Twilight-Logic/AR488/(threads)

Thread 2 (2019-02-10):

Invalid conversion from 'void (*)()' to 'void (*)(char*) compilation errors

Twilight-Logic, 2019-02-10:
..does not compile. Errors are
AR488-0-45-10:758: error: invalid conversion from 'void (*)()' to 'void (*)(char*)' [-fpermissive]
plenty of them..
AR488-0-45-10:758: error: invalid conversion from 'void (*)()' to 'void (*)(char*)' [-fpermissive]

UPDATE:
error handling seems to have been downgraded to warnings after updating Arduino IDE fro 1.6.5 to 1.8.19
Kutte

Twilight-Logic, 2019-02-12:
Have tested with the standalone IDE version 1.8.7 and 1.8.8 downloaded directly from the Arduino site and did not receive the errors or warnings. However, then tested with v1.8.8/1.8.19.0 downloaded from the Windows 10 store and discovered that these warnings do indeed appear.

Will investigate further to see whether the code can be adjusted to avoid them.

Twilight-Logic, 2019-02-12:
Line 413: changed the expression NULL to character expression '\0'.

Twilight-Logic, 2019-02-14:
Further warnings reported by Kutte:

Y:\USB_16GB\Voltage reference\GPIB\ar488-arduino\ar488\AR488.ino:153:0: warning: "SPE" redefined

 #define SPE 0x18

In file included from c:\program files (x86)\arduino\hardware\tools\avr\avr\include\avr\io.h:272:0,
                 from c:\program files (x86)\arduino\hardware\tools\avr\avr\include\avr\pgmspace.h:90,
                 from C:\Program Files (x86)\Arduino\hardware\arduino\avr\cores\arduino/Arduino.h:28,
                 from sketch\AR488.ino.cpp:1:
c:\program files (x86)\arduino\hardware\tools\avr\avr\include\avr\iom328p.h:294:0: note: this is the location of the previous definition
 #define SPE 6
Y:\USB_16GB\Voltage reference\GPIB\ar488-arduino\ar488\AR488.ino:758:1: warning: ISO C++ forbids converting a string constant to 'char*' [-Wwrite-strings]

 Y:\USB_16GB\Voltage reference\GPIB\ar488-arduino\ar488\AR488.ino:758:1: warning: ISO C++ forbids converting a string constant to 'char*' [-Wwrite-strings]

Y:\USB_16GB\Voltage reference\GPIB\ar488-arduino\ar488\AR488.ino:758:1: warning: invalid conversion from 'void (*)()' to 'void (*)(char*)' [-fpermissive]

Y:\USB_16GB\Voltage reference\GPIB\ar488-arduino\ar488\AR488.ino:758:1: warning: ISO C++ forbids converting a string constant to 'char*' [-Wwrite-strings]

Twilight-Logic, 2019-03-01:
In the new release of the code (0.46.01), the names of the #define variables related to GPIB commands (e.g. SPE) have been changed to avoid clashes with other Arduino modules.

Twilight-Logic, 2019-03-25:
Further corrections made to the code to remove all warnings. By default it seems that this setting is now set to None, so all warnings were hidden. Compilation is now done with the Arduino IDE set to show ALL compiler warnings.

Closed 2019-03-25.

Thread 4 (2019-03-03):

Ground

cabo, 2019-03-03:
Shouldn't the manual point out that it is good to have a ground connection?
(Or, actually, seven of them?)
Maybe too obvious to an EE :-)

Twilight-Logic, 2019-03-12:
Thanks for pointing this out. The table in the manual was focused on the control and data bus wires but indeed the ground connection should not be omitted. I will be adding a couple of diagrams to the manual and will correct this oversight at he same time.

Closed 2019-03-25.

Thread 5 (2019-03-04):

First character of ++read result is being garbled when reading some devices

Twilight-Logic, 2019-03-04:
Reported by user Krampmeier on EEVblog, using version v0.46.10.

Version 0.46.01:

Communication with my HP 4192A impedance analyzer sees to work fine, but when I sent *IDN? to a Keithley 2001, the first 1 to 3 characters of the response were always wrong. Same with a Keithley 2010.

I just tried it again:
Quote

    *idn?
    ++read
    OEITHLEY INSTRUMENTS INC.,MODEL 2010,0632912,A15  /A02
    fetch?
    ++read
    m9.59916086E-01
    :SENS:FUNC?
    ++read
    bVOLT:DC"

Edit: I just noticed that the Keithley's display twitches when I send the ++read command. The instrument also clears the "REM" indicator, so it goes out of remote mode. Hmmm. Did I make a mistake in the wiring?

Version 0.46.10:

It compiled just fine, but I still get the problems with the first character of the device response, and the device going out of remote mode.

Keithley 2010
Code: [Select]

AR488 GPIB controller, version 0.46.10, 02/03/2019
⸮5.49378228E-01
OEITHLEY INSTRUMENTS INC.,MODEL 2010,0632912,A15  /A02

Keysight E36312A
Code: [Select]

⸮eysight Technologies,E36312A,MY57290136,1.1.1-1.0.2-1.05

Keithley 196 - no communication at all, does not go into remote mode. Broken GPIB interface?

Adret 103A - works fine, but this is a "listen only" device.

Any ideas on what might be going wrong with the Keithley and Keysight devices?
I use about one meter of ribbon cable, not a genuine GPIB cable, but I have seen GPIB work fine with much longer ribbon cables, and 8 devices on the bus...

Edit:
The effect changes when DEBUG7 is defined and I switch verbose mode on:
Code: [Select]

> *idn?
> ++read
OAfter loop:
2
0
0
Bytes read: 1

> ++read
MTHLEY INSTRUMENTS INC.,MODEL 2010,0632912,A15  /A02
After loop:
2
0
0
Bytes read: 54

Twilight-Logic, 2019-03-25:
Devices identified with the read problem:

Keithley 196 - no communication?
Keithley 2001 - up to 1st 3 characters garbled
Keithley 2010 - up to 1st 3 characters garbled
Keithely 2015 - some reads OK, others showing just 1 character

Keysight E36312A

HP53310A

Twilight-Logic, 2019-05-29:
Issue was related to a timing error in the code.
This is now fixed.

mimmus78, 2019-11-17:
I have the same problem with a device ILX LTD-5910.

I'm using current version that is:

AR488 GPIB controller, ver. 0.47.53, 25/10/2019

This device is a TEC temperature controller, if I read the current temperature I get always a 3 at begging of the string so that the "20.3" string become "30.3" and only very few times it read the right value.

If I read calibration string I get "�LX CALDATE 7-5-89" while it should be "ILX CALDATE 7-5-89".

Any help?

Twilight-Logic, 2019-11-18:
Could you please enable DEBUG7 and DEBUG1 and also ++verbose send me the output please. Thanks.

mimmus78, 2019-11-18:
No problem, I should have some time this evening to give it a run.

mimmus78, 2019-11-18:
I had to fix a compile error when enabling debug1 ... at line 911 of the AR488.ino file it was using the old "plusCmdIdx" instead of "cmdHidx".

mimmus78, 2019-11-18:
Here is the log. Few words:

D2 - read current temperature - here should be `19.4` but it reads `39.4`
G9 - read the calibration string - here should be `ILX CALDATE 7-5-89` but it reads `ËLX CALDATE 7-5-89`

```
Welcome to minicom 2.7

OPTIONS: I18n
Compiled on Apr 22 2017, 09:14:19.
Port /dev/ttyACM0, 20:43:06

Press CTRL-A Z for help on special keys

parseInput: Received ++verbose
isCmd: Command detected.
processLine: Received: 2B 2B 76 65 72 62 6F 73 65
processLine: Sent to the command processor: 76 65 72 62 6F 73 65
getCmd: verbose - length:7
getCmd: process token: verbose
getCmd: found handler for: verbose
Verbose: ON

> ++ver
parseInput: Received ++ver
isCmd: Command detected.
processLine: Received: 2B 2B 76 65 72
processLine: Sent to the command processor: 76 65 72

getCmd: ver - length:3
getCmd: process token: ver
getCmd: found handler for: ver
AR488 GPIB controller, ver. 0.47.53, 25/10/2019

> ++addr 4
parseInput: Received ++addr 4
isCmd: Command detected.
processLine: Received: 2B 2B 61 64 64 72 20 34
processLine: Sent to the command processor: 61 64 64 72 20 34

getCmd: addr 4 - length:6
getCmd: process token: addr
getCmd: found handler for: addr
Calling handler with parameters: 4
Set device primary address to: 4

> G9
parseInput: Received G9
processLine: Received: 47 39
processLine: Sent to the instrument: 47 39

> ++read
parseInput: Received ++read
isCmd: Command detected.
processLine: Received: 2B 2B 72 65 61 64
processLine: Sent to the command processor: 72 65 61 64

getCmd: read - length:4
getCmd: process token: read
getCmd: found handler for: read
CB 4C 58 20 43 41 4C 44 41 54 45 20 37 2D 35 2D 38 39 D A After loop:
0
0
Bytes read: 19

> D2
parseInput: Received D2
processLine: Received: 44 32
processLine: Sent to the instrument: 44 32

> ++read
parseInput: Received ++read
isCmd: Command detected.
processLine: Received: 2B 2B 72 65 61 64
processLine: Sent to the command processor: 72 65 61 64

getCmd: read - length:4
getCmd: process token: read
getCmd: found handler for: read
33 39 2E 34 D A After loop:
0
0
Bytes read: 5
```

mimmus78, 2019-11-19:
So I was checking the code and at first I cannot se what can go wrong, but than I noticed that you read just after setting the pullup bits. Maybe due to some capacitance in the adapter or instrument itself it takes some time to settle. So by just adding some delay should solve this issue. Unfortunately I cannot check this before this evening.

Twilight-Logic, 2019-11-19:
Thank you for the detail you have provided. I ran some tests using the Keithley 2000 to make sure that the previous issue hadn't re-surfaced and I could not replicate the problem. There were no dropped or garbled characters. However, since I do not have a ILX LTD-5910 to test with, I have no means to verify the issue.

Can I ask how you are connecting the instrument to the AR488 board? Are you using a cable of some sort, or a plug directly mounted on a PCB? Looking at the binary for the initial garbled characters, there is perhaps one common pattern in both cases it seems that adjacent bits had been added to the original character, but this is by no means conclusive given my sample of only two items of data. Whether this is down to capacitance between adjacent wires or setting time I cannot be sure at this time, but these do seem plausible explanations.

Your suggestion of adding some delay is certainly worth a try. By all means add a few microseconds of delay and see what happens. I would certainly be interested in the result.

mimmus78, 2019-11-19:
Good news. Just changed read function to this:

```
uint8_t readGpibDbus() {
  // Set data pins to input
//  DDRD &= 0b11001111 ;
//  DDRC &= 0b11000000 ;
  DDRF &= 0b00000000 ;

//  PORTD |= 0b00110000; // PORTD bits 5,4 input_pullup
//  PORTC |= 0b00111111; // PORTC bits 5,4,3,2,1,0 input_pullup
  PORTF |= 0b11111111; // set PORTC bits to input_pullup

  delayMicroseconds(1000);

  // Read the byte of data on the bus
  return ~(PINF & 0b11111111);
}

```
and it now reads ok.

mimmus78, 2019-11-19:
I think the possible solution can be to add some configurable delay there like the other delay already used ```delayMicroseconds(AR488.tmbus);``` in gpibReadByte

mimmus78, 2019-11-19:
This is the adapter ... I don't think it can be the cause, most probably it's the instrument itself
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

Twilight-Logic, 2019-11-19:
Thank you for carrying out that test and confirming that this worked. This would seem to confirm that some settling time needs to be allowed after setting the pull-ups before data is read, although I would not have expected that a delay of 100µs would be necessary. Interesting to note that 10µs did not work as I would have expected no more than maybe 5µs. Could I trouble you to try 50µs and if that would, then maybe 20µs and 30µs? I will add a configurable delay to the next release. If you can determine what the minimal delay is for your instrument, then that should provide a sensible benchmark for a default setting.

BTW, thanks for the picture of your adapter. Others have successfully used a ribbon cable and your cable is quite short so I would tend to agree that this is unlikely to be the cause unless you had a noise source (e.g. LED lamp, wallwart or something) close to the cable.

mimmus78, 2019-11-20:
No problem, I will make few more tests.

mimmus78, 2019-11-21:
Assuming all pins on the bus to have similar capacitance

I was thinking that if we pull-up data lines at the same time of unasserting NRFD both "pull-up" should have the "same" propagation delay over the bus. In this case we will never receive DAV before all lines are pulled-up and so no additional delay is needed when we read from bus.

So if in function `uint8_t gpibReadByte(uint8_t *db)` just before unassert NRFD we add a simple `readGpibDbus();` should work.

What you think?

mimmus78, 2019-11-21:
Tested and readGpibDbus(); in function uint8_t gpibReadByte(uint8_t *db) just before unassert NRFD works ... so if this is ok, I think is the best solution.

Twilight-Logic, 2019-11-22:
Thank you for spending a bit of time on this, doing the tests and coming up with a solution. What I think I might do is split the readGpibDbus() function into two. The first function will set the lines to input pullup mode, and the second will just read the value on the bus. In fact, it might be better for the setting of the data bus to listen mode to happen just before the data read while loop in bool gpibReceiveData(). That way, it is only still set in advance of NRFD being unasserted and needs to be set only once before a complete sequence of data is read avoiding additional CPU cycles. I will test this approach. Would you be willing to test on your adapter once I have the code ready?

mimmus78, 2019-11-22:
No problem at all, I'm happy I can help you a little bit in this project. Let me know when you complete the changes. I will trow some Python snake in coming days for the instrument for my purposes so it should also be easy to make some automatic test to make a more complete test for reading and writing.

Twilight-Logic, 2019-11-22:
I have added the changes. Could you try the attached to see if it works on your adapter. If all is well, I will release it as the next version.

[AR488.zip](https://github.com/Twilight-Logic/AR488/files/3881169/AR488.zip)

Thannks.

mimmus78, 2019-11-24:
It's a MEGA2560, not a nano ... let me know if test version is still valid even if board is not a nano.

Twilight-Logic, 2019-11-25:
Ah sorry, yes indeed it is! I can also confirm that the test version is valid for a Mega2560. I applied the update to all boards.

mimmus78, 2019-11-26:
I will test it during this weekend ... hope to have some script to test reliability of the communication too.

mimmus78, 2019-11-27:
Well I think I have similar problem also for writing. In terminal it all seems ok, but I tested only for sending at speed that is equal to my typing speed. When using python snake and sending all the string at one time it does not works. I was checking the code and noticed that you have AR488.tmbus delay there that sets some delay between bytes. It's worth checking this option, I'll let you know if it works.

Twilight-Logic, 2019-11-27:
When using a script it is necessary to have some delay between commands to allow the interface to process each command and catch up, otherwise the buffer gets full at which point the serial port blocks and any further data sent gets lost until the buffer clears. I wish there was better handling of the serial port but this would probably require some kind of handshaking within the protocol.

The tmbus parameter adds a small delay between characters being sent to the bus. The larger the number the slower the transmission. The GPIB handshake should handle things so that this should not really by required (GPIB should run at the speed f the slowest instrument) and this was experimental so should not be needed. However, I look forward to your findings.

mimmus78, 2019-11-28:
I tested with 1 second delay for each command, and nothing. Tested with tmbus set at 100us and 1000us and still nothing. So I tested by sending one byte at time, with a delay of 100ms between chars (sorta emulating what I do when running by terminal) but it still doesn't works. Neither read or write works.

One can think that I made some stupid thing with serial setup in the python script but I think we can exclude this because "++ver" works as I can read the adapter version string by the python script. Also "++addr 4" works because I can see the instrument going in remote mode. Same with "++verbose" as I can read the diagnostic messages from the adapter once activated verbose mode.

I need to make some more tests ... the thing that by terminal emulation works and by python script (even when sending 1 byte at time) doesn't makes no sense.

mimmus78, 2019-11-29:
So I found that after D2 command the instrument need a couple of seconds to "update" current temperature. If you make any read request before this two seconds it will become irresponsive for few more seconds and many times it will sorta crash the GPIB interface.

So the fix is to add a sleep(2s) after the D2 command. This problem was not stated on the manual and unfortunately the sleep(1s) that I already was trying after every command was not enough.

So besides I need to make more tests to check reliability, now everything seems to work.

All the tests up to now where done with my old fix, this weekend I'll try the version you attached with some more in deep test script and let you know the results.

Twilight-Logic, 2019-11-29:
Thank you for your ongoing tests. It is interesting to note the behaviour of different instruments. Perhaps this is how long it takes for the instrument to read the probe temperature reliably? In any case, the Arduino has a small buffer and limited memory so will very quickly get bogged down with repeated requests when there is no reply. Without a delay a script could send dozens of requests within that time and the Arduino, having such a small buffer and memory, would get bogged down pretty quickly. You could experiment with the read_tmo_ms parameter, as shortening that would mean that the interface woul spend less time waiting for a timemout and so free up resources quicker, but I doubt that it would have made much difference with a delay as long as 2 seconds.

I am glad that the pullup_timing fix has been helpful and that you have found a solution to the script problem. I have found that instrument response timing often requires a bit of trial and error. I found for example that my Solartron requires a delay of about 200ms between responses in its default mode, but other modes send data quicker so the instrument can be polled faster. I hope your deep test goes OK and would be interested to hear about the results.

mimmus78, 2019-12-03:
So was busy in writing a test script for GPIB with this instrument and to run them with my pathed version. The instrument is very slow by its own at processing commands, so I really cannot stress the bus that much, but I can confirm it works ok now.

I run also multi-hours real use case test during this week-end (still with my version) to check stability of the link and all is fine.

I think I will have some time to load your version in next couple of days and have it tested too so that the issue can be closed.

Twilight-Logic, 2019-12-04:
Ok, thanks for the progress update.

mimmus78, 2019-12-06:
The zip is missing AR488_Layouts.h ... I tried to use the original but I think is missing some new definitions. Maybe you want also to create a branch for the test.

Twilight-Logic, 2019-12-07:
Sorry about that, although that seems rather weird! I have checked my local copy and re-uploaded it. Hopefully should now be OK.

I do create a git branch for testing and then merge everything back in, but I specified the wrong version number and something seems to have gone awry with the last merge. I believe I have now corrected it.

mimmus78, 2019-12-07:
So I run some tests and it's working.

Twilight-Logic, 2020-01-05:
Glad to hear all was OK. Thank you for the feedback.
Enough time has elapsed for further comments so I guess this can now be closed.

Closed 2020-01-05.

Thread 7 (2019-09-25):

Two main questions 1.atmega168 ok? 2 only use atmega328p/168p direct to rs232 with max232/max3232?

youxiaojie, 2019-09-25:
three major and three minor questions
0.does this support labview?
1.only use atmega328p/168p direct to rs232 with max232/max3232?
detailed :
1.does atmega 168 works ok?
2.I burn atmega 328/168 with ardunio uno and move to a pcb with power supply, max232/max3232 rs232 TTL voltage converter and then connect COM1 port of computer, and ardunio connect to gbip?
3. I see almost full of converter has sn7516x as isolation why there is no such things?Is it easy to damage atmega328p?
4. If I use another arduino but some pin is occupied by led, can I change the pin?
thanks!
5 atmega 32u4 has internal usb can it be modified to use this?(use lufa get a serial port?)

Twilight-Logic, 2019-09-29:
Thank you for your questions. I hope the information below answers at least some of your points.

0.does this support labview?
A. I have not tested it with Labview as I do not have and cannot afford the software, but Labview  does support Prologix interfaces. I noted from a couple of forum posts that you need to send CRLF and have ++auto 1 turned on. I would be interested to know myself whether Labview works with the AR488 using the Prologix driver.

1.only use atmega328p/168p direct to rs232 with max232/max3232?
1.does atmega 168 works ok?
A. The firmware has been tested with the Uno (328p) and Mega 2560. I see no reason why it should not work with a 328p IC with an external MAX232/MAX3232 chip, provided that the signal voltage levels between the two chips are compatible. The cheap clones use a CH340 UART and I would expect a MAX UART to work in a similar way. At present I do not have the means to test the 168p, although it does seem to be pin compatible with the 328p. If you happen to try it, then I would be interested in your results. I will see whether I can procure a development board to test it. If you do happen to test it, then please could you let me know your findings?

2.I burn atmega 328/168 with ardunio uno and move to a pcb with power supply, max232/max3232 rs232 TTL voltage converter and then connect COM1 port of computer, and ardunio connect to gbip?
A. I see no reason why it shouldn't communicate via the COM1 port of a computer, although the maximum achievable baud rate may be lower than that which can be emulated over USB. If by 'arduinio' you mean the 328p (or 168p) then yes, the appropriate 328p GPIO pins would need to be somehow connected to the GPIB bus. In principle, it looks like your idea should work and I will be interested to know how your project turns out.

3. I see almost full of converter has sn7516x as isolation why there is no such things?Is it easy to damage atmega328p?
A. I would not advise running more than 2 or 3 devices from it due to the current handling of the GPIO outputs, however, in a 1:1 scenario there should be no problem. So far, I have had no reports of damage to the GPIO outputs, but of course, everyone has a different level of skill and confidence, so it is impossible to rule out ANY form of damage, but provided that everything is wired correctly, there should be no problem. However, please read the section 'Multiple Arduinos on the bus and problems with instruments in the manual. There are two reasons for the lack of SN7516x type isolation: firstly, a shortage of pins on the 328p, and secondly additional cost. Having said that, someone did mention about developing a shield for that. Now that the code has been ported to the Mega (with other boards possibly to follow) it opens up further possibilities which could be developed in time.

4. If I use another arduino but some pin is occupied by led, can I change the pin?
thanks!
A. You could remove the LED or, in version 0.47.xx of the firmware there will be an option to specify a custom layout so you could use another pin.

5 atmega 32u4 has internal usb can it be modified to use this?(use lufa get a serial port?)
A. Interesting thought. It has already been mentioned by artag, who has successfully experimented with using that board (for the code see contributors on the Github). It seems that it worked despite the 3.3v output with 1 device on the GPIB bus, but he hasn't implemented that particular feature yet. I have just received a couple of 32u4 boards to experiment with myself and it is something I would like to investigate in due course.

Twilight-Logic, 2019-10-13:
Atrag's 32u4 port has now been merged into the codebase and the Micro is now supported. The manual has been updated with the pinout for that board. It currently employs serial over USB.

youxiaojie, 2019-10-15:
that is great!!

Twilight-Logic, 2019-10-25:
No further comments so issue closed.

Closed 2019-10-25.

Thread 9 (2020-01-22):

Arduino Pro Micro (32U4 chinese clone) works only if USE_SERIALEVENT is not defined

krasimirk, 2020-01-22:
Hello,
I tried to run the AR488.ino on Arduino Pro Micro, but I do not get any answer from the FW.
After the debug I found that if I comment out USE_SERIALEVENT, the code is working.
This is not request for bug fixing, just a tip for workaround if somebody have the same problem.
I do not have time to investigate why the original code does not work.
Regards,
Krasimir Kostadinov

Twilight-Logic, 2020-01-22:
Krasimir, thank you for your feedback. After a little online investigation is would seem that unfortunately SerialEvent is not available on the Leonardo, Micro or other 32u4 boards:

https://www.arduino.cc/en/Tutorial/SerialEvent

I presume that this is because the interrupt is not generated by CDC serial ports. The above link is the only mention I could find in the official documentation, and even then, the mention is found only within the comments of the provided code example! It was mentioned in a couple of forums though.

I will amend the code in the next release to take into account the lack of support for this interrupt on 32u4 boards.

krasimirk, 2020-01-23:
Welcome!
I tested successfully HP 34401 with basic SCPI commands for measurements, mode settings etc.
Thank you for spending your time to make available this very useful FW!
Let me know if you need support for testing it for different DMMs. I own HP 34401/Advantest R6581T at home and I have access to Keithley 2000, 2002, Rigol DM3068 at work. A friend of mine has HP 3478 as well.
I made the "artag" version of the AR488 PCB.
Regards!

Twilight-Logic, 2020-01-24:
I am glad that worked Ok. Thank you also for your offer of support for testing on various instruments. Are any of your instruments capable of using secondary addressing? I already know that the Keithley 2000 iand the HP3478 are not. Just wondering about the others you mention?

Tha "artag" version was actually contributed by member Artag on the EEVblog forum. He was particularly keen to use the Pro Micro board because it is nice and compact.

krasimirk, 2020-01-24:
Hello,
According K2002 : " Note, however, that many devices, including the Model 2002, do not use secondary addressing."
In Hp 34401 manual, I can see only that addresses can be set between 0 and 31 (31 is talk only addrress) which are primary addresses.
For R6581T I can check on the real DMM today later. Documentation is in Japanese only and my wife and daughter reject to help me to translate it to English :-(.
Have a nice day.
P.S. : you can close the issue and contact me at krasimir.k at gmail.

Twilight-Logic, 2020-01-24:
The reason I asked is because the original Prologix did provide a secondary addressing feature. Since I didn't have an instrument that supported it, I couldn't implement and test it. So far though, no one whom I have asked so far has an instrument that actually made use of secondary addressing either. I'm not sure what, if anything actually uses it!

Since the problem has now been addressed I will now close this issue.

Full details of workaround for firmware 0.48.03 here:
https://www.eevblog.com/forum/projects/ar488-arduino-based-gpib-adapter/msg2882824/#msg2882824

The problem is fixed in firmware version 0.48.07.

Closed 2020-01-24.

Thread 11 (2020-11-03):

Can't break out of read with ++ command

dgesswein, 2020-11-03:
If you have a read from device in progress such as ++read eoi and the device wasn't set to send eoi you can't use a ++ command to recover.

Twilight-Logic, 2020-12-18:
Thank you for your report. Please could you confirm which Arduino board you are using and what options you have set? Perhaps attach a copy of your AR488_Config.h. Thanks.

dgesswein, 2020-12-19:
Its a UNO. File attached.

#ifndef AR488_CONFIG_H
#define AR488_CONFIG_H

/*********************************************/
/***** AR488 GLOBAL CONFIGURATION HEADER *****/
/***** vvvvvvvvvvvvvvvvvvvvvvvvvvvvvvvvv *****/

/***** Firmware version *****/
#define FWVER "AR488 GPIB controller, ver. 0.48.29, 11/01/2020"

/***** BOARD CONFIGURATION *****/
/*
 * Platform will be selected automatically based on
 * Arduino definition.
 * Only ONE board/layout should be selected per platform
 * Only ONE Serial port can be used to receive output
 */

/*** Custom layout ***/
/*
 * Uncomment to use custom board layout
 */
//#define AR488_CUSTOM

/*
 * Configure the appropriate board/layout section
 * below as required
 */
#ifdef AR488_CUSTOM
  /* Board layout */
  /*
   * Define board layout in the AR488 CUSTOM LAYOUT
   * section below
   */
  /* Serial ports */
  #define AR_HW_SERIAL
  #define AR_SERIAL_PORT Serial
  //#define AR_SERIAL_PORT Serial1
  //#define AR_SERIAL_PORT Serial2
  //#define AR_SERIAL_PORT Serial3
  //#define AR_CDC_SERIAL
  //#define AR_SW_SERIAL

/*** UNO and NANO boards ***/
#elif __AVR_ATmega328P__
  /* Board/layout selection */
  #define AR488_UNO
  //#define AR488_NANO
  /*** Serial ports ***/
  //Select HardwareSerial or SoftwareSerial (default = HardwareSerial) ***/
  // The UNO/NANO default hardware port is 'Serial'
  // (Comment out #define AR_HW_SERIAL if using SoftwareSerial)
  #define AR_HW_SERIAL
  #ifdef AR_HW_SERIAL
    #define AR_SERIAL_PORT Serial
    #define USE_SERIALEVENT
  #else
    // Select software serial port
    #define AR_SW_SERIAL
  #endif

/*** MEGA 32U4 based boards (Micro, Leonardo) ***/
#elif __AVR_ATmega32U4__
  /*** Board/layout selection ***/
  #define AR488_MEGA32U4_MICRO  // Artag's design for Micro board
  //#define AR488_MEGA32U4_LR3  // Leonardo R3 (same pin layout as Uno)
  /*** Serial ports ***/
  // By default the CDC serial port is used
  // Comment out #define AR_CDC_SERIAL if using RXI, TXO pins
  #define AR_CDC_SERIAL
  #ifdef AR_CDC_SERIAL
    // The Mega 32u4 default port is a virtual USB CDC port named 'Serial'
    #define AR_SERIAL_PORT Serial
  #else
    // Use hardware port Serial1
    #define AR_HW_SERIAL
    #define AR_SERIAL_PORT Serial1
  #endif

/*** MEGA 2560 board ***/
#elif __AVR_ATmega2560__
  /*** Board/layout selection ***/
  #define AR488_MEGA2560_D
  //#define AR488_MEGA2560_E1
  //#define AR488_MEGA2560_E2
  /*** Serial ports ***/
  // Mega 2560 supports Serial, Serial1, Serial2, Serial3. Since the pins
  // associated with Serial2 are used in the default pin layout, Serial2
  // is unavailable. The default port is 'Serial'. Choose ONE port and
  // associated SERIALEVENT definition
  #define AR_HW_SERIAL
  #define AR_SERIAL_PORT Serial
  #define USE_SERIALEVENT
  //#define AR_SERIAL_PORT Serial1
  //#define USE_SERIALEVENT1
  //#define AR_SERIAL_PORT Serial3
  //#define USE_SERIALEVENT3

#endif  // Board/layout selection

/***** Software Serial Support *****/
/*
 * Configure the SoftwareSerial TX/RX pins and baud rate here
 * Note: SoftwareSerial support conflicts with PCINT support
 * When using SoftwareSerial, disable USE_PCINTS and enable
 * USE_PINHOOKS
 */
#ifdef AR_SW_SERIAL
  #define AR_SW_SERIAL_RX 53
  #define AR_SW_SERIAL_TX 51
  #define AR_SW_SERIAL_BAUD 57600
#else
  #define AR_SERIAL_BAUD 115200
#endif
/*
 * Note: SoftwareSerial reliable only up to a MAX of 57600 baud only
 */

/***** Pin State Detection *****/
/*
 * With UNO. NANO and MEGA boards with pre-defined layouts,
 * USE_PCINTS can be used.
 * With the AR488_CUSTOM layout and unknown boards, USE_PINHOOKS must
 * be used. Interrupts are used on pre-defined AVR board layouts and will
 * respond faster, however "pinhooks" (in-loop checking for state of pin)
 * can be supported with any board layout.
 */
#ifdef __AVR__
  // For supported boards use interrupt handlers
  #if defined (AR488_UNO) || defined (AR488_NANO) || defined (AR488_MEGA2560) || defined (AR488_MEGA32U4)
    #define USE_INTERRUPTS
  #else
    // For other boards use in-loop checking
    #define USE_PINHOOKS
  #endif
#else
  #define USE_PINHOOKS
#endif

/***** Enable Macros *****/
/*
 * Uncomment to enable macro support. The Startup macro allows the
 * interface to be configured at startup. Macros 1 - 9 can be
 * used to execute a sequence of commands with a single command
 * i.e, ++macro n, where n is the number of the macro
 *
 * USE_MACROS must be enabled to enable the macro feature including
 * MACRO_0 (the startup macro). RUN_STARTUP must be uncommented to
 * run the startup macro when the interface boots up
 */
//#define USE_MACROS    // Enable the macro feature
//#define RUN_STARTUP   // Run MACRO_0 (the startup macro)

/***** Enable SN7516x chips *****/
/*
 * Uncomment to enable the use of SN7516x GPIB tranceiver ICs.
 * This will require the use of an additional GPIO pin to control
 * the read and write modes of the ICs.
 */
//#define SN7516X
#ifdef SN7516X
  #define SN7516X_TE 6
//  #define SN7516X_DC 13
//  #define SN7516X_SC 12
#endif

/***** Bluetooth (HC05) support *****/
/*
 * Uses built-in LED on GPIO pin 13 to signal status
 */
//#define AR_BT_EN 12             // Bluetooth enable and control pin
#ifdef AR_BT_EN
  #define AR_BT_BAUD 115200     // Bluetooth module preferred baud rate
  #define AR_BT_NAME "AR488-BT" // Bluetooth device name
  #define AR_BT_CODE "488488"   // Bluetooth pairing code
#endif

/***** Debug options *****/
// Uncomment to send debug messages to another port
//#define DB_SERIAL_PORT Serial1
// Configure alternative port for debug messages
#define DB_SERIAL_BAUD 115200
#define DB_HW_SERIAL
#ifdef DB_SW_SERIAL
  #define DB_SW_SERIAL_RX 53
  #define DB_SW_SERIAL_TX 51
#endif
// Configure debug level
//#define DEBUG1  // getCmd
//#define DEBUG2  // setGpibControls
//#define DEBUG3  // gpibSendData
//#define DEBUG4  // spoll_h
//#define DEBUG5  // attnRequired
//#define DEBUG6  // EEPROM
//#define DEBUG7  // gpibReceiveData
//#define DEBUG8  // ppoll_h
//#define DEBUG9  // bluetooth
//#define DEBUG10 // ID command

/***** ^^^^^^^^^^^^^^^^^^^^^^^^^^^^^^^^^ *****/
/***** AR488 GLOBAL CONFIGURATION HEADER *****/
/*********************************************/

/*******************************/
/***** AR488 CUSTOM LAYOUT *****/
/***** vvvvvvvvvvvvvvvvvvv *****/
#ifdef AR488_CUSTOM

#define DIO1  A0  /* GPIB 1  */
#define DIO2  A1  /* GPIB 2  */
#define DIO3  A2  /* GPIB 3  */
#define DIO4  A3  /* GPIB 4  */
#define DIO5  A4  /* GPIB 13 */
#define DIO6  A5  /* GPIB 14 */
#define DIO7  4   /* GPIB 15 */
#define DIO8  5   /* GPIB 16 */

#define IFC   8   /* GPIB 9  */
#define NDAC  9   /* GPIB 8  */
#define NRFD  10  /* GPIB 7  */
#define DAV   11  /* GPIB 6  */
#define EOI   12  /* GPIB 5  */

#define SRQ   2   /* GPIB 10 */
#define REN   3   /* GPIB 17 */
#define ATN   7   /* GPIB 11 */

#endif
/***** ^^^^^^^^^^^^^^^^^^^ *****/
/***** AR488 CUSTOM LAYOUT *****/
/*******************************/

/********************************/
/***** AR488 MACROS SECTION *****/
/***** vvvvvvvvvvvvvvvvvvvv *****/
/*
 * (See the AR488 user manual for details)
 */
#ifdef USE_MACROS

/***** Startup Macro *****/

#define MACRO_0 "\
++addr 9\n\
++auto 2\n\
*RST\n\
:func 'volt:ac'\
"
/* End of MACRO_0 (Startup macro)*/

/***** User macros 1-9 *****/

#define MACRO_1 "\
++addr 3\n\
++auto 0\n\
M3\n\
"
/*<-End of macro*/

#define MACRO_2 "\
"
/*<-End of macro 2*/

#define MACRO_3 "\
"
/*<-End of macro 3*/

#define MACRO_4 "\
"
/*<-End of macro 4*/

#define MACRO_5 "\
"
/*<-End of macro 5*/

#define MACRO_6 "\
"
/*<-End of macro 6*/

#define MACRO_7 "\
"
/*<-End of macro 7*/

#define MACRO_8 "\
"
/*<-End of macro 8*/

#define MACRO_9 "\
"
/*<-End of macro 9*/

#endif
/***** ^^^^^^^^^^^^^^^^^^^^ *****/
/***** AR488 MACROS SECTION *****/
/********************************/

/******************************************/
/***** !!! DO NOT EDIT BELOW HERE !!! *****/
/******vvvvvvvvvvvvvvvvvvvvvvvvvvvvvv******/

/*********************************************/
/***** SERIAL PORT EXTERNAL DECLARATIONS *****/
/******vvvvvvvvvvvvvvvvvvvvvvvvvvvvvvvvv******/

#ifdef AR_CDC_SERIAL
  extern Serial_ *arSerial;
  #ifndef DB_SERIAL_PORT
    extern Serial_ *dbSerial;
  #endif
#endif
#ifdef AR_HW_SERIAL
  extern HardwareSerial *arSerial;
  #ifndef DB_SERIAL_PORT
    extern HardwareSerial *dbSerial;
  #endif
#endif
// Note: SoftwareSerial support conflicts with PCINT support
#ifdef AR_SW_SERIAL
  #include <SoftwareSerial.h>
  extern SoftwareSerial *arSerial;
  #ifndef DB_SERIAL_PORT
    extern SoftwareSerial *dbSerial;
  #endif
#endif

/***** Debug Port *****/
#ifdef DB_SERIAL_PORT
  #ifdef DB_CDC_SERIAL
    extern Serial_ *dbSerial;
  #endif
  #ifdef DB_HW_SERIAL
    extern HardwareSerial *dbSerial;
  #endif
  // Note: SoftwareSerial support conflicts with PCINT support
  #ifdef DB_SW_SERIAL
    #include <SoftwareSerial.h>
    extern SoftwareSerial *dbSerial;
  #endif
#endif

/******^^^^^^^^^^^^^^^^^^^^^^^^^^^^^^^^^******/
/***** SERIAL PORT EXTERNAL DECLARATIONS *****/
/*********************************************/

/*********************************************/
/***** MISCELLANEOUS DECLARATIONS *****/
/******vvvvvvvvvvvvvvvvvvvvvvvvvvvvvvvvv******/

#define AR_CFG_SIZE 84

/******^^^^^^^^^^^^^^^^^^^^^^^^^^^^^^^^^******/
/***** MISCELLANEOUS DECLARATIONS *****/
/*********************************************/

#endif // AR488_CONFIG_H

Twilight-Logic, 2020-12-21:
Thank you. I have confirmed the issue and will update as soon as I have a solution.

Twilight-Logic, 2021-01-12:
Fixed in version 0.49.12

Closed 2021-01-12.

Thread 12 (2020-11-03):

Issues with serial data buffering

dgesswein, 2020-11-03:
Thanks for creating this and releasing with a GPL license.

I found changes that improve the ability to send data without needing arbitrary delays.

#if used or of not defines so if any of the USE_SERIAL weren't defined it activated the polling code. Since normally only one is defined the polling was always active.

#if not defined (USE_SERIALEVENT) && not defined (SERIALEVENT1) && not defined (SERIALEVENT2) && not defined (SERIALEVENT3)

And this didn't terminate the loop when it found a command so if two commands were sent close enough together they would be concatenated and it would try to parse them as one command. I made it exit and process the command when found.

  while (arSerial->available() && lnRdy == 0) {

This gets it to the state for me on an Uno board that I can send ++ commands without delays and they are correctly processed for the commands I tried.

With these changes I can send another instrument command while the current is processing without delay but can't send more than that without it getting corrupted.

I had started doing some work on a more complete fix before I found the issues above. I think to allow buffering of multiple commands up to buffer size the parsing needs to be separate from the buffering so we don't loose where the command boundaries are. I was looking at changing the serial interrupt/polling to copy to a buffer with a new routine. Those polls could also be put in the instrument transfer loops to allow the non interrupt version to not loose serial data while sending/receiving data. The main loop would then use a modified parseInput which removes the next command from the buffer for processing.

This does complicate readBreak. I wasn't sure how that was supposed to work. Should read exit if anything is received, only if ++ is received, what about if a non ++ command is received before a ++?

Was looking at using circular buffer to make it easy to remove the command processed without clearing the entire buffer and not have race conditions with interrupt.

I also removed this line since it was unlikely to be doing anything useful. If it needs to check those three characters it needs to be three separate comparisons.
Currently its checking for *buffr == 1 since (0 || 10 || 13) == 1
  //if (*buffr == (NULL || CR || LF) ) return; // empty line: nothing to parse.

Changes in pull request.

Twilight-Logic, 2020-12-18:
Thank you for taking the time to submit this detailed list of proposed modifications.

> #if used or of not defines so if any of the USE_SERIAL weren't defined it activated the polling code. Since normally only one is defined the polling was always active.

I take your point here and this will be changed in the next release. While reviewing this point I also noticed that the code does not take into account the instance of the Mega where USE_SERIALEVENT1, USE_SERIALEVENT2 or USE_SERIALEVENT3 might be used. The update will take care of these possibilities.

> And this didn't terminate the loop when it found a command so if two commands were sent close enough together they would be concatenated and it would try to parse them as one command. I made it exit and process the command when found.

> while (arSerial->available() && lnRdy == 0) {

> This gets it to the state for me on an Uno board that I can send ++ commands without delays and they are correctly processed for the commands I tried.

> With these changes I can send another instrument command while the current is processing without delay but can't send more than that without it getting corrupted.

This is an interesting one and I understand what your modification is doing. The parser is one of the most difficult parts to process. It was written so that it wouldn't matter whether there was one command or multiple in the buffer - it should still split them up, but I have occasionally observed the problem you mention. On the other hand, if you add && lnRdy = 0, then there is a problem that while lnRdy > 1 (i.e. the previous command is still being processed) then the serial buffer is then blocking which leads to characters being lost and the corruption problems that you observed. The buffer is designed to read up to a CR and pass those characters to the command processor. It then reads up to the next CR and passes that command to the command processor and so on until all characters have been processed, then the buffer is cleared and we start over. I have spent hourse on this problem alone, however bearing in mind your suggestion, will spend some more time on it. I welcome any ideas that might improve this situation.

> This does complicate readBreak. I wasn't sure how that was supposed to work. Should read exit if anything is received, only if ++ is received, what about if a non ++ command is received before a ++?

Initially there were maybe 4 conditions where read was supposed to break. At present is should break when a '++' has been received indicating a controller command. The other condtion is in device mode where an ATN is received. At present the gpibReceiveData() routine handles both controller and device mode, but I am considering restructuring this routine as it has become rather messy.

> I also removed this line since it was unlikely to be doing anything useful. If it needs to check those three characters it needs to be three separate comparisons.
> Currently its checking for *buffr == 1 since (0 || 10 || 13) == 1
> //if (*buffr == (NULL || CR || LF) ) return; // empty line: nothing to parse.

The purpose of that if the buffer was empty, contained a CR or LF as the first character, then since a blank line was submitted the routine should immediately exit without further processing. As it is, the code is erroneous, so thank you for pointing it out. That will be amended in the next release to have 3 comparisons as you suggest:

  if (buffr[0] == NULL) return;
  if (buffr[0] == CR) return;
  if (buffr[0] == LF) return;

Thank you for pointing that out.

I need a little time to work on the gpibReceiveData() routine and once I have that done to my satisfaction I will release an update.

dgesswein, 2020-12-19:
> Thank you for taking the time to submit this detailed list of proposed modifications.

I have an open source project so submitted what I would like to get. I have
AR488 to a point where it seems pretty stable to me and I don't need to
sprinkle the code with sleeps to make it work so more improvements are nice
but not critical for me. I can look at implementing some of what I discussed
if its a direction you wish to go.

> This is an interesting one and I understand what your modification is doing. The parser is one of the most difficult parts to process. It was written so that it wouldn't matter whether there was one command or multiple in the buffer - it should still split them up, but I have occasionally observed the problem you mention. On the other hand, if you add && lnRdy = 0, then there is a problem that while lnRdy > 1 (i.e. the previous command is still being processed) then the serial buffer is then blocking which leads to characters being lost and the corruption problems that you observed. The buffer is designed to read up to a CR and pass those characters to the command processor. It then reads up to the next CR and passes that command to the command processor and so on until all characters have been processed, then the buffer is cleared and we start over. I have spent hourse on this problem alone, however bearing in mind your suggestion, will spend some more time on it. I welcome any ideas that might improve this situation.
>

I was assuming ++ commands execute quick enough that you can process one
before the serial starts loosing characters. With interrupt serial I think
you are ok since it should still read new characters. Will polled serial I
don't know. Most ++ commands should be processed fast enough but I think you
hade some that write to the non volatile memory that may take a while.
To make polled serial not loose character would need to add the polling to
any location that takes a long time. Having the character receive routine
do the parsing into commands makes handling multiple commands more difficult.
Have it just buffer the data and do the parsing when pulling the data from
the buffer may simplify the parsing but readBreak would need to do more
work to find ++ commands in the buffer.

>
> I need a little time to work on the gpibReceiveData() routine and once I have that done to my satisfaction I will release an update.
>

Twilight-Logic, 2020-12-22:
I have been aware for some time that serialEvent() is not attached to an actual hardware interrupt although I have researched this in detail only recently. The event is executed at the end of each cycle of void loop() and an examination of the Arduino code shows that it is equivalent to placing Serial.available() at the end of the loop. Given that some boards do not support serialEvent, the coding was a bit of a cludge and I have been wanting to remove any reference to it for some time and unify the code across all boards. I have been reliably informed that doing so would have no impact on performance as it is doing exactly the same thing.

I have placed an updated AR488.ino in the GitHub repository under /experimental for you to try. In this update, serialEvent has been removed altogether and replaced it with a serial handler that is placed at the end of void loop(). This makes the coding that was previously associated with USE_SERIALEVENT completely redundant.

I have also removed the USE_PINHOOKS define, as the presence of abscence of the USE_INTERRUPTS  define is sufficient to determine whether the state of the ATN and SRQ pins needs to be polled within void loop() or handled with interrupts.

Finally, I have removed the readBreak() function and the tranBrk variable completely. This had gotten a bit messy over time and it getting difficult to follow what was going on. You will see that this is being handled differently in the updated version.

For now, I have not made any changes to the parser buffer.

If you have time to try it, I would be interested to know how this update it performs. If it works OK then I will issue it as a formal update. If not, then hopefully the experiment will yield some useful information!

Theoretically there should be no performance difference. I have also included some of your modifications including the erroneous line in the parser. Thank you your contribution. This update worked fine in my test environment although I have not yet tested everything. Please let me know how you get on with it.

Regards.

dgesswein, 2020-12-23:
You have this warning.
/home/djg/gpib/AR488/src/AR488/AR488.ino:1076:19: warning: NULL used in arithmetic [-Wpointer-arith]
   if (buffr[0] == NULL) return;
                   ^
Should replace NULL with 0 since its not comparing to a pointer.

I did some testing with my DVM. It seems like back to back ++ commands work
fine. Back to back GPIB commands don't. My code ran fine as long as I sent
one command at a time.

Let me know if you and any specific tests I should do.

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

Twilight-Logic, 2020-12-23:
Thank for pointing out the warning. For some reason the 'Compiler Warnings' setting in my Arduino client preferences were set to 'None' so I didn't pick this up. I usually like to have it set to 'All' to make sure I pick up all the warnings. Not sure how/why this changed (update perhaps?) but I can confirm now that I got the same warning and appreciate your reporting this.

Could you elaborate a bit more on what happens when you send multiple GPIB commands? What is the sequence you are sending? What happens? Any errors or timeouts? Except for looking for a terminator, the interface makes no attempt to process non ++ commands and just sends the characters already in the buffer directly to the instrument whenever a terminator is detected. For some direct instrument commands it may also take some time for the instrument to respond. That may or may not be the issue here, so any further information you can give may be helpful.

In the meantime I have uploaded an update that deals with the error you mentioned.

dgesswein, 2020-12-23:
The issue was the test equipment turned on the error indicator saying it got a
bad command.  I should be able to look into it further to determine
what is really going wrong in the next couple days.

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

dgesswein, 2020-12-27:
If I send each of these strings as separate back to back writes

"++addr 22\n";
"++verbose\n";
"INBUF ON\n";
"END ALWAYS\n";
"TERM 2\n";

the output is
Verbose: ON
^
> INBUF ON
> END ALWAYSTERM 2

If I send
"++addr 22\n";
"++verbose\n";
"INBUF ON\n";
"END ALWAYS\n";
"++eoi\n";

I get
Verbose: ON

> INBUF ON
> END ALWAYS++eoi

Twilight-Logic, 2021-01-08:
Thank you for the update. I presume you are sending these using your own script?
I tested this with a simple copy and paste (after removing superfluous quotes and \n characters) and got a similar result with lines running into each other so the problem is confirmed. I will investigate.

dgesswein, 2021-01-08:
Yes, I'm using C code to talk to the serial port. Thats why the " and \n.

On Fri, Jan 08, 2021 at 06:51:09AM -0800, Twilight-Logic wrote:
> Thank you for the update. I presume you are sending these using your own script?
> I tested this with a simple copy and paste (after removing superfluous quotes and \n characters) and got a similar result with lines running into each other so the problem is confirmed. I will investigate.
>

Twilight-Logic, 2021-01-10:
I think I have solved that problem with the commands running into each other. There was a bug with the way that the new serial handling routine was implemented. I have uploaded an updated AR488.ino into the experimental directory for you to try.

dgesswein, 2021-01-10:
Looks good to me. I was able to send 5 commands back to back without
problem. I assume the USB serial doesn't have flow control so sending more
than that I am just overrunning the buffer.

I have deleted my fork since your code is now working better for me.

Thanks

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

Twilight-Logic, 2021-01-10:
Thank you for confirming the update works. You are correct that on Arduinos there is no flow control on the serial port. I believe thst some aspects of hardware flow control may be supported on genuine Arduinos but definitely not on the cheap clones with CH340 chips. The built-in Arduino serial buffer is 64 bytes in size and as you will already be aware, due in large part to memory limitations, the parsing buffer in the AR488 code is 128 bytes. MCU processing is significantly faster than serial transfer speeds so the Arduino can keep up quite well, but it should be bourne in mind that if data comes in faster than the Arduino can handle, then the buffer may overflow which will result in the loss of at least some data. It might be possible at some point to implement a software flow control mechanism e.g. xon/xoff, but i haven't experimented with that yet.

Twilight-Logic, 2021-01-12:
Fixed in version 0.49.12.
Implementing a cyclical buffer is being considered for a future release.

Closed 2021-01-12.

Thread 14 (2021-02-27):

Interface responds to a SCPI *idn only if it´s lowercase

g-user, 2021-02-27:
I have an old device that doesn´t responds to *idn.  So I set the interface to respond to that.

But the program sends the *IDN - command in uppercase, so the interface doesn´t react to this command.

My Solution:
change the line (837)
if (strncmp(buffr, "*idn?", 5)==0) {

to

if (strncasecmp(buffr, "*idn?", 5)==0) {

Twilight-Logic, 2021-03-02:
Thank you for your report. The change will be implemented in the next release.

SheetLightning, 2021-04-01:
Correction applied in version 0.49.14.

Closed 2021-06-08.

Thread 15 (2021-05-02):

Normalize the git repository

douardda, 2021-05-02:
Hi,
this project looks very interesting, and I'd like to help for an ESP32 version of the code.
However a few things look a bit strange with the way the git repo is managed:

- why not use tags for published version?
- why add the zip file of the "last" version (can be omitted is properly tagged), as well as
- why keep old version as a bunch of binary (zip) files instead of using what git is made for (using tags)?
- it would be also nice the add the sources of the documentation instead of the pdf files directly (using a [markdown](https://www.markdownguide.org/), [ReST](https://docutils.sourceforge.io/rst.html) or even a tool like [sphinx](https://www.sphinx-doc.org/) to manage the documentation).
- ideally, binary files (docs and firmwares) should be automatically built (eg. using [travis-ci)](https://travis-ci.org/)
- it would be nice to have the work in progress for other platforms (eg. esp32) available as branches.

Would you consider these improvements? Would you like some help for this?

Thank you
David

Twilight-Logic, 2021-06-03:
David, thank you for your kind offer of help. I would certainly consider such improvements and your offer of assistance is greatly appreciated. You have already mentioned a couple of tools which I will explore so thank you for this.

douardda, 2021-10-16:
Hi,

I've started doing some cleaning stuff in https://github.com/douardda/AR488/tree/normalize
I've removed all the zip files (as well as the Contributed directory which IMHO should be merged with the main code; which I ma try to do later on).

For the doc, it would be handy to get access to the source fie of the PDF you publish, so that I can try to convert it as a sphinx project.

Also note that in my fork, I have created tags for versions I could identify in the git log.

douardda, 2021-10-16:
I've started a sphinx-based doc (copy pasting from the PDF). You can have an idea of the result here: https://sdfa3.org/david/ar488/

It's a straight sphinx config (default theme, nothing tuned or adapted).

Note that sphinx can also generated PDF files out of the box

douardda, 2021-10-17:
Got the main documentation converted to sphinx in [this branch](https://github.com/douardda/AR488/tree/normalize) (in the docs/  directory); the HTML result is visible on the [same URL](https://sdfa3.org/david/ar488/).

It needs some work to make it look a bit better, but it's a nice starting point IMHO.

Meanwhile, I have also played a bit with github actions to build the firmware automatically.

  https://github.com/douardda/AR488/actions

For example, generated firmware files for my latest git revision are listed on:

  https://github.com/douardda/AR488/actions/runs/1351644598

For this I am using [platformio](https://platformio.org) to compile the firmware for different boards (this works in a branch of mine in which I am porting the code to work on a STM32, here a Nucleo F303K8 I had laying around, but that's another story I'll talk about later :-) )

Thread 16 (2021-06-05):

Error compiling

Hoverhead, 2021-06-05:
This is "straight out of the box" no mods /***** FWVER "AR488 GPIB controller, ver. 0.49.14, 02/03/2021" *****/
I have a Sainsmart UNO and a duinotech screw sheild.  The IDE is 2:1.0.5+dfsg2-4.1 under Kubuntu.
Below is the error out put after a verify compile.
I have no idea where I should start  to sort this.
Help please.

In file included from AR488.ino:13:0:
AR488_Eeprom.h: In function ‘void epViewData(T*)’:
AR488_Eeprom.h:32:12: error: ‘class EEPROMClass’ has no member named ‘get’
     EEPROM.get(addr, dbuf);
            ^
AR488.ino: In function ‘void setup()’:
AR488.ino:564:13: error: ‘flushPbuf’ was not declared in this scope
AR488.ino:603:13: error: ‘initAR488’ was not declared in this scope
AR488.ino:647:36: error: ‘initDevice’ was not declared in this scope
AR488.ino:650:40: error: ‘initController’ was not declared in this scope
AR488.ino: In function ‘void loop()’:
AR488.ino:707:24: error: ‘execCmd’ was not declared in this scope
AR488.ino:714:35: error: ‘sendToInstrument’ was not declared in this scope
AR488.ino:718:25: error: ‘gpibReceiveData’ was not declared in this scope
AR488.ino:723:25: error: ‘gpibReceiveData’ was not declared in this scope
AR488.ino:730:19: error: ‘spoll_h’ was not declared in this scope
AR488.ino:735:52: error: ‘gpibReceiveData’ was not declared in this scope
AR488.ino:741:51: error: ‘sendToInstrument’ was not declared in this scope
AR488.ino:743:15: error: ‘lonMode’ was not declared in this scope
AR488.ino:745:31: error: ‘attnRequired’ was not declared in this scope
AR488.ino:746:51: error: ‘sendToInstrument’ was not declared in this scope
AR488.ino:761:22: error: ‘serialIn_h’ was not declared in this scope
AR488.ino: In function ‘void initDevice()’:
AR488.ino:778:23: error: ‘setGpibControls’ was not declared in this scope
AR488.ino: In function ‘void initController()’:
AR488.ino:788:23: error: ‘setGpibControls’ was not declared in this scope
AR488.ino:792:9: error: ‘ifc_h’ was not declared in this scope
AR488.ino: In function ‘uint8_t serialIn_h()’:
AR488.ino:810:47: error: ‘parseInput’ was not declared in this scope
AR488.ino: In function ‘uint8_t parseInput(char)’:
AR488.ino:867:20: error: ‘addPbuf’ was not declared in this scope
AR488.ino:873:23: error: ‘flushPbuf’ was not declared in this scope
AR488.ino:874:36: error: ‘showPrompt’ was not declared in this scope
AR488.ino:882:38: error: ‘isCmd’ was not declared in this scope
AR488.ino:886:27: error: ‘flushPbuf’ was not declared in this scope
AR488.ino:892:64: error: ‘isIdnQuery’ was not declared in this scope
AR488.ino:894:25: error: ‘flushPbuf’ was not declared in this scope
AR488.ino:911:20: error: ‘addPbuf’ was not declared in this scope
AR488.ino:923:18: error: ‘addPbuf’ was not declared in this scope
AR488.ino:935:19: error: ‘isCmd’ was not declared in this scope
AR488.ino:939:17: error: ‘flushPbuf’ was not declared in this scope
AR488.ino: At global scope:
AR488.ino:1020:23: error: ‘addr_h’ was not declared in this scope
AR488.ino:1021:40: error: ‘aspoll_h’ was not declared in this scope
AR488.ino:1022:23: error: ‘amode_h’ was not declared in this scope
AR488.ino:1023:40: error: ‘clr_h’ was not declared in this scope
AR488.ino:1024:40: error: ‘dcl_h’ was not declared in this scope
AR488.ino:1025:40: error: ‘default_h’ was not declared in this scope
AR488.ino:1026:23: error: ‘eoi_h’ was not declared in this scope
AR488.ino:1027:23: error: ‘eor_h’ was not declared in this scope
AR488.ino:1028:23: error: ‘eos_h’ was not declared in this scope
AR488.ino:1029:23: error: ‘eot_char_h’ was not declared in this scope
AR488.ino:1030:23: error: ‘eot_en_h’ was not declared in this scope
AR488.ino:1031:40: error: ‘ifc_h’ was not declared in this scope
AR488.ino:1032:23: error: ‘id_h’ was not declared in this scope
AR488.ino:1033:23: error: ‘idn_h’ was not declared in this scope
AR488.ino:1034:23: error: ‘llo_h’ was not declared in this scope
AR488.ino:1035:23: error: ‘loc_h’ was not declared in this scope
AR488.ino:1036:23: error: ‘lon_h’ was not declared in this scope
AR488.ino:1037:23: error: ‘macro_h’ was not declared in this scope
AR488.ino:1038:23: error: ‘cmode_h’ was not declared in this scope
AR488.ino:1039:40: error: ‘ppoll_h’ was not declared in this scope
AR488.ino:1040:23: error: ‘read_h’ was not declared in this scope
AR488.ino:1041:23: error: ‘rtmo_h’ was not declared in this scope
AR488.ino:1042:23: error: ‘ren_h’ was not declared in this scope
AR488.ino:1043:23: error: ‘repeat_h’ was not declared in this scope
AR488.ino:1044:40: error: ‘rst_h’ was not declared in this scope
AR488.ino:1045:23: error: ‘trg_h’ was not declared in this scope
AR488.ino:1046:40: error: ‘save_h’ was not declared in this scope
AR488.ino:1047:23: error: ‘setvstr_h’ was not declared in this scope
AR488.ino:1048:23: error: ‘spoll_h’ was not declared in this scope
AR488.ino:1049:40: error: ‘srq_h’ was not declared in this scope
AR488.ino:1050:23: error: ‘srqa_h’ was not declared in this scope
AR488.ino:1051:23: error: ‘stat_h’ was not declared in this scope
AR488.ino:1052:23: error: ‘ton_h’ was not declared in this scope
AR488.ino:1053:23: error: ‘ver_h’ was not declared in this scope
AR488.ino:1054:40: error: ‘verb_h’ was not declared in this scope
AR488.ino:1055:23: error: ‘tmbus_h’ was not declared in this scope
AR488.ino:1056:23: error: ‘xdiag_h’ was not declared in this scope
AR488.ino: In function ‘void sendToInstrument(char*, uint8_t)’:
AR488.ino:1083:28: error: ‘gpibSendData’ was not declared in this scope
AR488.ino: In function ‘void execCmd(char*, uint8_t)’:
AR488.ino:1128:14: error: ‘getCmd’ was not declared in this scope
AR488.ino: In function ‘void read_h(char*)’:
AR488.ino:1502:21: error: ‘gpibReceiveData’ was not declared in this scope
AR488.ino: In function ‘void clr_h()’:
AR488.ino:1509:29: error: ‘addrDev’ was not declared in this scope
AR488.ino:1513:25: error: ‘gpibSendCmd’ was not declared in this scope
AR488.ino:1517:16: error: ‘uaddrDev’ was not declared in this scope
AR488.ino:1522:23: error: ‘setGpibControls’ was not declared in this scope
AR488.ino: In function ‘void llo_h(char*)’:
AR488.ino:1533:31: error: ‘gpibSendCmd’ was not declared in this scope
AR488.ino:1539:33: error: ‘addrDev’ was not declared in this scope
AR488.ino:1544:29: error: ‘gpibSendCmd’ was not declared in this scope
AR488.ino:1549:20: error: ‘uaddrDev’ was not declared in this scope
AR488.ino:1556:23: error: ‘setGpibControls’ was not declared in this scope
AR488.ino: In function ‘void loc_h(char*)’:
AR488.ino:1577:33: error: ‘addrDev’ was not declared in this scope
AR488.ino:1582:29: error: ‘gpibSendCmd’ was not declared in this scope
AR488.ino:1587:20: error: ‘uaddrDev’ was not declared in this scope
AR488.ino:1592:27: error: ‘setGpibControls’ was not declared in this scope
AR488.ino: In function ‘void trg_h(char*)’:
AR488.ino:1650:30: error: ‘addrDev’ was not declared in this scope
AR488.ino:1655:29: error: ‘gpibSendCmd’ was not declared in this scope
AR488.ino:1660:20: error: ‘uaddrDev’ was not declared in this scope
AR488.ino:1667:25: error: ‘setGpibControls’ was not declared in this scope
AR488.ino: In function ‘void spoll_h(char*)’:
AR488.ino:1750:26: error: ‘gpibSendCmd’ was not declared in this scope
AR488.ino:1758:40: error: ‘gpibSendCmd’ was not declared in this scope
AR488.ino:1766:26: error: ‘gpibSendCmd’ was not declared in this scope
AR488.ino:1787:36: error: ‘gpibSendCmd’ was not declared in this scope
AR488.ino:1796:27: error: ‘setGpibControls’ was not declared in this scope
AR488.ino:1799:41: error: ‘gpibReadByte’ was not declared in this scope
AR488.ino:1829:26: error: ‘gpibSendCmd’ was not declared in this scope
AR488.ino:1837:26: error: ‘gpibSendCmd’ was not declared in this scope
AR488.ino:1845:26: error: ‘gpibSendCmd’ was not declared in this scope
AR488.ino:1853:23: error: ‘setGpibControls’ was not declared in this scope
AR488.ino: In function ‘void stat_h(char*)’:
AR488.ino:1884:17: error: ‘setSrqSig’ was not declared in this scope
AR488.ino:1887:17: error: ‘clrSrqSig’ was not declared in this scope
AR488.ino: In function ‘void dcl_h()’:
AR488.ino:1963:26: error: ‘gpibSendCmd’ was not declared in this scope
AR488.ino:1968:23: error: ‘setGpibControls’ was not declared in this scope
AR488.ino: In function ‘void ppoll_h()’:
AR488.ino:2004:23: error: ‘setGpibControls’ was not declared in this scope
AR488.ino: In function ‘void setvstr_h(char*)’:
AR488.ino:2073:16: error: ‘id_h’ was not declared in this scope
AR488.ino: In function ‘void repeat_h(char*)’:
AR488.ino:2159:42: error: ‘gpibSendData’ was not declared in this scope
AR488.ino:2161:25: error: ‘gpibReceiveData’ was not declared in this scope
AR488.ino: In function ‘void xdiag_h(char*)’:
AR488.ino:2241:29: error: ‘setGpibControls’ was not declared in this scope
AR488.ino:2243:29: error: ‘setGpibControls’ was not declared in this scope
AR488.ino: In function ‘void attnRequired()’:
AR488.ino:2394:23: error: ‘setGpibControls’ was not declared in this scope
AR488.ino:2403:42: error: ‘gpibReadByte’ was not declared in this scope
AR488.ino:2434:29: error: ‘unl_h’ was not declared in this scope
AR488.ino:2437:29: error: ‘unt_h’ was not declared in this scope
AR488.ino:2452:11: error: ‘mla_h’ was not declared in this scope
AR488.ino:2463:13: error: ‘spe_h’ was not declared in this scope
AR488.ino:2467:13: error: ‘mta_h’ was not declared in this scope
AR488.ino:2477:11: error: ‘spd_h’ was not declared in this scope
AR488.ino: In function ‘void mla_h()’:
AR488.ino:2495:19: error: ‘gpibReceiveData’ was not declared in this scope
AR488.ino: In function ‘void spe_h()’:
AR488.ino:2526:18: error: ‘gpibSendStatus’ was not declared in this scope
AR488.ino: In function ‘void lonMode()’:
AR488.ino:2558:19: error: ‘gpibReceiveData’ was not declared in this scope
AR488.ino: In function ‘bool gpibSendCmd(uint8_t)’:
AR488.ino:2576:23: error: ‘setGpibControls’ was not declared in this scope
AR488.ino:2579:31: error: ‘gpibWriteByte’ was not declared in this scope
AR488.ino: In function ‘void gpibSendStatus()’:
AR488.ino:2601:23: error: ‘setGpibControls’ was not declared in this scope
AR488.ino:2602:27: error: ‘gpibWriteByte’ was not declared in this scope
AR488.ino: In function ‘void gpibSendData(char*, uint8_t)’:
AR488.ino:2620:33: error: ‘addrDev’ was not declared in this scope
AR488.ino:2637:25: error: ‘setGpibControls’ was not declared in this scope
AR488.ino:2640:25: error: ‘setGpibControls’ was not declared in this scope
AR488.ino:2652:34: error: ‘gpibWriteByte’ was not declared in this scope
AR488.ino:2655:94: error: ‘gpibWriteByte’ was not declared in this scope
AR488.ino:2671:23: error: ‘gpibWriteByte’ was not declared in this scope
AR488.ino:2678:23: error: ‘gpibWriteByte’ was not declared in this scope
AR488.ino:2701:22: error: ‘uaddrDev’ was not declared in this scope
AR488.ino:2712:25: error: ‘setGpibControls’ was not declared in this scope
AR488.ino:2716:25: error: ‘setGpibControls’ was not declared in this scope
AR488.ino: In function ‘bool gpibReceiveData()’:
AR488.ino:2751:31: error: ‘addrDev’ was not declared in this scope
AR488.ino:2759:45: error: ‘Wait_on_pin_state’ was not declared in this scope
AR488.ino:2761:25: error: ‘setGpibControls’ was not declared in this scope
AR488.ino:2766:25: error: ‘setGpibControls’ was not declared in this scope
AR488.ino:2794:45: error: ‘gpibReadByte’ was not declared in this scope
AR488.ino:2827:42: error: ‘isTerminatorDetected’ was not declared in this scope
AR488.ino:2873:18: error: ‘uaddrDev’ was not declared in this scope
AR488.ino:2878:25: error: ‘setGpibControls’ was not declared in this scope
AR488.ino:2882:25: error: ‘setGpibControls’ was not declared in this scope
AR488.ino: In function ‘uint8_t gpibReadByte(uint8_t*, bool*)’:
AR488.ino:2963:45: error: ‘Wait_on_pin_state’ was not declared in this scope
AR488.ino:2983:46: error: ‘Wait_on_pin_state’ was not declared in this scope
AR488.ino: In function ‘bool gpibWriteByte(uint8_t)’:
AR488.ino:3007:34: error: ‘gpibWriteByteHandshake’ was not declared in this scope
AR488.ino: In function ‘bool gpibWriteByteHandshake(uint8_t)’:
AR488.ino:3027:46: error: ‘Wait_on_pin_state’ was not declared in this scope
AR488.ino:3032:47: error: ‘Wait_on_pin_state’ was not declared in this scope
AR488.ino:3044:46: error: ‘Wait_on_pin_state’ was not declared in this scope
AR488.ino:3050:47: error: ‘Wait_on_pin_state’ was not declared in this scope

Twilight-Logic, 2021-06-07:
That looks like a corrupt file (a { or } missing somewhere. I would deleting the unpacked files, uncompressing the ZIP again and compiling the freshly unpacked files. In the meantime will check it out as well when I get a chance. I do development on a Mega 2560 and Uno and then compile binaries for the other platforms so it should definitely work on a Uno, although have never tried on a Sainsmart one. Are you using the generic Arduino Uno board or have you downloaded additional boards?

Hoverhead, 2021-06-15:
Hi, I deleted the files on the puter, did a re-clone and the rest.  Still getting the same error result when I verify. Well the ^ is under the "g" in get this time instead of "E" in EEPROM.   There is no difference if the Arduino is plugged in or not.  This is the result of verify straight after loading AR488,ino into the IDE.  Should I be making other changes to the  AR488_Eeprom.h file first?  I don't know what I would need to change in this instance.
Could it be just a syntax issue on that line?
In file included from AR488.ino:13:0:
AR488_Eeprom.h: In function ‘void epViewData(T*)’:
AR488_Eeprom.h:32:12: error: ‘class EEPROMClass’ has no member named ‘get’
     EEPROM.get(addr, dbuf);
                      ^

Twilight-Logic, 2021-06-19:
The compile process is independent of the hardware so having the Arduino plugged in vs unplugged should make no difference.

Which version of the Arduino IDE are you using?
Which board have you selected in the Boards Manager?

Try uncommenting this line in AR488_Config_h:

`//#define AR488_CUSTOM`

Does the same thing happen?

There is also no harm in commenting out the whole template definition in AR488_EEPROM.h as it is a diagnostic feature and not actually used:

```
/*
template<typename T> void epViewData(T* output) {
  uint16_t addr = 0;
  uint8_t dbuf[16];
  char cnt[4]= {'\0'};
  char oct[4] = {'\0'};

  // Read data
  memset(dbuf, 0x00, 16);
  for (addr=0; addr<512; addr=addr+16){
    sprintf(cnt, "%03d", addr);
    output->print(cnt);
    output->print(":");
    EEPROM.get(addr, dbuf);
    for (int i=0; i<16; i++){
      output->print(" ");
      sprintf(oct, "%02X", dbuf[i]);
      output->print(oct);
    }
    output->println();
  }
}
*/
```
I do suspect that the compile will fail elsewhere though instead.

Hoverhead, 2021-06-25:
Hi,
I did this a week ago now and sent the result by email. I see it hasn't linked to this thread.
Needles to say those changed didn't work.  I'm now trying with my laptop to see it that makes a difference.

Twilight-Logic, 2021-06-25:
I set up a virtual machine and installed the Arduino IDE from the repository which installed version 2:1.0.5+dfsg2-4.1. A compile test confirmed the following compile errors:

```
In file included from AR488_Eeprom.cpp:3:0:
AR488_Eeprom.h: In function ‘void epViewData(T*)’:
AR488_Eeprom.h:32:12: error: ‘class EEPROMClass’ has no member named ‘get’
     EEPROM.get(addr, dbuf);
            ^
AR488_Eeprom.cpp: In function ‘void epWriteData(uint8_t*, uint16_t)’:
AR488_Eeprom.cpp:70:12: error: ‘class EEPROMClass’ has no member named ‘update’
     EEPROM.update(addr+i,cfgdata[i]);
            ^
AR488_Eeprom.cpp:74:10: error: ‘class EEPROMClass’ has no member named ‘put’
   EEPROM.put(0, crc);
          ^
AR488_Eeprom.cpp: In function ‘bool epReadData(uint8_t*, uint16_t)’:
AR488_Eeprom.cpp:92:10: error: ‘class EEPROMClass’ has no member named ‘get’
   EEPROM.get(0,crc1);
          ^
AR488_Eeprom.cpp: In function ‘bool isEepromClear()’:
AR488_Eeprom.cpp:112:10: error: ‘class EEPROMClass’ has no member named ‘get’
   EEPROM.get(0, crc);
```

Further investigation shows that the EEPROM .get and .put methods were not actually supported in that older version. Commenting out the relevant EEPROM section leads to further compile errors as shown above. I can therefore confirm that the problem exists when compiling using this early 1.0.5 version of the IDE and would therefore advise not using it to compile the sketch. It should be removed and purged to remove any old library files that might have been left behind:

sudo apt remove arduino
sudo apt purge arduino

The latest version of the IDE should then be downloaded from arduino.cc and used instead.

Hoverhead, 2021-06-25:
Unfortunately I had tried it on the lap top as I typed the last response.  Your latest reply has me working on the desktop on the Arduino.cc Download.  It has not gone well.  I had done the remove and purge  (and reboot) before I read your latest.  I had a "not booted in systemd" error amongst others.  Happy to know that it was the IDE version that was the issue, I only now have to get the latest IDE to play nice on my puter.

Hoverhead, 2021-06-25:
Success!  Had "System has not been booted with systemd as init system (PID 1). Can't operate.
Failed to connect to bus: Host is down" after running "./arduino-linux-setup.sh  $USER" but ran "install.sh" anyway and have the IDE running and a successful verify.  Thanks for the directions.  Looking forward to getting my old HP 7470A pen plotter going again.

Hoverhead, 2021-06-26:
Now that I appear to have this running, I'm don't know how to get it to function as the interface to my plotter.   Is the information there and I haven't seen it yet?  Or am I on a search and rescue mission?

Twilight-Logic, 2022-02-02:
The compiling issue is now resolved so closing the issue.

Sending a file to a plotter should be possible with the Sainsmart board since it doesn't use the cheaper CH340 UART that the clones do which do not provide proper hardware handshaking. It ought to be a matter of just addressing the plotter in controller mode and sending data to it. The UART controls the data transfer from the PC, and GPIB handshaking should be sufficient for the plotter to request and pause data transfer from the interface. I will need to check how the plotter handles the data transfer.

Working with a plotter is not likely to be possible when working with a clone board.

Closed 2022-02-02.

Thread 21 (2021-11-01):

device mode consult

michaelshow, 2021-11-01:
I test the device mode function of AR488:
Scenario 1: I connect AR488 and NI-ENET to the GPIB bus at the same time, AR488 as the device, and NI-ENET as the control terminal. NI-ENET lists AR488 in MAX, and AR488 and NI-ENET can read and write data with each other.
Scenario 2: NI-USB-HS as the control terminal and NI-ENET as the device. They can also read and write each other;
Scenario 3: NI-USB-HS is used as the control terminal, and AR488 is used as the device. NI-USB-HS can't find AR488 in MAX. Sending "ibwrt" after connecting directly with "ibdev" command will report an error: "EBUS".
In scenario 3, what do I need to do to make the normal communication between NI-USB-HS and AR488?

michaelshow, 2021-11-01:
I use the hardware made by arduino uno（Appendix A – Connection and technical information for Uno and Nano boards）。
Is it related to the lack of SN7516x GPIB transceiver integrated circuits?

Twilight-Logic, 2021-11-01:
That is curious and I am uncertain why your NI-USB-HS cannot see the Arduino. I imagine that you have tried resetting the Arduino? The difficulty with using an Arduino without buffering (e.g. SN7516x chipset) becomes apparent when you have two or more of them on the same bus. I would not expect it to be an issue with a single Arduino talking to NI devices.

What I suggest is to enable DEBUG5. That will show in a serial terminal the addressing and GPIB commands being passed to the AR488 from the NI-USB-HS.

Adding DEBUG3 and DEBUG7 will show further detail.

If you can send me the output at the terminal from the AR488 with DEBUG 5 enabled and then with all three enabled that may be helpful in deducing what the problem may be. GPIB control signals can occasionally get left in an unexpected state but a reset should usually be sufficient to clear that.

Twilight-Logic, 2021-11-03:
Thank you for your hard work on this. I really need to get to grips with something like Sphinx. The documentation looks great. I have also not noticed GitHub actions before. Had a quick look at it looks like there is lots to learn. Again must have a look at this.

I had intended to look at porting to the STM32 so your work on that is most welcome.

michaelshow, 2021-11-25:
Hello, I’m sorry that I didn’t reply in time because I was busy with other things in the middle.
I tried enable debug3, debug5, and debug7. The following scenes are recorded:
1. As a controller, AR488 can communicate with other devices normally;
2. AR488 is used as a device and NI-ENET is used as a controller: NI-ENET cannot recognize AR488;
3. On the basis of scenario 2, add another device (34401A addr 22) to the GPIB bus. NI-ENET can recognize AR488 and communicate, but it will also detect other devices by mistake. NI-ENET will recognize dozens of non-existent devices, you can refer to the attached pictures;
4. On the basis of scenario 3, connect NI-USB-HS as a controller and NI-ENET as a device. NI-USB-HS cannot recognize any devices.

The debug log is recorded by the serial communication tool, and you can refer to the attachment.
Looking forward to your answer, thank you！

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
[log_20211124.txt](https://github.com/Twilight-Logic/AR488/files/7600090/log_20211124.txt)
[log_20211125.txt](https://github.com/Twilight-Logic/AR488/files/7600091/log_20211125.txt)

Twilight-Logic, 2022-02-02:
Thank you for the detailed summary.
I am curious whether you still have the problem with the latest release - 0.51.03?
There have been some significant changes to the code.

Twilight-Logic, 2022-10-12:
Closing due to no further comments. Version 0.51.15 is now available to try if required.

Closed 2022-10-12.

Thread 22 (2021-11-24):

Need help with KE5FX plotter emulator and Tek TDS540 Hardcopy

dl6lr, 2021-11-24:
First I want to thank you for your efforts. I have built some AR488 with 32U pro micro boards (Artags design) and contributed the 3d printed case for it in EEVBlog. I used the version 0.49.12 from your site but as I ran into some issues, I compiled the latest with no change (besides having ++help).
I can use basic communication with my instruments using a terminal software. Simple commands and queries like "++addr 29", "++auto 1" and "*IDN?" are working fine.

First I found out that the prologix configurator from John Miles sites checks the version string of the adapter. It scans for "ersion %d.%d" into major and minor and uses major*1000+minor (and an optional character at byte position 11). It seems to distinguish three versions: 3.12C, 4.40 and 6.102 to fine tune settings. So I changed the reported version with ++id verstr AR488 version 6.102 to the highest version. This solved the issue that the configurator was not able to use the AR488. Sending and receiving is working in the terminal window and settings control and device mode as well as autoread checkboxes and/or the manual read. Lower versions where tested but I found no obvious differences.

The 7470 plotter emulater is not working, neither in "request plot from supported device at address 29" (Tek in full control @29), which will "hang" at received bytes 0, nor with "wait for device initiated plot" in listen-only (Tek in talk-only), which will receive 0 bytes as well. Both functions work well using a Agilent 82357B  with Agilent IOlibrary.
The tdsdump.bat example from the KE5FX packages is not working either with the AR488.

Using the terminal, I can send the corresponding commands to the device and perform a "++read" after "HARDCOPY START" command. It reads the HPGL data from the device.
Using 7470.exe with "request plot from supported device at address 29" and stopping the program, I can read the hardcopy with the terminal program just performing a "++read" after switching to "++mode 1", the KE5FX library seems to swich to listen. I can crash the 7470 program by performing two "request plot from supported device at address 29", the second being aborted with a message that the identification is invalid and stating parts of the HPGL plot, presumingly from the first initated hardcopy that was aborted by keypress.

Any help how to proceed in systematic testing is appreciated.

Experimenting further, I was not able to use the listen-only in success with the Tek. Sending "++lon 1", it keeps reading "1 bytes" in a loop with timeout. Initiating a hardcopy from the Tek does not produce any data. Furthermore I was not able to stop the polling loop with any ++ command, how is this expected to work?

As this is not a real problem report, any other method of communication (email, chat) is of course accepted to not fill the tracker with bloat. I can produce logs and dumps if needed. Haven't recompiled the KE5FX software yet as my VS2019 compiler spit out some errors.

dl6lr, 2021-11-24:
Addendum: I was able to retrieve some device initiated plots. They have some issues in the data shown as glitches. More complex screens are interrupted in the middle, I assume this is some kind of timeout (I see KE5FXs library limits the read_tmo_ms to max 3000), as the remaining data is stored to a second plot. Currently I think this is a problem in the way the KE5FX program uses the AR488 as a Prologix clone. Have to dig deeper...

Twilight-Logic, 2021-11-25:
Thank you for your report.

As you have observed, the ++id verstr command was introduced just for this purpose, to allow the version string to be set to whatever specific software is expecting. Generally setting it to version 6 should be sufficient.

I am uncertain about what the problem is with ++lon but this is now the second report of a problem although the previous report was specific to version 0.49.14. My understanding from that report is that version 0.49.12 works OK. Nevertheless, I do intend to have a closer look at the problem. I have just acquired a GPIB board for a my Tek 468 storage oscilloscope and am in the process of installing it. I need to improvise a missing switch but once I have it set up and have it working I will have an instrument I can a real world test instrument dumps with which will put me in a better position to have a closer look at the problem.

The problem could be down to timeout but could be some other factor such as serial handshaking (or rather the lack of it on cloned boards with the CH340 chip) but I am also interested in your further findings. I was going to suggest turning DEBUG7 on, but  the results would have to be observed in a terminal, so that will not be practical.

dl6lr, 2021-11-25:
Something more: I found that a lot of programs rely on the adapter being in a specific state. That might not be the case as programs may leave the adapter in an unknown state. I.e. the TDS Screen dump utility [from ](https://github.com/Niravk1997/Tektronix_TDS_HardCopy_AR488) relies on default settings of the AR488. This may not be the case if the adapter was used by a different program before. Especially if the 7470 works as a plotter emulator, it may leave the adapter in device mode. This made my testing more complicate as I was facing intermittant failures...

Twilight-Logic, 2021-11-27:
Thank for reporting that back. If the adapter is left in an unknown state by a previous program then that certainly would make things difficult for the next program. Especially if In a situation where the adapter is left in an auto read mode, it should be possible to turn off the mode, but it does take time for the interface to respond while it is locked in a reading loop. It is probably quicker to just reset.

I saw your post on the thread and I am glad you got to a working configuration form now.

Unfortunately, the donor GPIB board for my Tek 468 is faulty so its going to be a while before I can do any real-world testing. It shuts the computer down when connected do I need to debug it. The switch and LEDs are wired in place, but alas,  still no GPIB!

I am going to try and find some time in December/January to get the new code thoroughly tested and released.

dl6lr, 2021-12-06:
Some more findings: The KE5FX library uses the ++read_tmo_ms command to set the read timeout. The value is restricted to a maximum of 3000ms and defaults to 500ms, it can be configured in the configuration file 7470.ini.
But the command is only performed, if auto-read is **not** enabled. As the library enables auto-read by default upon connection establishment, this command is effectively never used to set the read timeout in controller mode. This is the reason that the controller requested hardcopy does not work: It emits the HARDCOPY START command to the TDS, then waits a maximum of 1200ms (default read_tmo_ms) which is not long enough for the older Teks with slow processor boards. By setting ++read_tmo_ms to 8000 I was able to successfully request a hardcopy from the TDS540 (without glitches!).
So I think the appropriate solution would be:

1. Enable setting of ++read_tmo_ms even in auto-read-mode
2. Introducing connect/disconnect command sequences to be sent to to the adapter after connect and prior to disconnect to force the adapter to a known state.

As I do not have a Prologix adapter, I can not verify behaviour to be consistent with it. I may contact John to discuss with him or ask for his permission to create a derivative on Github

Twilight-Logic, 2022-01-02:
I finally got GPIB working on the Tek 468. I was able to get output at the terminal with default settings, just by setting the address to 17 (as set on the dip switches) and issuing a ++read. This yielded the scope id, firmware version and some channel and drawing data. However, it does not appear to be HPGL so would perhaps have not helped much with this particular problem. I now need to decode the format.

Have you tried NX-1997s TDS with  ++eor 7, ++eoi 1, ++read_tmo_ms 8000, ++addr GPIB_Address, and everything else at default as discussed in the thread? It didn't work with my 468 because the format is different but might work with your TDS540.

Looking at your previous comment it seems that you have successfully resolved the problem anyway, so unless there is any further comment within the next week or so, I will close the issue. Sorry I could not be of much help in this case.

dl6lr, 2022-01-03:
Thanks for your response. The NX-1997s TDS dump utility does work for me. It is using BMP dump file whereas the KE5FX tool uses HPGL. Wether the file formats are supported depends on the instrument used, my TDS540 supports both formats. I am still struggeling with some minor details but I did not have enough time to trace them down. I would like to share my results here but if you close this issue, I may gladly report in a new one. I haven't contacted John yet as I still feel I am not understanding everything in his library/tools. Maybe I will buy a Prologix to make sure the behaviour is similar or different.

Final goal is to have a raspberry pi as a plotter server and instrument control for some connected devices, so I can press the hardcopy button on the front of the instrument to have a plot saved that could be retrieved through the network or use the network to request a device plot, haven't made up my mind yet which solution is more comfortable.

Twilight-Logic, 2022-01-03:
I will leave the issue open for now so that you can report back without opening another one.

Interesting idea with the Pi. Nx-1997 pointed me to a Python program to capture plots from my 468. Possibly it could be modified to do something similar and pull plots in waveform data format from the TDS series. I intend to have a look at it and maybe update it for Python3 at some point.

dl6lr, 2022-02-19:
Currently I have no time to investigate further, so I close the issue. I was able to change the KE5FX-software to retrieve plots from my TDS-540 and capture device initiated plots, but this is not very stable. Currently using the Agilent 82357B for the TDS.

Twilight-Logic, 2022-02-20:
Thank you. I did write a Python program to retrieve plots from my 468 and this works OK in both Controller and talk only modes. However, the amount of data sent (between approx 700 bytes and 1.3kb depending on whether one or two traces are being displayed) is smaller than on the TDS series (approx 3kb AFAIK) so this may not be a fair test. Based on my recent work with the 768 and a Tek 4051 computer, there have been a number of tweaks to the code but unfortunately, I don't have access to a TDS series scope to test with. At least you have your Agilent 82357B to fall back on.

Closed 2022-02-19.

Thread 25 (2022-02-12):

Compile error, Mega 2560 + Arduino IDE 1.8.16

FannyLoi, 2022-02-12:
Hello,
     When attempting a first-time compile with MEGA 2560 board selected, I receive this error.  I looked through the documentation and prior issues, but was unable to find a match for what I'm facing.  Thanks very much in advance!

AR488_Layouts.cpp:1241:3: error: 'mcpPinAssertedReg' was not declared in this scope
   mcpPinAssertedReg = 0;
   ^~~~~~~~~~~~~~~~~

AR488_Layouts.cpp:1310:7: error: 'mcpPinAssertedReg' was not declared in this scope
       mcpPinAssertedReg = mcpByteRead(MCPINTCAPA);
       ^~~~~~~~~~~~~~~~~
AR488_Layouts.cpp:1314:39: error: 'gpibsig' was not declared in this scope
       return (mcpPinAssertedReg & (1<<gpibsig));
                                       ^~~~~~~
exit status 1
'mcpPinAssertedReg' was not declared in this scope

FannyLoi, 2022-02-12:
I found the directive that was indicating use of an MCP chip; it seems the checked in code has this enabled for the MEGA board.  Thanks.

Twilight-Logic, 2022-02-12:
Thank you for reporting this. The latest code has support for MCP23x17 chips and this was developed on a Mega board. The setting may have been accidentally left enabled. I will check and correct as necessary.

FannyLoi, 2022-02-12:
Thanks for the follow-up, I will grab the latest code!

Closed 2022-02-12.

Thread 26 (2022-05-02):

AR488 was not declared in this scope when enabling SN7516X support

Mario-H, 2022-05-02:
Hi,

Build myself a controller with an ATMEGA328P chip and FR232R module and the 2 SN7516X transceivers.
Using IDE 1.18.15 (Win10) I can compile and upload the sketch just fine, but when I enable SN7516x support bij changing the relevant config lines to:

```
#define SN7516X

#ifdef SN7516X
 #define SN7516X_TE 6
 #define SN75161_DC 13
//  #define SN7516X_SC 12
#endif
```

I get a compile error: "AR488 was not declared in this scope" in line 511 of AR488.ino
`if (AR488.cmode==2) {`

(I did change the pin number for TE from 7 to 6 because I built the controller based on the schematic in the manual that uses pin 6 for TE and 13 for DC, but when I changed TE back to 7 I got the same compile error)

Am I missing something that I should configure?

Thanks,

Mario

Twilight-Logic, 2022-05-02:
Mario, thank you for your feedback.

Change line 511 from:

`  if (AR488.cmode==2) {
`
To:

`  if (gpibBus.cfg.cmode==2) {
`
It should then compile.

Please let me know if this fixes it.

Mario-H, 2022-05-02:
Hi,

With a 16 minutes response time that FIXED the problem you shouldn't worry about missing this.
Thanks!

Mario

Twilight-Logic, 2022-05-02:
Glad that fixed it. I will now update the code in the repository.

Mario-H, 2022-05-02:
While you're at it:
I can't get my HP8591A analyzer to respond on the commands I issue.
So I enabled all debug options hoping to get some insight in the problem.

Enabling DEBUG_IDFUNC generated another compile error in line2299 of AR488.ino :
`Found : in nested-name-specifier, expected '::'`

Is there any troubleshooting info in case the controller isn't able to control a device?
I now see a debug message:
 `NDAC timeout!GPIBbus::sendCmd: Failed to send command 3F to device 18`
What could be the reason for this?

I tried to send an "Instrument Preset" command but I have no idea what a normal error free debug log should look like.

Twilight-Logic, 2022-05-03:
Thanks. Another good spot! The quotes are missing around the character string. Change:

    `debugStream.println(F(id_h: done.));`

To:

    `debugStream.println(F("id_h: done."));`

I have now gone through and checked all the other debug statements. I found one more error which I have corrected. An update has been published to the GitHub.

With regards to the timeout, 3F is 'untalk' and would be the very fist byte sent in any command sequence. The error suggests that the HP8591A is not responding on the bus. There can be a number of reasons:

- problem GPIB cable
- problem with interface wiring
- GPIB interface not configured/enabled on the instrument
- instrument GPIB address not set using the ++addr command

If its none of the above, then if you have a logic analyser, you would be able to see what is actually being transmitted on the wire and each side of the SN7516x chips.

Mario-H, 2022-05-03:
Thanks for another quick fix!

As for my other problem:

- Address was set:
NDAC timeout!GPIBbus::sendCmd: Failed to send command 3F to **device 18**
- Changed cables
- There is no way to disable interface on the instrument
- checked the wiring multiple times (with conductivity tester) from µP to SN7516X chips and from there to the GBIP-connector.
- used ++xdiag to check all control and data lines
But I found no reliable way to really test the "out" side of the SN7516X chips. I assume this is because ++xdiag doesn't control TE and DE lines during the ++xdiag tests.

Since I don't own a logic analyser:
Is there a location in the code where I could insert a delay (say 2 to 5  seconds) before the next data (or bit) is written to the SN7516X chips so I can monitor the individual lines sort of real time?

Twilight-Logic, 2022-05-03:
That is an interesting point regarding ++xdiag and the outside pins of the SN75161x. I could possibly add this feature. Will need to have a think about how to accomplish it. Setting digitalWrite(SN7516X_TE,HIGH); just before gpibBus.setDataVal(val); (line 2141) or gpibBus.setControlVal (line 2147) should probably do it. For the data bus (case 0), it will need to be set back to LOW again after the delay. For the control bus (case 1), this will automatically happen when the command in line 2153 or 2155 gets executed.

When using ++xdiag, the selected pin state should be active for around 10 seconds before reverting back to idle. However, the interface should not be connected to anything during testing.

Which pin are you using for TE at the moment? I was puzzled in your opening post as to why you would be using pin 7 as that is allocated to the ATN signal? You probably want to be sticking with pin 6 and pin 13 (or 3 [REN]) for DC. When I was testing, I originally drove DC from a separate pin but later discovered that it was sufficient to simply connect it to REN. The effect is the same.

Mario-H, 2022-05-03:
Would be great if you would be able to implement controlling TE and DC with ++xdiag for configs using SN7516X chips.

With the delay I mean a sort of slow execution of the commands when writing to de bus. e.g.:
- Lower NDAC	& serial print "lowering NDAC"
delay(x)
- Raise NRFD	& serial print "Raising NRFD"
delay(x)

etc.

That would create some time to use a scope to see if what is supposed to happen according to the serial log is in fact visible on the scope.

As for TE:
In the schematic on page 42 of manual (version 0.49.11) TE is connected to pin 6 and DC to pin 13
So that's what I built

in AR488_Layouts.h I found:
```

/**************************************/
/***** UNO/NANO LAYOUT DEFINITION *****/
/***** vvvvvvvvvvvvvvvvvvvvvvvvvv *****/
#if defined(AR488_UNO) || defined(AR488_NANO)

/***** NOTE: UNO/NANO pinout last updated 21/09/2019 *****/
#define DIO1  A0  /* GPIB 1  : PORTC bit 0 */
#define DIO2  A1  /* GPIB 2  : PORTC bit 1 */
#define DIO3  A2  /* GPIB 3  : PORTC bit 2 */
#define DIO4  A3  /* GPIB 4  : PORTC bit 3 */
#define DIO5  A4  /* GPIB 13 : PORTC bit 4 */
#define DIO6  A5  /* GPIB 14 : PORTC bit 5 */
#define DIO7   4  /* GPIB 15 : PORTD bit 4 */
#define DIO8   5  /* GPIB 16 : PORTD bit 5 */

#define IFC    8  /* GPIB 9  : PORTB bit 0 */
#define NDAC   9  /* GPIB 8  : PORTB bit 1 */
#define NRFD  10  /* GPIB 7  : PORTB bit 2 */
#define DAV   11  /* GPIB 6  : PORTB bit 3 */
#define EOI   12  /* GPIB 5  : PORTB bit 4 */

#define SRQ    2  /* GPIB 10 : PORTD bit 2 */
#define REN    3  /* GPIB 17 : PORTD bit 3 */
#define ATN    7  /* GPIB 11 : PORTD bit 7 */      <= conflicts with definition below
```
Indicating that pin 6 and 13 are free. So far so good.

But in config.h the relevant lines are:
```
//#define SN7516X
#ifdef SN7516X
  #define SN7516X_TE 7       //      <= conflicts with definition above
//  #define SN7516X_DC 13
//  #define SN7516X_SC 12
#endif
```
Suggesting to use pin 7 (but that pin is used for ATN as can be seen in the layout above)

That's why I changed the definition to:
```
#define SN7516X
#ifdef SN7516X
  #define SN7516X_TE 6   // changed to avoid conflict with ATN
  #define SN7516X_DC 13
//  #define SN7516X_SC 12
#endif
```
So the manual is in line with the schematic on page 42 but the code in the repository is not.

Twilight-Logic, 2022-05-05:
Thank you for that observation. The SN7516x support was developed on a Mega 2560 and a completely different set of GPIO pins were used for the GPIB port. The pin assigned to SN7516X_TE should be a spare GPIO pin. I can see how that would have been confusing. To make things consistent, I amend this to pin 6. The change should appear in the next update, which I am hoping will be made available in the next few days.

Regarding the delay, thank you for the clarification. I think I now understand what you mean. The xdiag function was implemented as a means to turn a GPIB signal wire on or off and hold it in that state for 10 seconds. The idea was to make it possible to change the state of one or any number of wires at a time and test that the correct GPIO pin was responding.

The place to insert such delays might be in the GPIBbus::readByte() and GPIBbus::writebyte() function. This is the state machine that handles reading or writing a byte to the GPIB bus. When reading, the interface controls NRFD and NDAC. When writing it controls DAV. The comments indicate when each goes up and down ('assert' means pull the signal LOW - when a signal is un-asserted, the signal is HIGH). bear in mind that with a delay of 2-5 seconds it is highly unlikely that you will get a handshake or response from any connected instrument. Most instruments measure the timeout period in tenths or hundreds of milliseconds. However, you should hopefully be able to at least observe NDAC, NRFD and DAV changing state at the start of the handshake.

Mario-H, 2022-05-05:
Thanks for the explanation.

I'm currently restoring an 30 year old laptop that I used in the nineties to control the very same analyzer I now try to control.
That laptop still has the NI-GBIP interface card in it but the power supply is dead (hopefully that's the only problem with it). When I receive the part and hopefully get the laptop working I can test if the analyzer still has a working interface.
When it does I know for sure the problem lies with the AR488 interface.

If I can't revive the Laptop I will follow the route of implementing the delays en hope that in the mean time you find the time to implement the fix for ++xdiag that also controls the TE and DC pins.

Mario-H, 2022-05-16:
So the restoration of the laptop was a no go.
In the attic I found another 30 year old desktop with ISA slots and a working power supply but no Disk.
Took me a while to gather a disk and install DOS but in the end the pc was operational.
After inserting the NI-GBIP interface card and installing the drivers I was able to connect my analyzer.
And I now can say my cable and analyzer are not the problem as they work perfectly on the old PC.

That tells me the problem is somewhere in my AR488 interface. I have a feeling that the software had some upgrades/modifications since the last test on an MEGA 2560 and some SN7516x related routines may not have been updated.
The last thing I can do to verify this is to remove the SN7516x chips and put wire jumpers in the sockets to bypass the chips.
If the interface does work with SN7516x disabled then we know for sure where the problem lies.

Mario-H, 2022-05-19:
Progress!

Today I tested the interface with wire bridges in the IC-sockets of the two SN7516X chips.
Deactivated #define SN7516X in AR488_Conig.h, recompiled and uploaded the sketch.
Result: The analyzer responds to the commands I issue on the serial monitor.
So now I know that everything before and after the SN7516X chips is working as intended.
Next is getting the SN7516X chips involved.

I'm not 100% sure what you mean by:

> substituting the macros in GPIBbus::setControls() with your actual pin numbers and removing the #ifdef SN7516x wrapper.

Should I remove #ifdef SN7516x in AR488_Conig.h or in GPIBbus::setControls() or in both?

Twilight-Logic, 2022-05-21:
Dont’t change AR488_Config.ini. Only edit the AR488_GPIBbus.cpp file. In that file you will find a function called GPIBbus::setControls. In that function you need to:

- comment out any #ifdef ... #else ...  #endif statements
- Comment out any lines referring to SN75161_DC and SN75161_SC since you have not configured them.
- in the remaining lines, replace any instance of SN75161_TE and SN75161_DC with the actual pin number you are using.

Unfortunately I am rather ill and laid up in bed otherwise I would have provided you with the modified function.

The idea is to bypass and not rely on the macro definitions but to set the pins ditectly. It is possible the substitutions are not ocurring automatically as they  I am hoping that will work and provide at least a temporary solution until I am well enough to research the problem more fully.

Mario-H, 2022-05-21:
Thanks for the clarification.

Hope you recover soon from you illness.

So I replaced all references to SN75161_TE and SN75161_DC in GPIBbus::setControls() with the actual pin numbers (6 and 13 in my case)
Left #define SN7516X in config.h enabled and the wire jumpers in their place.
Uploaded the sketch and all worked.
Next I removed the wire jumpers from the SN75160 socket and inserted the SN75160 chip.
Tested again and it worked.
So the SN75160 control does not seem to be the issue.

Next I removed the wire jumpers from the SN75161 socket and inserted the SN75161 chip.
Tested again but this time the analyzer did not respond to the issues commands.

Before your last message I was going through the code in GPIBbus::setControls and put the states of TE, DC and SC in a table.
What I noticed is that DC and SC are only switched in CINI and DINI cases.
In all other cases they are left in their previous states it seems.
Could that be part of the problem?

Any suggestions on how to proceed troubleshooting?

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
?

Twilight-Logic, 2022-05-21:
The DC signal controls ATN, REN and IFC. In controller mode we transmit those signals, in device mode we listen to them. Thats why they only need to be set once depending on whether we are in Controller or Device mode. By default they are set in controller mode, but are switched when the user changes mode.

TE on the other hand controls the direction of data flow and so gets set appropriately depending on whether we need to read or write.

I have had previous confirmation that the SN7516x support works, although I am not dismissing your report. However, could I trouble you to just re-check the wiring around the SN75161 chip. Since your analyzer responded with the SN75160 in place, this suggests that TE states are switching OK, at least to that chip. If you have set the correct pin number for DC then that shouln’t be an issue either.

Mario-H, 2022-05-21:
I re-checked the wiring from Pin 13 on the ATMEGA328 chip to the DC-pin on the SN75161 chip and from pin 6 on the ATMEGA328 chip to the DC-pin on the SN75161 chip:
No fault found.
To make sure I also checked Vcc and Gnd of the SN75161 chip:
No fault found.

I did however find some references to SN7516X_DC and SN7516X_TE in AR488.ino and replaced them with the real pin numbers:
Still no response from the analyser.

I also removed the lines referring to the build-in led (my print doesn't have a led) in case that interfered with the DC signal on pin 13:
Still no response from the analyser.

Uploaded a simple blink sketch to toggle pin 13: Signal is present on DC-pin of SN75161.
Did the same for pin 6: Signal is present on TE-pin of SN75161 and Signal is present on TE-pin of SN75160.

Can you advise on any other tests I can perform?

Twilight-Logic, 2022-05-22:
There should be no neccesity to change anything in the main .ino file. I already have positive proof that those substitutions are working Ok by observing the output in the preproc directory which is found in the temp build directory created automatically by the IDE. I couldn’t see the same for the GPIBbus.cpp file though.

It looks like you have done some thorough testing and confirmed that the change of state on the GPIO pin is being reflected on the corresponding SN75161 pin. This unfortunately leaves the conclusion that the chip might be faulty? Do you have another chip to try?

When you send a command to the instrument, both REN and ATN should go from high to low. Are you seeing that on the output from the SN75161?

Mario-H, 2022-05-22:
I already came to the same conclusion that possibly the chip itself is the problem since my findings point less and less to the code being the problem.
Yesterday I ordered a replacement that should arrive Tuesday.

In the mean time I tested REN and ATN while sending a command as you suggested, but nothin happened on the output side of the SN75161
This again points at the chip itself being the cause.

When the chip arrives I will post an update of the results.

Twilight-Logic, 2022-05-22:
It is rather unusual for one of these to fail so I am still trying to keep an open mind. We will know for sure when the new chip arrives.

In the meantime, with the interface powered on and in standby (doing nothing) what states do you see on REN, IFC and ATN? I am guessing that „nothing happened” in your previous update meant that no voltage was present at any time?

I think you already checked VCC and please forgive the dumb question, but you are sure you have 0V on pin 10 AND it is connected to the common ground of the rest of the circuit (abscence of voltage is not sufficient) ? Apologies if you have already checked this.

Mario-H, 2022-05-23:
Correct, no voltage changes occurred at REN, IFC and ATN when I issued a command.
Yes I checked Vcc and Ground (measured against central ground and across Pin 10 and 20).

I'm not sure where I got the chips (had them for years) could be China, eBay or a more reliable source.
So I'm reluctant to dismiss the chip being the problem.

Hopefully we know more tomorrow.

Twilight-Logic, 2022-05-23:
I guess if you have 5V across pins 10 and 20 and pin 20 and „central ground” then the chip is grounded and must be getting power.

Since with GPIB a signal is inactive when HIGH, both IFC and ATN should be at 4.5-5V. When a command is issued ATN should get pulled LOW indicating that it is asserted. IFC gets pulled LOW for a few milliseconds during startup but should otherwise stay HIGH. REN would get pulled LOW at startup in controller mode or possibly when the first command is Either way you should have been able to see something happening on REN and ATN. Lets hope the new chip fixes it.

Mario-H, 2022-05-24:
The new chip arrived today.
Put it in the socket and tested the interface.
SUCCESS it finally works!

I feel I must apologize for taking up so much of your time helping me to figure out why my interface wasn't working.
Thanks a lot for all your support and patience with me and mij interface.

Now I can start with coding some software to control my analyzer.

Mario-H, 2022-05-24:
Thanks.
All test were done using the modified code.
I only disabled the debug functions so the output is only analyzer results.
I already downloaded the latest version of the software from GitHub but have not yet uploaded it to the interface.
As soon as I have done that I will report back if that works out of the box or not.

Mario-H, 2022-05-25:
So I uploaded the latest version (0.51.07) to the interface.
I only enabled #define SN7516X and #define SN7516X_DC 13 in AR488_Config.h
The analyzer responds to all the command I send and I can read the response with ++read.
So now we both know this version works as expected with an barebone ATMEGA328 and the two SN7561X chips
FYI: I use a FTDI USB-Serial interface and added a jumper to disable reboots when opening the com port.
When I need to update the software I only have to put the jumper in to enable DTR to reset the ATMEGA328.
Perfboard setup of my interface:

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

Twilight-Logic, 2022-05-25:
Thank you for taking the time and trouble to do that and confirm the outcome. I was worried that there might still be a problem to resolve in the code but I am releived it works OK a I don't have to worry about is and can concentrate on my recovery!

You have done a great job of the interface. Those wires are nicely and neatly arranged. I think this is the first one I have seen done on Perfboard. You don't see it so much of it  these days. I have used it occasionally myself. Congratulations on a job well done!

I think I can now close this issue.
Regards.

Mario-H, 2022-05-25:
Thanks for the compliments. Fore one time small projects I still use perfboards now and then.
Sure go ahead and put it in the manual. Perhaps other users can use it.

Next I'm going to look into detecting errors on the GPIB-bus.
I've been reading the 30 year old manuals from my National Instruments interface and there were several functions available for detecting errors.

Thanks for all you support and I hope your recovery will be a quick one.

Thread 27 (2022-05-08):

ESP32 status

rhaamo, 2022-05-08:
ESP32 directly with wireless builtin would be very great, what is the status of being able to use a nodemcu or equivalent in pin count ?

Twilight-Logic, 2022-05-08:
dourada has ported the AR488 code to the ESP32. You can find his project here:

https://github.com/douardda/AR488

I am not sure whether he has used a 30 or 38 pin version of the NodeMCU board but considering the price difference is small, it is probably worth having the extra pins. I haven't tested his code myself, but hopefully he will be able to tell you more.

rhaamo, 2022-05-08:
oh great thanks!

maybe it would be better to only have one project for everything.

I will look at their fork and give it a try.

Closed 2022-05-21.

Thread 28 (2022-05-28):

Command: ++id verstr not working

Mario-H, 2022-05-28:
Sorry for interrupting your recovery but I think you want to know this.

/***** FWVER "AR488 GPIB controller, ver. 0.51.07, 05/05/2022" *****/

++id verstr
Returns "Unrecognized command"

Got it working by changing line 2231 in AR488.ino from

```if (strncmp(keyword, "verstr", 6)==0) {```

to

```if (strncasecmp(keyword, "verstr", 6)==0) {```

Twilight-Logic, 2022-05-29:
Thank you for reporting. I will update the sketch.

Twilight-Logic, 2022-06-20:
This has now been addressed in version 0.51.09.
Thanks.

Thread 29 (2022-07-23):

Arduino Mega doesn't work with Luke Mester’s HP3478 Control

Minu-IU3IRR, 2022-07-23:
i have built the interface with an Arduino Mega board, i can not get a connection with the software because it does not recognize it.
i tried a blank Arduino uno and every thing woks so the issue is limited to the Mega boards. other software works fine.

Twilight-Logic, 2022-07-27:
Thank you for your report. Theoretically there shouln't be any difference, however, I will dig out my Mega and give it a test with Luke's software. Are both boards genuine Arduino boards or clones?

Minu-IU3IRR, 2022-07-27:
Hi, thanks for the reply. both are clones, i have dug deeper and looks like
the Mega takes a few hundreds of milliseconds more to boot up than the uno.
I have seen in an EEVblog that Luke's software already uses a delay in the
serial port opening to wait for the arduino to boot up, maybe the delay is
fine for the uno but not the Mega?

By the way, i have write some python scripts to automate instruments and
measures, if you would like to take a look please visit
https://github.com/Minu-IU3IRR/AR488_GPIB_python_control,  if you like it
feel free to feature it in ine AR488 repo!

Manuel, IU3IRR

Il giorno mer 27 lug 2022 alle ore 22:45 Twilight-Logic <
***@***.***> ha scritto:

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

Twilight-Logic, 2022-07-27:
Manuel,

Thank you for the feedback. One of the reasons for asking was to ascertain whether the might a difference in the UART being used. Mega 2560 clones have the same CH340 chip onboard as the Uno so that rules out a different behaviour due to UART hardware. The timing of the delay might be relevant however.

I was just in the process writing an e-mail to Luke to ask him whether he has ever tested his program with a Mega so I will forward this information to him and will forward you his reply.

Thanks for pointing out the scripts. It is interesting to see other projects being written and designed to work with the AR488. I might see whether I can adapt one of them to work with the HP34401A or perhaps even the Keithley 2000.

Minu-IU3IRR, 2022-07-27:
thank you very much, unfortunately i do not have a 34401 or a Kiethley 2000
so i have not written anything.
If you need any help on adapting my script please get in touch, also since
i am still learning I would like to see how someone else modify my work!

Manuel, IU3IRR

Il giorno mer 27 lug 2022 alle ore 23:15 Twilight-Logic <
***@***.***> ha scritto:

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

Twilight-Logic, 2022-12-27:
I have just received word from Luke Mester that he has added a couple of new settings in his program to allow control of the reboot delay and GPIB command response delay. Could you try his latest version and let me know whether it solves the problem?

woodromi, 2023-01-08:
I also have some issues with the Mega 2560 in device mode and usage of sn7516x buffers. I‘m not able to send data to the AR wit the NI Visa tool. I tested without the buffers with same issues. With nano board it works fine. Has anybody tested the mega2560 with success?

Twilight-Logic, 2023-01-09:
Can you elaborate on the issues you are having please? Looks like you have eliminated the 7516x buffers. Which Mega2560 layout are you using please?

woodromi, 2023-01-14:
Hi, I did some further Investigations with the SN7516X buffers an switched to a Arduino Uno board now (original). My Mega Boards have also been original Arduino ones, no clones...

I have defined a start maco to bring the AR488 in device mode:
#define MACRO_0 "\
++mode 0\n\
++addr 20\n\
++eos 2\n\
"

after programming the mode and adrr is set correct:
C:\Users\micha\Desktop\AR488-master\AR488-master\src\AR488\AR488_GPIBbus.cpp:845 (setControls) > Initialised GPIB listener mode
AR488 ready (device).
20 -> sepsonse to ++addr in debug arduino serial window

I'm using NI VISA Interactive control tool to communicate with devices. When I open the tool an do a bus scan the AR488 is not present on the bus, but the AR488 gives some responses on serial port to the bus scan since debug is active:

C:\Users\micha\Desktop\AR488-master\AR488-master\src\AR488\AR488_GPIBbus.cpp:869 (setControls) > Set GPIB lines to idle state
C:\Users\micha\Desktop\AR488-master\AR488-master\src\AR488\AR488_GPIBbus.cpp:1091 (readByte) > Error: 2
C:\Users\micha\Desktop\AR488-master\AR488-master\src\AR488\AR488_GPIBbus.cpp:858 (setControls) > Set GPIB lines to idle state
C:\Users\micha\Desktop\AR488-master\AR488-master\src\AR488\AR488_GPIBbus.cpp:845 (setControls) > Initialised GPIB listener mode
C:\Users\micha\Desktop\AR488-master\AR488-master\src\AR488\AR488_GPIBbus.cpp:869 (setControls) > Set GPIB lines to idle state
C:\Users\micha\Desktop\AR488-master\AR488-master\src\AR488\AR488_GPIBbus.cpp:1091 (readByte) > Error: 2
C:\Users\micha\Desktop\AR488-master\AR488-master\src\AR488\AR488_GPIBbus.cpp:845 (setControls) > Initialised GPIB listener mode

Since the AR is not present I open the instrument with the resource string in the NI tool manually (GPIB0::20::INSTR). After opening the communication to the AR488 it goes in endless loop:

C:\Users\micha\Desktop\AR488-master\AR488-master\src\AR488\AR488_GPIBbus.cpp:549 (receiveData) > After loop flags:
C:\Users\micha\Desktop\AR488-master\AR488-master\src\AR488\AR488_GPIBbus.cpp:551 (receiveData) > TMO: 0
C:\Users\micha\Desktop\AR488-master\AR488-master\src\AR488\AR488_GPIBbus.cpp:552 (receiveData) > Bytes read:  0
C:\Users\micha\Desktop\AR488-master\AR488-master\src\AR488\AR488_GPIBbus.cpp:553 (receiveData) > <- End listen.
C:\Users\micha\Desktop\AR488-master\AR488-master\src\AR488\AR488_GPIBbus.cpp:858 (setControls) > Set GPIB lines to idle state
C:\Users\micha\Desktop\AR488-master\AR488-master\src\AR488\AR488_GPIBbus.cpp:596 (receiveData) > done.
C:\Users\micha\Desktop\AR488-master\AR488-master\src\AR488\AR488_GPIBbus.cpp:858 (setControls) > Set GPIB lines to idle state
C:\Users\micha\Desktop\AR488-master\AR488-master\src\AR488\AR488_GPIBbus.cpp:869 (setControls) > Set GPIB lines to idle state
C:\Users\micha\Desktop\AR488-master\AR488-master\src\AR488\AR488_GPIBbus.cpp:1091 (readByte) > Error: 6
C:\Users\micha\Desktop\AR488-master\AR488-master\src\AR488\AR488_GPIBbus.cpp:845 (setControls) > Initialised GPIB listener mode
C:\Users\micha\Desktop\AR488-master\AR488-master\src\AR488\AR488_GPIBbus.cpp:869 (setControls) > Set GPIB lines to idle state
C:\Users\micha\Desktop\AR488-master\AR488-master\src\AR488\AR488_GPIBbus.cpp:1091 (readByte) > Error: 6
C:\Users\micha\Desktop\AR488-master\AR488-master\src\AR488\AR488_GPIBbus.cpp:845 (setControls) > Initialised GPIB listener mode
C:\Users\micha\Desktop\AR488-master\AR488-master\src\AR488\AR488_GPIBbus.cpp:869 (setControls) > Set GPIB lines to idle state
C:\Users\micha\Desktop\AR488-master\AR488-master\src\AR488\AR488_GPIBbus.cpp:1091 (readByte) > Error: 6
C:\Users\micha\Desktop\AR488-master\AR488-master\src\AR488\AR488_GPIBbus.cpp:845 (setControls) > Initialised GPIB listener mode
C:\Users\micha\Desktop\AR488-master\AR488-master\src\AR488\AR488_GPIBbus.cpp:869 (setControls) > Set GPIB lines to idle state

I'm able to perfomr a read request in NI Tool and the data will be transfered correct from AR488 to NI Tool:

C:\Users\micha\Desktop\AR488-master\AR488-master\src\AR488\AR488_GPIBbus.cpp:869 (setControls) > Set GPIB lines to idle state
C:\Users\micha\Desktop\AR488-master\AR488-master\src\AR488\AR488_GPIBbus.cpp:1091 (readByte) > Error: 2
C:\Users\micha\Desktop\AR488-master\AR488-master\src\AR488\AR488_GPIBbus.cpp:858 (setControls) > Set GPIB lines to idle state
C:\Users\micha\Desktop\AR488-master\AR488-master\src\AR488\AR488_GPIBbus.cpp:880 (setControls) > Set GPIB lines for listening as addresed device
C:\Users\micha\Desktop\AR488-master\AR488-master\src\AR488\AR488.ino:2654 (device_talk_h) > LnRdy: 2
C:\Users\micha\Desktop\AR488-master\AR488-master\src\AR488\AR488.ino:2655 (device_talk_h) > Buffer: testTest
C:\Users\micha\Desktop\AR488-master\AR488-master\src\AR488\AR488_GPIBbus.cpp:880 (setControls) > Set GPIB lines for listening as addresed device
C:\Users\micha\Desktop\AR488-master\AR488-master\src\AR488\AR488_GPIBbus.cpp:640 (sendData) > write data mode is set.
C:\Users\micha\Desktop\AR488-master\AR488-master\src\AR488\AR488_GPIBbus.cpp:641 (sendData) > begin send loop->
testTestC:\Users\micha\Desktop\AR488-master\AR488-master\src\AR488\AR488_GPIBbus.cpp:661 (sendData) > <-End of send loop.
C:\Users\micha\Desktop\AR488-master\AR488-master\src\AR488\AR488_GPIBbus.cpp:678 (sendData) > appended LF
C:\Users\micha\Desktop\AR488-master\AR488-master\src\AR488\AR488_GPIBbus.cpp:858 (setControls) > Set GPIB lines to idle state
C:\Users\micha\Desktop\AR488-master\AR488-master\src\AR488\AR488_GPIBbus.cpp:721 (sendData) > done.
C:\Users\micha\Desktop\AR488-master\AR488-master\src\AR488\AR488_GPIBbus.cpp:858 (setControls) > Set GPIB lines to idle state

When I try a write command in NI Visa Tool and send "IDN*?" to the AR 488 I get an error:
VISA: there was no listener condition realized (NRFD and NDAC are canceled) -> translated form german to english

The AR resonds to the the READ request with the following in debug window:

C:\Users\micha\Desktop\AR488-master\AR488-master\src\AR488\AR488_GPIBbus.cpp:869 (setControls) > Set GPIB lines to idle state
C:\Users\micha\Desktop\AR488-master\AR488-master\src\AR488\AR488_GPIBbus.cpp:1091 (readByte) > Error: 2
C:\Users\micha\Desktop\AR488-master\AR488-master\src\AR488\AR488_GPIBbus.cpp:858 (setControls) > Set GPIB lines to idle state
C:\Users\micha\Desktop\AR488-master\AR488-master\src\AR488\AR488_GPIBbus.cpp:869 (setControls) > Set GPIB lines to idle state
C:\Users\micha\Desktop\AR488-master\AR488-master\src\AR488\AR488_GPIBbus.cpp:869 (setControls) > Set GPIB lines to idle state
C:\Users\micha\Desktop\AR488-master\AR488-master\src\AR488\AR488_GPIBbus.cpp:487 (receiveData) > Start listen ->
C:\Users\micha\Desktop\AR488-master\AR488-master\src\AR488\AR488_GPIBbus.cpp:488 (receiveData) > Before loop flags:
C:\Users\micha\Desktop\AR488-master\AR488-master\src\AR488\AR488_GPIBbus.cpp:489 (receiveData) > TRNb: 0
C:\Users\micha\Desktop\AR488-master\AR488-master\src\AR488\AR488_GPIBbus.cpp:490 (receiveData) > rEOI: 1
C:\Users\micha\Desktop\AR488-master\AR488-master\src\AR488\AR488_GPIBbus.cpp:1091 (readByte) > Error: 6

C:\Users\micha\Desktop\AR488-master\AR488-master\src\AR488\AR488_GPIBbus.cpp:549 (receiveData) > After loop flags:
C:\Users\micha\Desktop\AR488-master\AR488-master\src\AR488\AR488_GPIBbus.cpp:551 (receiveData) > TMO: 6
C:\Users\micha\Desktop\AR488-master\AR488-master\src\AR488\AR488_GPIBbus.cpp:552 (receiveData) > Bytes read:  0
C:\Users\micha\Desktop\AR488-master\AR488-master\src\AR488\AR488_GPIBbus.cpp:553 (receiveData) > <- End listen.
C:\Users\micha\Desktop\AR488-master\AR488-master\src\AR488\AR488_GPIBbus.cpp:568 (receiveData) > Timeout waiting for sender!
C:\Users\micha\Desktop\AR488-master\AR488-master\src\AR488\AR488_GPIBbus.cpp:569 (receiveData) > Timeout waiting for transfer to complete!
C:\Users\micha\Desktop\AR488-master\AR488-master\src\AR488\AR488_GPIBbus.cpp:858 (setControls) > Set GPIB lines to idle state
C:\Users\micha\Desktop\AR488-master\AR488-master\src\AR488\AR488_GPIBbus.cpp:596 (receiveData) > done.
C:\Users\micha\Desktop\AR488-master\AR488-master\src\AR488\AR488_GPIBbus.cpp:858 (setControls) > Set GPIB lines to idle state

The behavior is the same with Arduino Mega  (original Arduinos). I tried two of them and checked cabeling many times. Now I'm using the uno like mentioned at the beginning (DC is connected to Pin 13 and TE to 6) like the example of the manual.

When I'm using an arduino nano without buffers the device mode works correct and I can send and read data with the VI tool.

It seems there is another general issue during the bus scan. If only a GPIB master and the AR488 are on the bus they AR will not be detected as instrument. If another instrument like multimeter is present on the bus the bus scan shows a lot of instruments which are not really present on the bus. But in this case also the AR488 will be listed and can be opened for communication.

I hope this helps you

woodromi, 2023-01-16:
Hello,

just one question concerning interrupts on the mega 2560. Why is the interrupt section for the 2560 deault layout in AE488_Layouts.cpp commentet out and not active?

USE_INTERRUPTS in config will not activate.

/***** Enable interrupts *****/
/*
#ifdef USE_INTERRUPTS

volatile uint8_t atnPinMem = ATNPREG;
volatile uint8_t srqPinMem = SRQPREG;
static const uint8_t ATNint = 0b00100000;
static const uint8_t SRQint = 0b00010000;

void interruptsEn(){
  cli();
  PCICR |= 0b00000001;  // PORTB
  PCMSK0 |= (SRQint^ATNint);
  sei();
}

#pragma GCC diagnostic error "-Wmisspelled-isr"
*/
/***** Interrupt handler *****/
/*
ISR(PCINT0_vect) {

  // Has PCINT5 fired (ATN asserted)?
  if ((ATNPREG ^ atnPinMem) & ATNint) {
    isATN = (ATNPREG & ATNint) == 0;
  }

  // Has PCINT4 fired (SRQ asserted)?
  if ((SRQPREG ^ srqPinMem) & SRQint) {
    isSRQ = (SRQPREG & SRQint) == 0;
  }

  // Save current state of PORTD register
  atnPinMem = ATNPREG;
  srqPinMem = SRQPREG;
}

#endif //USE_INTERRUPTS
*/
#endif //MEGA2560
/***** ^^^^^^^^^^^^^^^^^^^^^^^^^^^^^^^ *****/
/***** MEGA2560 BOARD LAYOUT (Default) *****/
/*******************************************/

Twilight-Logic, 2023-01-18:
The interface no longer depends on interrupts so ENABLE_INTERRUPTS is deprecated and no longer used. Hence it is commented out. The commented out code needs to be removed. Thank you for bringing this to my attention.

As regards the errors you are getting, these appear to be GPIB communication errors. It seems you have made some progress though? Enabling debugs does affect timing as it takes CPU time to print the debug message. I have tried to minimise this as best I could but it does have unexpected effects sometimes.

I have never used the National Instruments VISA tools as it is commercial and I would have to purchase it and its not cheap. For this reason, I have not done any testing with it. I would be interested in what commands it sends to do a bus scan? I imagine its either a serial or parallel poll but it is strange the way it reports multiple instruments like that.

Thank you for taking the time and trouble to report back with your findings. I will dig my Mega 2560 out again and do some tests.

woodromi, 2023-01-21:
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

woodromi, 2023-01-21:
Hi thx for the input.

I ordered a logic analyzer to debug the bus since I'm not really familar with the protocal. What I have figured out today is that the data bits are inverted. High signal is logical zero and the analyzer has to invert the data bits to decode. Seems this is not possible in the software so I have to do by hand and I was able to decode my ASCII characters which I have transefered over the bus.

At the beginning of the transfer ATN indicates a transfer and three bytes are send to the devic. Can you explain to me what is the content of these bytes? One of them should contain the address of the device.

After ATN start and transfer of the three bytes it goes back to high and the payload is transfered in my example the character 'A' follow by the end character '\n'. I also have use the EOI signal to indicate the end of transfer. Looks good so far and I have understood the principle of the write transfer. I can't show NRFD and NDAC because I'm behind the buffer and the buffer is hard configurated as Listener. I'm using a NI GPIB-USB-HS and a Agilent GPIB Multimeter to analyze the transfer.

By the was you can use the NI GPIB_USB-HS china closens which are sold on ebay for about 120 EUR. I never had issues with them and used more than ten in different companys over the years.

I want to use the AR488 in our RF instruments to replace the NI NAT7210. NI has replace the controller by a ASIC which is sold for 450EUR now and I'm not willing to pay so much money. I think they want to bury the good old GPIB bus.

I have forgotten to mention that a arduino nano without the buffers is working good as device. The only problem is the bus scan and it also shows instruments which are not present on bus. There must be a issue with the buffer switching on DC or TE line when activating them in your software.

In any case I like the AR488 project!

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

Twilight-Logic, 2023-01-21:
Yes, you are correct. Signals are inverted, so the signal is asserted when pulled low to ground and un-asserted when the signal is high. When the controller wants to send something, it initially asserted ATN then sends commnads. Usually it will first send untalk and unlisten bytes, then a talk or listen address and finally a command byte. Much of it is described here:

https://www.hp9845.net/9845/tutorials/hpib/

The buffer control states are set primarily in `void setup()` and the `void GPIBbus::setControls(uint8_t state)` function
in the `AR488_GPIBbus.cpp` file.

jamesdkelly15, 2024-10-05:
I have been working through wiring up an Arduino Mega 2560 and believe I have found that in the AR488-manual.pdf there seems to be inconsistencies amongst the wiring diagrams for Arduino Mega 2560 layouts E1 and E2 (page 48), the Arduino Mega 2560 E1/E2 pinout diagram (page 49), and the pinout definitions for layouts E1/E2 specified in AR488_Layouts.h. This may be causing some people to wire up their Mega 2560 incorrectly for layouts E1/E2 when running the current source code. I also noticed in AR488_Layouts.h, line 70, for the default layout DIO1 is defined as "DIO1_PIN_PIN" that I believe should just be "DIO1_PIN".

Twilight-Logic, 2024-10-05:
Thank you for reporting these problems. When I am feeling a bit better I will check the layouts. DIO1_PIN_PIN should indeed read DIO1_PIN. Looks like I need to g through the layouts and check them.

Thread 30 (2022-10-09):

DEVNULL.h missing at compilation w/ solution

SensorPlay, 2022-10-09:
Fresh install of Arduino IDE 2.0 and 1.8.19 generates a compile time error w/ AR488 0.51.09:

"DEVNULL.h missing"

solved by adding official DEVNULL library using Arduino IDE "Libraries Manager"

described more here:  https://www.arduino.cc/reference/en/libraries/devnull/

Twilight-Logic, 2022-10-09:
That is the solution. Install the official DevNull library using the Libraries Manager. I have already added this information to the Readme and the manual so it will be included when the next update is published.

Twilight-Logic, 2022-10-12:
Information about DEVNULL has now been added to the published ReadMe as well as the manual.

Closed 2022-10-12.

Thread 33 (2022-12-16):

Crash with binary data.

donnie-j, 2022-12-16:
Thanks for the great work, I have a number of these devices connected to instruments here and there, incredibly useful.

I'm atm working with a Tektronix scope, trying to get binary data from it, using a atmega32u4 device (back of the connector board).  ++ver AR488 GPIB controller, ver. 0.51.15, 12/10/2022

I'm seeing a reproducible crash once the transfer reaches a certain point.  Several 10s of kB.  It is not clear if it is data dependent (although there is nothing special about the place in the data stream where the crash occurs), byte or transfer count dependent (although it does happen at the same place with the same data), or something related to the instrument (e.g. timeout).

The symptom is at a certain point, the AR488 device will appear to hang, and then disappear from the USB bus.  It leaves the MacOS CDC driver in an inconsistent state also.  It is not certain that the instrument will crash, but it often hangs... causality of that is unclear.

What is a good way to debug this?  That is, how have the developers been debugging such issues?

Thanks again in advance.

Twilight-Logic, 2022-12-16:
Thanks for the report. Its an interesting problem. My first thought was whether its the Arduino hardware, so could I ask whether you have tried another 32u4 Micro board or even just simply another USB cable? (I am assuming the Arduino Micro from your description - 'back of the connector board' - and mention of 'atmega32u4')

It is curious that the USB bus is being de-stabilised. The interface does not buffer bytes incoming in from the GPIB bus but writes them directly to the serial port. In theory, the next byte would not be read from GPIB until Serial had completed writing the previous one. Presumably Serial would wait if the buffer was full which might result in a slight delay and possible timeout reading the GPIB bus. In that event, the GPIB transmission would simply stop and the instrument would simply be left waiting for the next read handshake. It would, in effect, 'hang' and just sit there waiting for the signal to send the next byte in its send buffer.

As to what may be de-stablising USB I am not sure, but since serial CDC is implemented in software, it could possibly be a serial buffer overrun or some other CDC implementation problem. If the serial CDC port were ro de-stabilise or 'disappear', then I imagine that would leave USB in an inconsistent state.

The default baud rate is set at 115200. One option might be to try a higher rate such as 128000 or 256000 to get faster throughput and see whether this helps.

You could also try enabling #define DEBUG_GPIBbus_RECEIVE and watching the transfer on a serial terminal (e.g. PuTTy or even Serial Monitor in the IDE). That might indicate whether the 'hang' occurs at a specific place or byte in the transmission. I would appreciate seeing the output of that (screenshot or preferably log) as it may indicate whether a specific byte is causing the problem.

It would also help if I could provide the settings you are using for the interface.

donnie-j, 2022-12-16:
Thanks for the that, it's a pro micro clone.  There is not much there, I'd expect larger problems if it was hardware.  I'll try putting a scope on the power rails to see if driving the GPIB is causing a noise problem, but there seem to be a few tantalum decoupling capacitors on the board.

To try and narrow down what triggers the fault, I set it up to run 100,000 queries for 500 points of waveform (about 1700bytes) as fast as possible in ascii instead of binary.  That runs about 50k cycles and then the AR488 code gets into a bad state and replies to any ++ command with 'Unknown command'.  ++ver ++rst ++read, doesn't matter what.  Clearly, there is memory corruption, and all bets are off at that point.

So I tried 100,000 queries for ++ver while disconnected from the instrument, and that seems to work.  I'll try 1M...

Some test code, built on a wrapper that tries to emulate the Linux-GPIB API (and the Tek TDS firmware tool I'm trying to run... which works until it doesn't with AR488) is here in case you can see something stupid...

[AR488 test code.zip](https://github.com/Twilight-Logic/AR488/files/10249558/AR488.test.code.zip)

Twilight-Logic, 2022-12-17:
Thank you for the update and testing. I will investigate and review the code, in particular the GPIB read routine. Maybe its a stack overflow problem or something. Curious that it can still reply to command even though it is doing so incorrectly.

donnie-j, 2022-12-24:
Huh.  I have a suspicion that this is a bus contention problem.  After crashing, the 32u4 slows heats up.  I think I should probably build another one also.

Chased around refactoring the code for quite a while this evening.  Found that changing PBSIZE (smaller or larger) caused it to be completely non functional.   Suspected the local char line[PBSIZE] overflowing the stack... moving that off the stack seems to allow PBSIZE to be changed, or it might be coincidence ;)

Also found in GPIBbus::sendData
```
      // Otherwise ignore non-escaped CR, LF and ESC
      if ((data[i] != CR) || (data[i] != LF) || (data[i] != ESC)) err = writeByte(data[i], NO_EOI);
```
Which surely should be
```
      // Otherwise ignore non-escaped CR, LF and ESC
      if ((data[i] != CR) && (data[i] != LF) && (data[i] != ESC)) err = writeByte(data[i], NO_EOI);
```

Happy Holidays :)

Twilight-Logic, 2022-12-24:
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

Yes, I think you are absolutely correct! Thank you for spotting that. It will be corrected.

> Chased around refactoring the code for quite a while this evening. Found that changing PBSIZE (smaller or larger) caused it to be completely non functional. Suspected the local char line[PBSIZE] overflowing the stack... moving that off the stack seems to allow PBSIZE to be changed, or it might be coincidence ;)

The stack overflowing is a possibility I suppose if several commands were to be sent in quick succession and several instances of execCmd() were then queued up on the stack. There are only so many instances of a 128-byte buffer that a Uno or Micro with 2kb or 2.5kb of dynamic memory could handle, bearing in mind that 40-50% of memory is already being allocated at startup time. I am not sure why that would happen or why I ended up copying the parse buffer into a separate 'line' buffer within the execCmd() function but serial was implemented in a slightly different way in older versions. You could try substituting this code which avoids the additional buffer entirely:

```
/***** Execute a command *****/
void execCmd(char *buffr, uint8_t dsize) {

#ifdef DEBUG_CMD_PARSER
  DB_HEXB_PRINT(F("command received: "), buffr, dsize);
#endif

  // Its a ++command so shift everything two bytes left (ignore ++) and parse
  for (int i = 0; i < dsize-2; i++) {
    buffr[i] = buffr[i + 2];
  }

  // Replace last two bytes with a null (\0) character
  buffr[dsize - 2] = '\0';
  buffr[dsize - 1] = '\0';

#ifdef DEBUG_CMD_PARSER
  DB_HEXB_PRINT(F("sent to command processor: "), buffr, dsize-2);
#endif

  // Execute the command
  if (isVerb) dataPort.println(); // Shift output to next line
  getCmd(buffr);

  // Flush the parse buffer and clear ready flag
  flushPbuf();
  lnRdy = 0;

  // Show a prompt on completion?
  if (isVerb) showPrompt();
}
```
I tested it with a python script that runs a few commands on a HP34401A and it seemed to work OK. I would be interested to know whether it makes a difference.

Closed 2025-04-08.

Thread 34 (2022-12-20):

++mode

corrySWDev, 2022-12-20:
Comments and help file have the incorrect value for the ++mode for device and controller

Twilight-Logic, 2022-12-21:
Thank you for spotting and reporting that! Yes, the values are reversed. Should be 1 for controller ans 0 for device. It will be corrected in the next release.

Twilight-Logic, 2023-02-27:
Should now be fixed in version 0.51.18

Closed 2023-05-04.

Thread 36 (2023-04-16):

which is best MCU to choose from?

dreamcat4, 2023-04-16:
hello,
I have here 34401a and was just wondering which MCU is best option. For my own situation: i have a variety here. But do not want to be bothered too much with custom PCB. Unless it can be justified, for example to make a better compatibility etc.

PC runs linux

Please let me know what to choose. Many thanks

Twilight-Logic, 2024-05-10:
Artag's solution using the Pro Micro board works just fine. I would recommend avoiding the CH340 chip if possible as it does not support serial handshaking . Genuine Arduino boards with a 16u2, or anything with a CP2102 or P2102 should work fine.

Closed 2024-05-10.

Thread 37 (2023-05-29):

Custom Board (teensy 3.1 with SN7516X) problems with DAV and SRQ not asserting

RussellSenior, 2023-05-29:
With current master branch (hash: f5c948f1275ef3c1109b32466cb4cfb077d5caef with the patch below) 0.51.18 on a handwired protoboard using a PJRC Teensy 3.1 and SN75160/SN75161 transceiver chips.

```
diff --git a/src/AR488/AR488.ino b/src/AR488/AR488.ino
index efe34c9..2d54271 100644
--- a/src/AR488/AR488.ino
+++ b/src/AR488/AR488.ino
@@ -288,6 +288,10 @@ void setup() {
   digitalWrite(LED_BUILTIN, LOW);
 #endif

+#ifdef SN7516X_PE
+  pinMode(SN7616X_PE, OUTPUT);
+  digitalWrite(SN7616X_PE, HIGH);
+#endif

 #ifdef PIN_REMOTE
   pinMode(PIN_REMOTE, OUTPUT);
@@ -1480,7 +1484,7 @@ void rst_h() {
   };
 #else
   // Otherwise restart program (soft reset)
-  asm volatile ("  jmp 0");
+  // asm volatile ("  jmp 0");
 #endif
 }

diff --git a/src/AR488/AR488_Config.h b/src/AR488/AR488_Config.h
index 057a973..f98c865 100644
--- a/src/AR488/AR488_Config.h
+++ b/src/AR488/AR488_Config.h
@@ -24,7 +24,7 @@
 /*
  * Uncomment to use custom board layout
  */
-//#define AR488_CUSTOM
+#define AR488_CUSTOM

 /*
  * Configure the appropriate board/layout section
@@ -155,14 +155,15 @@
  * This will require the use of an additional GPIO pin to control
  * the read and write modes of the ICs.
  */
-//#define SN7516X
+#define SN7516X
 #ifdef SN7516X
 //  #define SN7516X_TE 6
 //  #define SN7516X_DC 13
 //  #define SN7516X_SC 12
   // ONLYA board
-  #define SN7516X_TE 13
-  #define SN7516X_DC 5
+  #define SN7516X_TE 16
+  #define SN7516X_DC 17
+  #define SN7616X_PE 19
 #endif

@@ -265,24 +266,25 @@
 /***** vvvvvvvvvvvvvvvvvvv *****/
 #ifdef AR488_CUSTOM

-#define DIO1  A0  /* GPIB 1  */
-#define DIO2  A1  /* GPIB 2  */
-#define DIO3  A2  /* GPIB 3  */
-#define DIO4  A3  /* GPIB 4  */
-#define DIO5  A4  /* GPIB 13 */
-#define DIO6  A5  /* GPIB 14 */
-#define DIO7  4   /* GPIB 15 */
-#define DIO8  5   /* GPIB 16 */
-
-#define IFC   8   /* GPIB 9  */
-#define NDAC  9   /* GPIB 8  */
-#define NRFD  10  /* GPIB 7  */
-#define DAV   11  /* GPIB 6  */
-#define EOI   12  /* GPIB 5  */
-
-#define SRQ   2   /* GPIB 10 */
-#define REN   3   /* GPIB 17 */
-#define ATN   7   /* GPIB 11 */
+// PORT D
+#define DIO1  2
+#define DIO2 14
+#define DIO3  7
+#define DIO4  8
+#define DIO5  6
+#define DIO6 20
+#define DIO7 21
+#define DIO8  5
+
+// PORT C
+#define IFC   15
+#define NDAC  22
+#define NRFD  23
+#define DAV    9
+#define EOI   10
+#define SRQ   11
+#define REN   13
+#define ATN   12

 #endif
 /***** ^^^^^^^^^^^^^^^^^^^ *****/

```

I started to play with AR488 in order to talk to an HP 7440A Pen Plotter. Not getting any response, I began probing with a DVM and ++xdiag, and found that two pins (SRQ and DAV) leading to from the Teensy to the SN75161 were not asserting successfully, instead of zero volts, I see about 0.5V instead, not low enough to cause the GPIB side of the SN75161 chip to go low. I don't see an electrical problem on the board (no shorts or opens that I can find).

RussellSenior, 2023-06-02:
I'm a big fat dummy. READ THE DATASHEET. Page 2 of the SN75161 explains that TE and DC low force SRQ and DAV to receive mode. So, ++xdiag for those bits are going to give confusing results when connected through SN7616X chips.

Closed 2023-06-02.

Thread 39 (2023-06-04):

pinModes not consistent with state of SN7516X_TE and _DC?

RussellSenior, 2023-06-04:
There only seem to be a few instances of digitalWrite(SN7516X_DC, LOW or HIGH). And yet, according to the [SN75161 datasheet](https://www.ti.com/lit/gpn/sn75161b) on the second page's "SN75161B RECEIVE/TRANSMIT" function table, this is an important bit in setting the direction of the control lines through the chip to allow the appropriate handshaking. Furthermore, the pin directions set in the AR488_GPIBbus.cpp code seem inconsistent with the TE and DC levels set, according to the table.

RussellSenior, 2023-06-07:
Reading further, it seems that the SN7516X_DC is changing only on mode (controller vs device) changes, and that looks right. I am finding inconsistencies in input vs output control pins vs the function table when considering the state of DC and TE.

Twilight-Logic, 2023-06-11:
Russel, thank you for your comments.

Its a while since I looked at this but yes, DC gets switched on mode. Other switching gets done depending on whether data is being read or written to the bus or the controller being switched to idle state.

The datasheet does take a little fathoming, but if you have any specific examples of inconsistencies, then I will be happy to dig out my test rig and have a look.

RussellSenior, 2023-06-11:
See: https://github.com/Twilight-Logic/AR488/pull/38 for some pin direction inconsistencies and setting pins that should be inputs.

Twilight-Logic, 2023-12-21:
Russell,

Thanks for pointing that out. I initially merged your proposed changes without testing them, but then found that I couldn't talk to my HP34401A so I ended up reverting them. However, I did like the idea and spent some time thinking about it and adding in your changes a step at a time. As I started to analyse things and work through each section of code, it became evident that there were some bit switching inconsistencies as you point out. Your comments in the code were very helpful.
One thing I will mention is that the reason for setting input pins to 1 (HIGH) is to enable the internal pull-up resistors which is essential for proper operation. The inputs don't want to be set to 0 (LOW) which would put them in high-z mode and could leave them floating. I agree it does look a bit strange though at first sight. This is at least true for Arduino boards, but I am not sure about other boards such as the ESP32.
I have attached an updated version of the code which implements your idea, although the way I have implemented it is slightly different. I had the thought to separate functions according to the two distinct signal groups which are the a) control signals group (IFC, IFC, REN, SRQ) and b) the handshaking signals group (DAV,NDAC,NRFD,EOI). The former gets changed infrequently - usually when the operating mode of the interface is changed from controller to device and back, whereas the latter group changes with every character sent. If figured this added a bit more clarity. The operation is pretty much the same and hopefully achieves the same goal, i.e making the code easier to read and understand.
I would appreciate it if you have the opportunity to test the attached and let me have your feedback.
[AR488-0.51.25-test.zip](https://github.com/Twilight-Logic/AR488/files/13742109/AR488-0.51.25-test.zip)

Twilight-Logic, 2024-02-14:
I have now pushed up the latest revision of the code to the GitHub. This includes corrections for the inconsistencies you mentioned in your pull request.

Closed 2024-02-29.

Thread 41 (2023-11-04):

EOI signal mystery?

m0pub, 2023-11-04:
I'm sorry if this issue/question has already been posted, but I have been using my AR488 with an old Tektronix 'scope. With default AR488 settings it works well for sending and receiving 'standard' messages, such as *idn?.
However, I wanted to receive binary data which contains LF and CR characters, so I configured my AR488 to use EOI to signal the end of each message with "++eoi 1" and "++eos 3". But this stopped all communication from working.
Clearly the issue was with the EOI signal, and a quick look at the AR488 source code showed that the AR488 asserts EOI (for 40us) _after_ the last character of a message has been read and acknowledged by the device. I'm not an IEEE488 expert by any means, but I think that the standard says EOI will be asserted _during_ the last character of the message, rather than afterwards. The really strange thing is that the AR488 firmware has clearly been written to function as I would expect, but then modified to behave differently.
As soon as I changed the firmware to assert EOI during the last character of each message, everything starting working. Has anyone else encountered this, and is it a bug or a feature, please?
Best wishes to you all, Alan.

Twilight-Logic, 2023-11-07:
A;lan, thanks for reporting this. The EOI signal should be asserted during the last character. I will investigate.

m0pub, 2023-11-07:
Thank you very much for your response. Please don't hesitate to ask me if you need any more details.
Best wishes, Alan

Twilight-Logic, 2023-11-07:
Alan, I would be interested to know which versions you compared, and what change you made?
Also, which Tektronix scope were you working with?

m0pub, 2023-11-08:
I am using version 0.51.18, dated 26/02/2023. I have not compared with earlier versions, but GPIBbus::writeByte() takes a second parameter to indicate whether EOI should be asserted during that byte, and in the current firmware it is **always** set to 'NO_EOI'.

My changes were very simple:
1) In GPIBbus::sendData() I changed:
err = writeByte(data[i], NO_EOI);
to
err = writeByte(data[i], (i == (dsize-1)));
so that EOI is asserted during the last character of the message - see AR488_GPIBbus.cpp line 627
2) Also in GPIBbus::sendData() I removed the code to assert EOI for 40us after the last byte is sent - AR488_GPIBbus.cpp lines 666 to 674.

My 'scope is a Tektronix TDS640, and I needed to send binary data to it in order to backup the NVRAM contents. Incidentally, I note that I originally referred to _receiving_ binary data, but that was very ambiguous. I meant that the 'scope needs to receive binary data, and hence the AR488 needs to send it - sincere apologies for any confusion.

Twilight-Logic, 2023-11-08:
Thanks for the additional info. I need to investigate this further, but your changes make sense. My only concern is what happens if CR, LF or CRLF is also enabled. The EOI would need to be sent on either the CR or LF accordingly, so modify it further to make sure that EOI is always asserted on the last character regardless of the type of data being sent and the settings being used.

If I send you an update, would you be able to test it on you TDS640 please? I want to be sure that any update I release doesn't break anything. I can test receiving, but I don't have an instrument I can test sending data to.

m0pub, 2023-11-08:
Yes indeed, a similar change needs to be applied to the cases where a CR, LF or CR/LF message terminator is enabled. I haven't attempted that since it wasn't a requirement for me, but of course it is in the more general case.
I would be happy to test changes on my TDS640, although I do not know how it will respond if I add the extra message termination characters.
(Incidentally, my AR488 interface uses an ESP32 CPU. This is not relevant to the EOI issue, which is independent of CPU type, but I did need to make one or two other little changes before the firmware would even compile for the ESP32. Would you like me to open a separate issue for that?)

Twilight-Logic, 2023-12-21:
Alan,

After a couple of weeks of ilness and other issues I have finally found some time to have a look at this now that we are nearing the holiday period. I have attached the version I am working on which inludes you fix and some additional code to handle CR/LF if it happens to be used. Are you able to test this on your TDS640 please?

With regards to the ESP32, it has been on my todo list add this board to the list of those supported, so I am very much interested in the changes that you had to make. There is also already a forked ESP32 version available here as well:

https://sr.ht/~douardda/AR488-ESP/

This version has some additional functions which I am hoping to backport into my project. I was also intending to add some WiFi functions and will be enabled if an ESP32 board is detected.

Here is the current version of the code. There have been some substantial changes including the one requested by yourself so I would be most interested in your feedback.
[AR488-0.51.25-test.zip](https://github.com/Twilight-Logic/AR488/files/13741978/AR488-0.51.25-test.zip)

m0pub, 2023-12-22:
Thank you for your new version of the AR488 firmware. I'm looking forward to trying it, but it may be after Christmas before I have any news. I'm sorry to hear that you have been ill, but very pleased that you are better now.
Thanks again, and best wishes, Alan.

Twilight-Logic, 2023-12-24:
Alan, thank you for your feedback.

My attempt to compie fr the ESP32 actually came up with the same problems. I started by creating a custom profile as you did.

For item 1 I had to make the same edit.

For item 2 I just defined oct:

 ` char oct[4] = {'\0'};`

However, since the value of cnt has already served its purpose having been sent to output, the variable can indeed be re-used.

For item 3,  I also added an #ifdef clause for the ESP32 to include ESP.restart(). I note however the need to include the esp_task_wdt.h header.

I also ran into a problem with  the snprintf statement in the void id_h function in AR488.ino, line 2180. This contains a reference t the 'lu' formatting token which expects a long int variable. This had not surfaced previously when compiling for Arduino boards so I it would seem that the Uint-32 variable gpibBus.cfg.serial is equivalent to a an unsigned long int on an Ardiuino, but apparently not on an ESP32 despite this also supporting 32-bit values. I solved this by first assigning its value to an unsigned long int variable within the if statement that contains the snprintf command, and then changing the snprintf statement to refer to this new variable:

```
      if (strncasecmp(keyword, "serial", 6)==0) {
        unsigned long int serialnum = gpibBus.cfg.serial;
        memset(serialStr, '\0', 10);
        snprintf(serialStr, 10, "%09lu", serialnum);  // Max str length = 10-1 i.e 9 digits + null terminator
        dataPort.println(serialStr);
        return;
      }
```
After that it compiled without error or warning.

Thank you for taking the time to test with your TDS640.  I was able to test reading my DMMs, but not sending data from an oscillocope which involves sending much more data and using different functions, so it is good to know that this works as well.

m0pub, 2023-12-27:
Interesting - I didn't have any problem with the "%lu" format token when building for the ESP32. I have just checked, and your original code works fine for me without any change. This could be something to do with compiler options, but unfortunately I don't have time to investigate at the moment.
Best wishes, Alan

Twilight-Logic, 2024-02-14:
I have finally managed to push up the latest update which fixes the EOI issue.

The "%lu" issue seems to be down to the fact that a different compiler is used for some boards, e.g. ESP boards. It seemed to be fine for some boards and not others. I was able to find a common option that would work for any board I tried compiling for.

Closed 2024-02-29.

Thread 44 (2024-03-12):

Device mode custom commands etc.

FKW9, 2024-03-12:
I don't quite understand the current state of device mode.

Is it possible to use the arduino as a device with a specific IEEE488 address, so i can communicate with it without just forwarding the data to a serial port?
For example making write/read/query operations to the device over GPIB to e.g. return the state of a I/O?

Twilight-Logic, 2024-03-12:
May I ask what you would like to achieve? If the question is what  think it is, then you might be referring to secondary commands. The AR488 project is primarily designed to facilitate a USB connection to an older device with a GPIB interface. It therefore implements the  primary GPIB commands that are needed to, e.g. read measurements or remote control the device.

If you are looking for capability to run secondary addressing commands such as reading and writing files from a disk drive, then it is necessary to understand which device is to be interacted with. Although there are some common features, each vendor and device has its own implementation of a command set. The following project, is based on the AR488 code, emulates a Tektronix tape drive. The project adds an SD card reader to the Arduino and its main function is to allow the Tektronix computer to create/erase/read/write files to the SD card over the GPIB bus. In a similar way, if one has details of the command set, it ought to be possible to emulate other devices. For example, I had considered implementing an emulation of a Tektronix and a Commodore PET disk drive although, for the latter, emulator options already exist. The USB cable is used mainly for programming the Arduino, but also a handful of test commands which do return responses over serial, but other than that, no data or device commands are sent over serial. However, it could just as easily contain the full AR488 command set.

https://github.com/Twilight-Logic/Tek405xEmulator

So yet, it is possible to set the AR488 with a specific IEE488 address and communicate with it over the GPIB bus from another GPIB node or controller. However, in order to answer your question in more specifically, I would need to understand better what you are looking for.

FKW9, 2024-03-12:
Thanks for your detailed answer.

I'm using the Arduino MEGA with some external circuitry on a custom made PCB.
Since every instrument in my laboratory is connected via GPIB, I also wanted to control this custom made device with it so I don't have to change my software routines.

Therefore, I can't emulate a device, but I am building an entirely new device that could theoretically implement any command set I'd like (in addition to the standard GPIB interface functions).

The basic idea is that I connect it to my GPIB bus, send a query like `GPIOSTATe 10?` to the device address and get a response with the state of Arduino pin 10, e.g. `STATe LOW`. These custom commands must of course be implemented in the code.

I hope this makes my question a little clearer.

Twilight-Logic, 2024-03-13:
Thank you for the clarification. That's a bit like sending SCPI commands to an instrument. Yes, with a little bit of work it could be made to work. At the moment, in the AR488 code, data is just sent to the serial port because there is no defined device function. However, there is no reason why each received line could not, instead, be parsed for commands and parameters which then trigger routines to do something with GPIO pins and, if required, returning a result back to the requester via the GPIB bus. It would require writing a module that can be enabled in the config, one having a basic framework provided for someone to then add their own custom routines into. Its an interesting idea and I will have a think about how it could be implemented.

FKW9, 2024-05-23:
I tried to understand the source code but its pretty hard for me to implement/understand this functionality.
Controller mode works perfectly fine, but using device mode in listen-only and promiscuous mode raised some questions:

### ++prom mode
In ++prom mode, I do not see any data that is sent over the GPIB bus. For example, when I IDN a instrument on my bus on address 7 with my PC (NI PCIe-GPIB Controller), I get no output on the data port, only on the debug port:
```
AR488\AR488_GPIBbus.cpp:539 (receiveData) > Start listen ->
AR488\AR488_GPIBbus.cpp:540 (receiveData) > Before loop flags:
AR488\AR488_GPIBbus.cpp:541 (receiveData) > TRNb: 0
AR488\AR488_GPIBbus.cpp:542 (receiveData) > rEOI: 1

AR488\AR488_GPIBbus.cpp:599 (receiveData) > After loop flags:
AR488\AR488_GPIBbus.cpp:602 (receiveData) > Bytes read:  0
AR488\AR488_GPIBbus.cpp:603 (receiveData) > <- End listen.
AR488\AR488_GPIBbus.cpp:890 (setControls) > Set GPIB lines to idle state
AR488\AR488_GPIBbus.cpp:645 (receiveData) > done.
AR488\AR488_GPIBbus.cpp:877 (setControls) > Initialised GPIB listener mode
AR488\AR488.ino:541 (loop) > <- ATN loop finished
```
So it seems that in prom mode, the data cannot be received correctly?

### ++lon mode
In ++lon mode I see everything that is happening on the bus, despite what is written in the manual.
"_[...] lon mode works only with a Talk-Only node and where no controller is present on the GPIB bus, whereas prom mode can operate when a controller is present and addressing is used_"
This is weird because addressing **is** used and there **is** also a controller on the bus. Here is an example output from the AR488 data port while making a query operation with the GPIB Controller to a instrument with address 7:

QUERY:
ASCII: `@?'*IDN?\n`
HEX: `40 3f 27 2a 49 44 4e 3f 0a`

RESPONSE:
ASCII: `? Gmaturo gmbh,MCU,5170816,1.30\n`
HEX: `3f 20 47 6d 61 74 75 72 6f 20 67 6d 62 68 2c 4d 43 55 2c 35 31 37 30 38 31 36 2c 31 2e 33 30 0a`

I guess the first bytes are somehow related to addressing?
This looks more like a prom mode than a lon mode...?
___
Furthermore I tried to send data directly to the AR488 device (address 17) with my GPIB Controller.
Of course I will get a timeout, but the data from a query/write operation is received _somewhat_ correctly(?).
This is the serial output from the AR488 from a query and write operation in listen-only mode. Note that I do not get any debug information when using ++lon mode, despite having all debug defines uncommented.

ASCII: `@?1*IDN?\n? Q`
HEX: `40 3F 31 2A 49 44 4E 3F 0A 3F 20 51`

ASCII: `@?1TEST123\n`
HEX: `40 3F 31 54 45 53 54 31 32 33 0A`
___
When doing the same in ++prom mode, I get no serial output on the data port, but on the debug port I get the following:

QUERY: `*IDN?\n`

DEBUG OUTPUT ON AR488:
```
AR488\AR488.ino:539 (loop) > -> Attention signal detected
AR488\AR488_GPIBbus.cpp:901 (setControls) > Set GPIB lines to idle state
AR488\AR488_GPIBbus.cpp:901 (setControls) > Set GPIB lines to idle state
AR488\AR488_GPIBbus.cpp:539 (receiveData) > Start listen ->
AR488\AR488_GPIBbus.cpp:540 (receiveData) > Before loop flags:
AR488\AR488_GPIBbus.cpp:541 (receiveData) > TRNb: 0
AR488\AR488_GPIBbus.cpp:542 (receiveData) > rEOI: 1
<\r><\n>
AR488\AR488_GPIBbus.cpp:599 (receiveData) > After loop flags:
AR488\AR488_GPIBbus.cpp:602 (receiveData) > Bytes read:  0
AR488\AR488_GPIBbus.cpp:603 (receiveData) > <- End listen.
AR488\AR488_GPIBbus.cpp:890 (setControls) > Set GPIB lines to idle state
AR488\AR488_GPIBbus.cpp:645 (receiveData) > done.
AR488\AR488_GPIBbus.cpp:877 (setControls) > Initialised GPIB listener mode
AR488\AR488.ino:541 (loop) > <- ATN loop finished<\r><\n>
```

ANSWER ON PC:
```
Read Operation Error
VISA:  (Hex 0xBFFF0015) Timeout has expired before the operation is completed.
```

SCREENSHOT:
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

Again, in prom mode there seems to be an issue.
___
So, my current idea is to modify lon mode or implement a similar method:

1. check if the address matches our device address (set with ++addr cmd)
2. if the address is correct, parse the incoming data
3. if it is a query, prepare the bus and respond to the controller (_no clue how to do this yet_)

Have you thought about this idea any more?

Closed 2024-05-10.

Thread 45 (2024-05-09):

Escaped characters not being sent

Mike0Github, 2024-05-09:
I am getting incorrect characters when trying to read HP3478A calibration memory at locations 10 and 27.

I am writing Wxx\n (87,xx,10) to the AR488 where xx is the memory location from 0 to 255, for escaped characters I am writing (87,27,xx,10), but if xx is 10, 13, or 27 nothing is written to the bus.

Monitoring the GPIB bus with another AR488 it appears the numbers 10, 13 and 27 are not being sent on the bus even though they are escaped with 27 (0x1B).  Other numbers escaped with 27 get through to the bus.

Is this a firmware bug or am I doing something wrong?

Twilight-Logic, 2024-05-09:
Mike, thank you for your report. Which version of the firmware are you using?

Could you please confirm which version of the firmware you are using please? There was a problem with this is previous version but it was fixed in the latest version.

Mike0Github, 2024-05-09:
I'm using version 0.51.28

Mike0Github, 2024-05-09:
I will install version 0.51.29 tomorrow and let you know.

Mike0Github, 2024-05-09:
Tried it this morning.  Works perfectly now.
b.t.w. During earlier testing I found I had to set the HP3478A to "Stop Trigger" (send 'T4') else it would send voltage readings along with the calibration data.
Thanks for a great program.

Twilight-Logic, 2024-05-10:
Thank you for the feedback. Glad it is working now.

Closed 2024-05-10.

Thread 46 (2024-07-05):

REN pin always active?

mpictor, 2024-07-05:
Hi,

I thought I had a uno with blown pin 3 (REN), as it is always ~0v (active), but with another sketch (blink sketch, modified to use that pin) it cycles.

I tried another uno and a duemilanove (which also uses the atmega328p) - on both, the pin works with a test sketch but doesn't seem to work with the AR488 sketch uploaded.

None of the following change the state of that pin:
* `++xdiag 1 32`  (assert REN)
* `++xdiag 1 255` (assert all)
* `++xdiag 1 0` (assert none)

The latter two do change the state of other pins.

`++mode` reports 1, so it should be in controller mode.

Is it to be expected that the pin is not driven high? The documentation of `xdiag` makes it sound like it should change state, same as other pins...

I'm using rev ae02a638c (Mar 18), which looks to still be HEAD.

mpictor, 2024-07-23:
any thoughts @Twilight-Logic ?

Twilight-Logic, 2024-07-23:
At this time I am not sure but I will check it out. AFAIK, it should change state. It will stay low when in controller mode, but it should change for 10 sec when running xdiag.

mpictor, 2024-07-26:
Ah, sounds like it wouldn't be negatively affecting me even if it _was_ malfunctioning.

I fiddled some more and got it talking to one of the 3 devices I have that support gpib, a HP 3582A.

I'd left pin 24 (logic gnd) disconnected, thinking it'd be connected to the other grounds; apparently that is untrue.

The device I most want to use with gpib (Tek 7912AD) seems to require a secondary address; I see in the documentation that this is not implemented. Do you have any idea how much work is required to get that going?

Twilight-Logic, 2024-07-26:
I haven't had a chance to have a look at the REN issue yet. I need to set up my LA and a UNO and try it out. Only got as fart as getting the LA out so far....

With regards to secondary addressing, I will need to study the Interfacing manual a bit more in order to be able to answer. Generally, the primary address is used do identify the instrument on the GPIB bus, whereas the secondary address is used to send commands. The command set is specific to the instrument. For example, last year I completed a collaboration project for the Tektronix 4924, which is a tape drive designed for the Tektronix 4050 Series computer. The tape drive uses secondary address codes as commands to control the tape and read and write files. In the case of that project it was the AR488 interface board that emulated the tape drive and received the secondary address over GPIB from the instrument and then did something with it, for example saving a file to an SD card.

From a quick skim read of the Interfacing guide I see that the secondary address on the 7912AD is used in a similar way but there are differences. For example, the instrument uses the secondary address plus the next two addresses in sequence to determine whether a command is being sent to the mainframe, the channel A plugin or the channel B plugin. It looks like it requires a sequence consisting of PRI, SEC, "some command string", to be sent, where PRI is the primary address of the instrument on the bus, SEC is the secondary address, i.e. the mainframe or +1 for the channel A plugin or +2 for the channel B plugin, and the string contains the command for the addressed component to execute. However, in this case, the roles are reversed. The instrument receives the secondary address and command sequence and does something with it. The AR488 would need to commanded via serial and forward the instrument command string to the instrument.

The Interfacing manual contains examples using Tek 4050 BASIC. In this case, BASIC composes and sends the required sequence of bytes to the instrument and interprets the response. However, if you don't happen to have a Tek 4050 series computer to hand (do you?), then a method of emulating Tek BASIC will be needed. That could be done easily enough using, for example Python, or some other scripting language that can access the serial port. However, what would still be needed is for the AR488 to 'know' when it is being provided with a secondary address. Crucially, this has to be sent as a byte following the primary address byte while ATN is still asserted rather than subsequently when the instrument command string would be sent. What might be needed is to provide a means for setting that secondary address, perhaps like perhaps +addr 3,1. If the second parameter is provided, the controller would interpret is as a secondary address to be sent after the primary address. Following that, the instrument command sequence is sent. If necessary the response is retrieved with a ++read command. The calling program then interprets what it has received based on what the programmer was expecting. If no secondary address is provided, the controller just assumes it is sending to the primary address. The only difference here is that the primary address only needs to be set once. The primary,secondary address combination will need to be sent every time an instrument command is sent, e.g:

```
++addr 10,0
DIG DAT;READ PTR, VER
```
This would be equivalent to the Tek basic command:

`PRINT @10,0: "DIG DAT;READ PTR,VER"
`
In the above statement, 10 is the primary address and 0 is the secondary address.
Conversely, the equivalent of this sequence:

```
PRINT @10,0:"VS1?"
INPUT @10,0:VS1$
```

would be:

```
++addr 10,0
VS1?
++read
```

The result of ++read would be read from serial into a variable.

Not sure whether it is quite as simple as that, but it sounds like it might be feasible. Since you have the instrument, would you be willing to test if I set something like that up?

mpictor, 2024-07-26:
I'd be happy to test it for you, thanks!

Speaking of REN, I'd meant to see if I could find an arduino emulator and see if it showed activity on that pin. If it does, I have 3 arduinos with the same bad pin...

mpictor, 2024-07-27:
One caveat on testing: when I hook the 7912 to a scope in x-y mode it doesn't behave as I'd expect. I hope that GPIB will allow me to narrow down the issue(s), though it's also possible said issue(s) will interfere with proper GPIB function and thus with testing the updated AR488 code.

Tekwiki has incomplete documentation on these digitizers, so any in-depth troubleshooting will get interesting.

Twilight-Logic, 2024-07-27:
Mark, I tested the ++xdiag function this morning but couldn't replicate the problem in the same way. I had the AR488 connected to the logic analyser and no other device connected to the GPIB bus.

The first thing I noticed on my UNO was that in controller mode, both REN and SRQ are low,
In device mode all pins are high as expected.

Now, in controller mode, REN is supposed to be LOW. This is so that in controller mode, devices can be remote controlled. As soon as one drops unasserts REN, all devices on the bus return to local mode. To be fair, I am not certain whether it should be idle on startup and asserted when a remote command is issued and then perhaps cleared on ++loc. However, it shouldn't cause any problem with remote control.

On the other hand, SRQ should be idle (HIGH).

However, ++xdiag 1 0 does pull all the pins up HIGH and ++xdiag 1 255 does pull them all low. So I am baffled as to why SRQ goes LOW in controller mode. It is evidently capable of being pulled up HIGH. Your thought about the pull-up is an interesting one, but you did say the problem occurred on more than one board? A similar thought occurred to me as well regarding this SRQ problem, but since I can see on the LA that ++xdiag 1 255 pulls them all up, that is not the issue in my case, so something for me to investigate further.

On the secondary addressing front, I have made some progress, but then realised that my approach was going to be a little more complicated than first envisioned. I think I need to change my approach somewhat and am still considering the options.

Twilight-Logic, 2024-07-27:
I have attached a test version for you to try secondary addressing. To send a command use the command as follows:

```++sendsec 1,0,COMMAND TO SEND
```
where the first parameter is the primary address, the second the secondary address, and the third is the command sequence. No idea whether this is going to work, but I am hoping you get some response.

There is still much more to do as it looks like there is a needs to send individual bytes which will likely require a separate routine.

Let me know what happens.

[AR488_test_SA01.zip](https://github.com/user-attachments/files/16400772/AR488_test_SA01.zip)

mpictor, 2024-07-27:
> Your thought about the pull-up is an interesting one, but you did say the problem occurred on more than one board? You did also say it worked OK with another sketch?

Yes, 3 different boards. I believe all 3 came from an estate I helped clean up, in which case they _could_ all be damaged similarly (without me knowing), though it seems unlikely.

With a sketch I was only testing high/low, not low vs pullup. Rise and fall time appeared the same on different pins; I assume a damaged transistor would show up as slower rise time, and of course if sufficiently damaged no rise at all :)

Part of your comment references SRQ rather than REN - did you mean REN throughout?

mpictor, 2024-07-27:
with any sendsec command (e.g. `++sendsec 4,5,READ VER`), I get a response of `Sent!`
I've not seen any response from the instrument for any sendsec command. That said, I don't have a display attached and I think some front panel indicators need replaced.

`++llo` turns on the unit's lockout indicator, regardless of the address set by `++addr`. (contrary to the ar488 docs - ?!)
`++loc` does nothing
`++ loc all` turns off the lockout indicator

Twilight-Logic, 2024-07-28:
Did you try following up READ VER with a ++read command? The 'Sent!' is there to indicate that the function completed and didn't jump out at any of the return statements associated with an error.

Interesting note regarding ++llo. Need to look into that.

mpictor, 2024-07-30:
I'd set `++auto 1` prior to the sendsec command.

I also tried with `++auto 0` and issuing `++read` after; there was no difference.

prologix examples I see online (eevblog, etc) require that 96 be added to the secondary address. Are you doing that internally or should I add it myself? If the latter, I believe there's a bounds check getting in the way: `++sendsec 4,101, ...` results in an `Unrecognized command` response that I don't get for SAD values < 32.

I'm a little confused why you added another command, `sendsec`, _and_  changed `addr` to accept an optional SAD.

Is `++addr PAD SAD` usable, or is SAD just discarded?  As with sendsec, SAD >= 32 results in an error.

mpictor, 2024-07-31:
Interesting, I didn't realize talk/listen required different addresses. Explains the table I saw in an HP manual which had both. Though it also showed the default address as `+K`, IIRC (presumably ASCII for the talk and listen addresses)... :dizzy_face:

Regarding `++addr`, I failed to mention my main points: that it'd be good to retain compatibility with prologix, and otherwise a lot of other commands need re-implemented.
For example, `++clr` uses the address set via ++addr. How would I send it using ++sendsec? Or do commands like that only operate with primary addresses?

----

With the updated sketch, I'm still not having any luck. I can send to 101 without error but still get no response.

Even though `+llo` turns on the lockout indicator, other front panel buttons function. So I'm thinking this 7912 is suspect enough that additional fiddling is pointless without a logic analyzer. Either I cobble one together, or transport the digitizer to the local makerspace. Effort either way, yaaaaay.

Thanks for the help, and I'll update you when I know more.

Twilight-Logic, 2024-07-31:
The details of the original GPIB design are explained here:

https://www.hp9845.net/9845/tutorials/hpib/

I do intend to retain compatibility with the Prologix interface so the ++addr command will be retained. I was only going to remove the bits I added to support ++addr P,S. I will just leave support for ++addr P as previously. You are correct that commands like ++clr, ++loc and ++llo operate on primary addresses.

Can I ask for a link to the HP manual you mention please? If its in a BASIC program statement then it may just be a variable, but I am also curious about that +K reference.

I wouldn't necessarily consider the 7912 suspect. We are rather working a bit in the dark here. I don't have a 7912 instrument here to test with and having a logic analyser to view what is happening on the GPIB bus would be useful for sure. If you are familiar with Sigrok, then Artag's GPIB sniffer board here makes it easy to connect up to the GPIB bus:

https://oshpark.com/profiles/artag

It is relatively cheap and easy to build as well. Of course, there are a large number of options.

If ++llo turns on the lockout indicator that would at least seem to indicate that at least primary addressing is working as the instrument is receiving the command. Of course ++loc should turn it back off again so I tested that on my Agilent 34401 meter. Running ++llo lit up the  'Rmt' indicator and locked for the front panel and both '++loc' and '++loc all' turned it off again and released the front panel again. It does appear to be working as it is supposed to do. I would expect the 7912 to respond in the same way, however I am not familiar with it and need to find a bit more time to study the manuals, which will be difficult to find this week. Things should be a bit quieter next week.

Looking at some of the examples in the interfacing guide, it would seem that each time you 'PRINT' a command, there is a corresponding INPUT or READ command with secondary addressing to obtain the response. It may be that the ++read command needs to be updated to take into account the secondary address as well. Of course it would be useful to confirm proper operation of primary addressing first.

mpictor, 2024-07-31:
The manual mentioning `+K` is the operating manual for the 3582A.  It can be seen [at archive.org](https://archive.org/details/hp_3582a_manual/page/n25/mode/2up). The default address is mentioned in paragraph 2-33 (pdf pg 27) and the table is on the next page.

Twilight-Logic, 2024-08-01:
Thanks. That's a bit of a weird way that HP have referred to it in that manual. So if you look at the table over the page, you can see that listen + and talk K refer to the same row of the table corresponding to an address setting of 01011 which is binary for 11 decimal, or 0B hex.  Now if you look at an ASCII table for the characters, you will see that the character + is ASCII code 53 or hex 2B, and K is 113 or 4B in hex. So the switch is set to hex 0B with hex 20 or hex 40 being added depending on whether the instrument is being addressed to talk or to listen. So you would set the switches to 01011 and use decimal address 53 for a listening (INPUT, RBYTE) command or 113 for a talk (PRINT, WBYTE) command.

Interesting to note that here we have another instrument that uses a secondary address.

Twilight-Logic, 2025-03-20:
I have been working on  couple of other things , one of which has involved secondary addressing. Some changes have had to be made to the GPIB back-end code. In addition I removed the previous experimental functions and added two new, written from scratch functions called ++secread and ++secsend. These have been reported to work so hopefully should now work with your 7912AD. This is the latest development version.

As before the send function is called with:

` ++secsend pri,sec,data`

The read function just needs the addresses:

`++secread pri,sec`

It is also possible to do the same thing with single commands:

```
++unt
++unl
++addr pri,sec
++read
```

or instead of read, send something to the instrument.

I am currently working in added a 'Find listeners' function. This is called with:

Single or multiple addresses:
++fndl addr, addr, addr etc

Range of addresses:
++fndl begin-end

Complete range from 0 to 30:
++fndl all

It should return all listeners on the bus, including extended addresses. The function is still being worked on and the extended address (pri,sec combination) results may not be accurate.

The ++xdiag function has also been enhanced to show the diagnostic or current pin state in the serial terminal.

To show the current pin state:

`++xdiag pins`

The other options work the same way.

I am still considering how to handle REN.

[AR488-fndl-0317.zip](https://github.com/user-attachments/files/19362888/AR488-fndl-0317.zip)

mpictor, 2025-04-27:
Awesome! I had poked at the code a bit off and on, without a breakthrough. I was just coming back to this and noticed you'd added functionality. Hopefully it works - I'll keep you posted.

BTW, would you be interested in a Makefile, for use with `arduinoMakefile`? You still need arduino installed, but it lets you skip the ide. You can compile/upload from the command line with something like `MONITOR_PORT=/dev/ttyACM3 make upload`. I've only tested on linux, but assume it also works on windows and osx.

If you are interested let me know and I can create a PR.

Twilight-Logic, 2025-05-21:
> BTW, would you be interested in a Makefile, for use with `arduinoMakefile`? You still need the arduino ide installed, but it lets you skip _running_ the ide. You can compile/upload from the command line with something like `MONITOR_PORT=/dev/ttyACM3 make upload`. I've only tested on linux, but assume it also works on windows and osx.
>
> If you are interested let me know and I can create a PR.

That sounds interesting. I would be happy to have look and experiment with that. I am also thinking of creating a PlatfromIO project config for it at some point, but keeping the original Arduino IDE format as well.

> I'm able to address it now, so it's happy with how you are doing secondary addressing.

That's good to hear.

> Still having some issues, though at least some are due to me not understanding how it responds in particular cases - for example, if you try to read and it has nothing to say, it responds with `0xff`.

Hmm, might need to have a look at that. The interface shouldn't be sending anything if the instrument has nothing to send.

> When you use it, do you insert delays in whatever program is controlling it? For stability, I found I needed to insert delays between writes.
>
> I'm not sure you can do much about this, given the constraints of the atmega, but it may be worth documenting (unless it is already and I missed it).

That's a fair point. I recently added a ++flags command which allows a script to wait and check that the 'flag' (defined sequence of characters) has been received before sending the next command. Not sure whether that would help in this case but might be worth a try, but otherwise, with chips like the CH340 in the absence of handshaking, fudging it with delays is the only other option.

mpictor, 2025-05-27:
Ok, I'll put together a PR. Fortunately this won't be impacted by the re-formatting issue I mention below.

> The interface shouldn't be sending anything if the instrument has nothing to send.

This isn't the AR488's doing. The ops manual just got scanned and notes this behavior.

From page 3-16 of the ops manual, available on tekwiki's [7912AD page](https://w140.com/tekwiki/wiki/7912AD):
> ... If the 7912AD has no message to send when it is talked, it responds with a single data byte, hex value FF -- all data lines asserted, along with EOI.

One other note:
Have you considered using a code pretty-printer? When I was poking at the code, vscode was absolutely _determined_ to reformat all the C/C++ no matter what I did to turn off its auto-formatting. If I'd wanted to submit a patch, either it would have been a garbled mess or I would have had to re-create the patch in a different editor. VSCode re-word-wrapped everything, "fixed" spacing, replaced all tabs, etc etc.

Using a pretty-printer wouldn't fix everything unless its settings agreed exactly with vscode, but chances are it'd clean up a number of the things vscode felt it must change.

(This reminds me, I should try to reproduce and file a bug against vscode)

mpictor, 2025-05-28:
The Makefile PR is up now - #63

We've gone far beyond the original scope of this issue, so I think I'll close this.

Closed 2025-05-28.

Thread 47 (2024-09-23):

Timeouts on NDAC, DAV and debug code out of sync

PelNet, 2024-09-23:
Hey there! First of all, nice work on a simple rudimentary GPIB implementation at next to no cost!

Unfortunately, I'm hitting a bit of a snag. First, the main problem; I'm running an (authentic) Arduino Uno and loaded the firmware. As per the ++xdiag command, I've tested all the control lines with a logic analyzer and that's fine. I can also assert the REN line and the target device stops responding to local input as expected.

    the firmware version number

Latest from the repository.

    the type of board being used

Arduino Uno R3, authentic, no modifications or other peripherals.

    the make and model of instrument you are trying to control

Two tested, a Tektronix 2430 (non-A) and an HP 54600A.

    a description of the issue including;
    what steps are required to reproduce the issue

First issue is that I cannot get a single command to 'go through'. Unfortunately, I have no other adapter for reference, but I'm fairly confident that at least one of the two instruments has a working GPIB interface. Here's what I typically run into when sending a command:

```
16:13:35.005 -> > ++addr
16:13:37.740 -> 1
16:13:37.740 -> > ++auto
16:13:42.516 -> 1
16:13:42.516 -> > ++mode
16:13:47.491 -> 1
16:13:47.491 -> > CH1 VOLTS: 5
16:13:54.786 -> Received for sending: 43 48 31 20 56 4F 4C 54 53 3A 20 35
16:13:54.786 -> AR488_GPIBbus.cpp:832 (setControls) > Set GPIB lines for sending a command
16:13:56.011 -> AR488_GPIBbus.cpp:1201 (writeByte) > NDAC LO timeout!
16:13:56.011 -> AR488_GPIBbus.cpp:488 (sendCmd) > Failed to send command 3F to device 1
16:13:56.011 -> AR488_GPIBbus.cpp:857 (setControls) > Set GPIB lines for writing data
16:13:56.011 -> AR488_GPIBbus.cpp:684 (sendData) > write data mode is set.
16:13:56.011 -> AR488_GPIBbus.cpp:685 (sendData) > Begin send loop ->
16:13:57.208 -> AR488_GPIBbus.cpp:1201 (writeByte) > NDAC LO timeout!
16:13:57.240 -> CAR488_GPIBbus.cpp:715 (sendData) > <- End of send loop.
16:13:57.240 -> AR488_GPIBbus.cpp:820 (setControls) > Set GPIB lines to idle state
16:13:57.240 -> AR488_GPIBbus.cpp:753 (sendData) > done.
16:13:57.240 -> AR488_GPIBbus.cpp:832 (setControls) > Set GPIB lines for sending a command
16:13:58.435 -> AR488_GPIBbus.cpp:1201 (writeByte) > NDAC LO timeout!
16:13:58.435 -> AR488_GPIBbus.cpp:488 (sendCmd) > Failed to send command 3F to device 1
16:13:58.468 -> AR488.ino:876 (sendToInstrument) > done.
16:13:58.468 -> > AR488_GPIBbus.cpp:1201 (writeByte) > NDAC LO timeout!
16:13:59.663 -> AR488_GPIBbus.cpp:488 (sendCmd) > Failed to send command 3F to device 1
16:13:59.663 -> AR488_GPIBbus.cpp:523 (receiveData) > Failed to address device to talk: 1
16:13:59.663 -> AR488_GPIBbus.cpp:845 (setControls) > Set GPIB lines for reading data
16:13:59.663 -> AR488_GPIBbus.cpp:539 (receiveData) > Start listen ->
16:13:59.663 -> AR488_GPIBbus.cpp:540 (receiveData) > Before loop flags:
16:13:59.696 -> AR488_GPIBbus.cpp:541 (receiveData) > TRNb: 0
16:13:59.696 -> AR488_GPIBbus.cpp:542 (receiveData) > rEOI: 1
16:14:00.886 -> AR488_GPIBbus.cpp:1101 (readByte) > Handshake error!
16:14:00.886 ->
16:14:00.886 -> AR488_GPIBbus.cpp:600 (receiveData) > After loop flags:
16:14:00.886 -> AR488_GPIBbus.cpp:602 (receiveData) > TMO:
16:14:00.917 -> AR488_GPIBbus.cpp:603 (receiveData) > Bytes read:  0
16:14:00.917 -> AR488_GPIBbus.cpp:604 (receiveData) > <- End listen.
16:14:00.917 -> AR488_GPIBbus.cpp:619 (receiveData) > Timeout waiting for sender!
16:14:00.917 -> AR488_GPIBbus.cpp:620 (receiveData) > Timeout waiting for transfer to complete!
16:14:00.917 -> AR488_GPIBbus.cpp:832 (setControls) > Set GPIB lines for sending a command
16:14:02.112 -> AR488_GPIBbus.cpp:1201 (writeByte) > NDAC LO timeout!
16:14:02.144 -> AR488_GPIBbus.cpp:488 (sendCmd) > Failed to send command 3F to device 1
16:14:02.144 -> AR488_GPIBbus.cpp:630 (receiveData) > Failed to untalk bus
16:14:02.144 -> AR488_GPIBbus.cpp:820 (setControls) > Set GPIB lines to idle state
16:14:02.144 -> AR488_GPIBbus.cpp:646 (receiveData) > done.
16:14:02.144 -> Error while receiving data.
```

As you can see, I've enabled some debug options in the config. A little note on these, some are broken in their current state in the repo. See this for example (there are a few scattered through the files). I'll make a fork and PR soon:

```   } else {
-    DB_PRINT(F("Handshake error!"));
+    DB_PRINT(F("Handshake error!"), "");
   }
```

Anyhow, a few of those minor fixes got *most* of the debug working. I'm using the Tektronix as my main target as it provides more feedback (LED's above the screen for LOCK, SRQ and ADDR) and has configuration options the HP does not offer (like the format of responses, EOI with and without LF and so on. The HP basically allows you to set the bus address and choose between Printer, Plotter and Computer as the 'other device'. Printer and Plotter would be Listeners, so obviously I'm using Computer, but the response is the same.

If I manually modify the code or draw the NDAC pin low, it will fail at the next step, so the communication simply isn't working at all. Apart from the REN line disabling local input, I can't get anything to work. I've double and triple checked the pinout, hardware and so on. As mentioned, ++xdiag pulls the pins up and down as intended and I can witness this when connecting to the scope(s). I would like to add that I'm fairly tech savvy, also including low level TTL communication and so on but have no practical experience with GPIB. Any clues or suggestions? :-)

PelNet, 2024-09-23:
Another question - less important - is why the addressing runs from 1-30, whereas GPIB supports address 0? I wondered whether this might be an offset issue but I tried 'shifting' and it made no difference.

Twilight-Logic, 2024-09-24:
Thanks for reporting the issues you are having.

With regards to the addressing, it follows the Prologix which ran from 0 to 30, although 0-31 could actually be used. Address 0 is reserved for the controller and cannot be used to talk to a device. Again, the controller could use any primary address. I had thought about implementing a feature to change the controller address, in which case address 0 could be used, but never got around to it.

I can only apologise for the debug statement errors and will get them fixed.

Can I ask whether the interface was disconnected from the bus when you ran the ++xdiag command?

Just to rule out a physical connection issue, can I also ask whatever your connection method between UNO R3 and instrument, whether ground is connected at each end of the cable?

I note that the 2340 uses EOI and LF as a termination character so a CRLF may confuse it. You may need to set:

++eoi 1
++eos 2

A quick review of the HP54600A documentation indicates that it needs to be set in addressable mode via a switch at the back and then reset (first toggle set in the down position then reset pressed or the instrument power cycled). Both carriage return and linefeed are considered terminators, so it shouldn't have a problem communicating with the default CRLF terminator.
In talk mode the instrument will only send you data and the interface would need to be set to listen only mode with:
++lon 1
in order to receive it. Addressing would then be ignored.

PelNet, 2024-09-24:
Hey, thanks for getting back to me here! No worries about the addressing, I'll be dealing with about three instruments tops, and likely never sharing the bus between them, so for my use cases that's fine. I was just a little confused due to not being very familiar with the protocol in the practical sense. Meanwhile I've delved further in the whitepapers and protocol spec. RTFM for the win, hehe.

> I can only apologise for the debug statement errors and will get them fixed.

No worries, I'll let you have a crack at that, as I'm not entirely sure what happened with the handshake debugging - some states seem to have been replaced. Perhaps it would be a good time to mention that I managed to get the Tektronix working and the bus behavior consistent!

> Can I ask whether the interface was disconnected from the bus when you ran the ++xdiag command?

No, this was with the Tektronix scope connected as I was attempting to analyze the handshake and determine the cause of the fault. After upgrading the IDE and switching out the board, operations seem to work correctly. I incidentally checked the original board and using simple "blink" style sketches it operated fine. I circled back to the board and was unable to reproduce the problem, so I can only assume that the IDE or bundled avrdude compiler somehow interfered there. Left me a bit confused, but OK. I should have mentioned the version of the IDE I was using, which was just north of 2.0.

>Just to rule out a physical connection issue, can I also ask whatever your connection method between UNO R3 and instrument, whether ground is connected at each end of the cable?

Yup, all grounds including pin #12 for the shield were tied to a single common ground. This works just fine now. :smile:

> I note that the 2340 uses EOI and LF as a termination character so a CRLF may confuse it. You may need to set:

According to the documentation it will ALWAYS honor the EOI, and will optionally (if configured to do so) honor an LF.

Thanks for those pointers on the HP! I'm literally in the process of trying to get that to work. Currently I'm a little stuck on a 'Query unterminated' error which pops up on screen so I think the EOS and EOI may need a little tweaking. I think I'll get it sorted fairly quickly, now that I know the controller is operating correctly and I can make some (semi) educated guesses.

Thanks again!

I guess you can add these two devices to the 'known compatible' list and close the issue if desired. If you like, I can also drop a line here when I've confirmed the HP is working correctly.

PelNet, 2024-09-24:
Update: Yup, I've got the HP working. This is using an HP 54650A HP-IB interface module, no DIP switches or any other configuration on the module or rear panel. Setup is done from the scope itself where you can select a bus address, whether to transmit factors, the resolution and whether the remote end is a Computer, Plotter or Printer. I'm guessing the Plotter option outputs HPGL, the Printer option does raw PCL.

I also have an HP 54645D with the RS-232/Parallel interface for which I've written a nifty little Python CLI and GUI app which receives the PCL data and converts it to a PDF or PNG, saves a copy, automatically previews it on screen, etc.

The main reason I've been looking to get GPIB working on the Tek and this 54600 is because I would like to be able to save captures from them, too.

TL;DR: All sorted, working. Thanks a bunch!

Twilight-Logic, 2024-09-24:
I am glad you got it sorted and working!

That's an interesting note about early versions of IDE2.0.x. I was aware that there were some issues such as with the serial console and the odd IDE glitch, but none that I am aware of affecting the compilation of code. Yet since you were able to cycle back to the original board after upgrading the IDE and recompiling the code, that would seem to suggest possible problems with the early releases.

One of the problems with adding debug messages is that they take time to print to serial which can affect the timing of the handshake process. I have made an effort to place debug messages outside of reading and writing loops, but there may be more work to do to improve the process.

I must admit I hadn't though about maintaining a list of compatible devices. Maybe I should!

PelNet, 2024-09-24:
Yup, that was a bit of a pain as I didn't have a working system for reference, hehe. The ironic part being that I could analyze the handshake and digital I/O using the 54645D and even snag that data to the computer using a nullmodem cable and my little tool. I'm on Linux, FWIW, using the Arduino IDE(s) from their site, not a distribution packaged version or anything like that. System in use here was an Intel running Ubuntu 22 LTS.

It would be nice to see the debug working as it is actually very handy.

The HP didn't actually require any special configuration but actually displays semi-helpful messages on screen when GPIB communication failures occur. "Unterminated query" or "Header missing", that sort of stuff. I'm not an expert on these matters as you've noticed, but from what I'm seeing I think an 'incompatibility list' might make more sense. After also having read the extensive thread on the EEVblog, I think this controller should be capable of most 1:1 instrument interaction as far as the basic command sets are concerned. Are there things that you think *might* be problematic on the scopes I've got? If so, I'll gladly put it through its' paces and see what I come up with.

I think I may extend that tool to be able to flip the controller into device mode and then receive and process the data from a 'screenshot' or 'print job' as it does when simply using a serial interface.

PelNet, 2024-09-25:
Right, I've implemented the 'startup command sequence' in my utility and referred back to this tool in the README.

https://github.com/PelNet/pcl-dump

Unless you wish to keep this issue open for addressing the debug functionality, I'm fine with it being closed.

Thanks again!

Twilight-Logic, 2024-09-26:
Thank you for the feedback. Nice tool for capturing the PCL dump. No problem with referring back to the AR488 project.

I will keep this open for now as a reminder to self to review the debug messages.

Twilight-Logic, 2025-04-08:
Debug messages reviewed and hopefully all now fixed in the latest release - 0.53.03.

Closed 2025-04-08.

Thread 48 (2024-10-22):

Speed of data transfer from 488 bus to USB serial port

softfoot, 2024-10-22:
I am having a bit of a problem with a fast device causing what I suspect is overruns.
The windows app is written in FreeBasic.
I notice that data is being sent up over the USB one byte at a time making the Basic code "thrash".
Is there a way around this??
TIA,
Dave

Twilight-Logic, 2024-10-24:
Which board are you using and what UART chip does it have? Some UARTs (e.g. CH340/CH341) do not have any means of flow control which might be the source of the problem.

Twilight-Logic, 2025-07-17:
Closed because no further information has been supplied.

Thread 49 (2025-02-16):

Has anybody successfully interfaced RA488 + HP 7475A HP-IB Plotter

redruM0381, 2025-02-16:
Built a RA488 today w/ Mega 2560.  After configuring controller mode, I can send individual commands, such as SP1; SP2; etc. to my plotter, and it responds accordingly.  But if I try to send more, such as an HPGL file, it stalls, and errors out on the plotter side.  Plotter is in listen mode, but I have tried an address also.

I suspect it's a buffer overflow, but I can't for the life of me figure out the combination of configuration that it likes.

Any suggestions?

Twilight-Logic, 2025-02-16:
That does sound like it. Which board are you using for your build please?

redruM0381, 2025-02-16:
The board is a Mega 2560, probably a clone.   Do you maybe suspect a fake USB/serial bridge chip?  I noticed I am unable to use CTS, which others  recommend with the Prologix unit...

I could try a genuine FTDI bridge, and tie it into one of the other serial ports.

Twilight-Logic, 2025-02-17:
Many clone boards use the Chinese CH340 UART chip, which as you noticed, does not implement RTS/CTS handshaking signals. These signals are exposed on a couple of its pins but generally are left unconnected. This means that serial throughput is not controlled, leading to serial buffer overruns. As a result, data is lost during transmission which is obviously undesirable. The FTDI FT232RL does implement serial handshaking on the chip so this should hopefully work correctly. Let me know how you get on with the FTDI bridge.

redruM0381, 2025-02-17:
Tried today w/ a SH-U09F bridge (genuine FTDI chip) on the TX0/RX0 pins of my Mega.  Results are the same.  If CTS is enabled, TX turns red in my terminal, and I am unable to transmit anything.  With CTS off, I can communicate, but still run into major buffer issues.

tpolecat, 2025-03-15:
I was messing with this today and found that there are three main issues, none of which are AR488's fault. I fixed them by shameless hacking but one could certainly do it elegantly.

1. Plotter commands can take an arbitrary amount of time to complete, which can result in an NDAC HI timout if `cfg.rtmo` isn't set high enough. When this happens commands continue to be sent, but the plotter is in a bad state and will have missed some steps. Setting this with `++read_tmo_ms` didn't seem to work so I just hardcoded it to 10000 (10 seconds).
2. The UART buffer can fill up (as mentioned above) which will cause commands to be missed. A solution to this is to do some simple handshaking, which I did by just turning on debug output and waiting for `(sendToInstrument) > done` before sending the next command. I'm sending commands one at a time.
3. When first connecting via serial it can take a few seconds to initialize, so I handled this by waiting for `> Initialised GPIB control mode` before sending my first command.

Anyway, with these things in mind you can send commands as fast as the plotter can handle them. Hope this helps.

Twilight-Logic, 2025-03-15:
Oh, that is interesting. All that '++read_tmo_ms' does is set the value of variable as defined in the struct at the beginning of AR488_GPIBbus.h (line 148). cfg.rtmo is a reference to  rtmo

tpolecat, 2025-03-15:
Hi, thanks for the quick response! This is great project.

> Connecting to serial causes a UNO or Mega 2560 board to reset

Aha, this must be why the `++read_tmo_ms` wasn't sticking. I was switching between the IDE serial monitor and a Scala program I was using to compute the stream of plotter commands. I will track this down … I'm confident that it's working correctly on your end.

I hardcoded the 10 seconds at the third line of `GPIBbus::writeByte` … the plotter doesn't acknowledge the last byte of the command until it's finished executing, so it stays in `RECEIVER_ACCEPTING` too long and times out.

I will see if I can add commands to enable saying hello and indicating send complete. If it works I'll send you a PR.

Twilight-Logic, 2025-03-15:
> Hi, thanks for the quick response! This is great project.

Glad you like the project. Thank you for your support.

> > Connecting to serial causes a UNO or Mega 2560 board to reset
>
> Aha, this must be why the `++read_tmo_ms` wasn't sticking. I was switching between the IDE serial monitor and a Scala program I was using to compute the stream of plotter commands. I will track this down … I'm confident that it's working correctly on your end.

Yes, that might explain it. The setting should hold within the current  session though.

> I hardcoded the 10 seconds at the third line of `GPIBbus::writeByte` … the plotter doesn't acknowledge the last byte of the command until it's finished executing, so it stays in `RECEIVER_ACCEPTING` too long and times out.

Well that might certainly explain the timeout. I figured that you probably modified it on that line, either there or in the while loop condition. Was just curious which. Looking at that, `timeval` probably does not need to be declared. The loop condition could just refer to `cfg.rtmo`.

> I will see if I can add commands to enable saying hello and indicating send complete. If it works I'll send you a PR.

Funnily enough I have just been playing with your idea as well and added a ++flags command. For now, it adds 3 flags - AR488~RDY, Read^OK and Sent^OK which can be individually turned on or off as required.

tpolecat, 2025-03-15:
> Funnily enough I have just been playing with this idea as well and added a ++flags command. For now, it adds 3 flags - AR488~RDY, Read^OK and Sent^OK which can be individually turned on or off as required.

Excellent, happy to try that out for you when it's ready.

Twilight-Logic, 2025-03-15:
Just seen that our posts crossed, so moved the attachment here. If you have an alternative idea and time to make the changes then by all means experiment and send a PR. In the meantime I have attached my effort based on your observations.

[AR488-test-flags.zip](https://github.com/user-attachments/files/19265579/AR488-test-flags.zip)

tpolecat, 2025-03-18:
Hi, I just had a chance to try out `++flags` and it works perfectly. I switched my code to expect the new messages and everything works great. Thanks so much, super helpful.

Twilight-Logic, 2025-03-18:
That is good to hear. The feature will be included in the next release which will hopefully not be too much longer in coming.

Twilight-Logic, 2025-04-08:
Please note that there was an error in the above which has been corrected in the release. The value to turn on the `Send^OK` flag is 0x04 not 0x07. To turn on `AR488~RDY` plus `Send^OK` requires ++flags 5. A value of 0x07 should turn on all flags.

Thread 50 (2025-02-24):

AR488 at HP8753C: does not read plot data

Yrrah53, 2025-02-24:
I have three GPIB-USB interfaces: a genuine Prologix adapter, and two AR488 adapters, one with Bluetooth and and one with just USB. The AR488 adapters merely consist of a Pro Micro and a Centronics connector. The BT device has a HC-05 unit attached. SW version: 1.8.15/0.51.29. All adapters work fine with a Python script and a HP437B power meter. Goal is to get plot data from network analyzers: the HP8753C and a HP8756A with the K5FX  toolkit. The Prologix adapter works fine. The AR488 adapters have an issue with the HP8753C: upon the plot command only 11 bytes are transmitted (iso about 7700). Getting a plot out of a HP8563E spectrum analyzer this way works fine. I tested the AR488-HP8753C combi with some GPIB commands (like PRES, STAR, STB? etc): works fine. The interface was also monitored using the very useful Redirector tool, kindly provided by an expert who also gave me a lot of assistance. No luck so far with the HP8753C: plot data transmission is aborted after 11 bytes. What can be the issue?
Thanks in advance......

Twilight-Logic, 2025-02-25:
Thank you for your report and the details provided. Could I just confirm which version of the AR488 software you are using?
Also, could you send me a couple of separate files containing both the good and bad data from the HP8573C please?

Yrrah53, 2025-02-25:
Thanks for your respons.
Here are some files that maybe shed some light. These are actually
screenshots made with Redirector by DG8SAQ.
First file: tst_HP8753C..... Line 43/44/48 are interesting: the plot is
aborted after  some (11 as reported by 7470 emulator) bytes. The version is
in line 35.
A different situation gives similar output. File: 63E_LO.... This file is
recorded in a test set-up with a HP8563E and a HP437B power meter to
measure the LO output power of the sa. The SA is controller under sw
command of a TAM (Test and Adjustment Module). Text data are no problem at
all (ref lines 11-20). Then automatically a plot is send thereafter (line
33) and quickly aborted. This was repeated once with same result....
So the issue is: why is text data no problem and is plot data aborted? Same
happens when GPIB Configurator is used in conjunction with 7470.exe.
Best regards,
Y

On Tue, 25 Feb 2025 at 10:31, Twilight-Logic ***@***.***>
wrote:

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

Twilight-Logic, 2025-02-25:
Thank you. I don't see the attached files however? Just edit your post on Github and drag and drop the files into it please.

Twilight-Logic, 2025-03-09:
Could you attach a complete plot output using the Prologix please? I need to see the complete plot data.

Can you also tell me what settings you have for the following:

++eoi
++eos
++eor

Thank you.

Yrrah53, 2025-03-10:
Hello,

Thanks for your response. I think I already send it to you. Please refer to
annex (rtf format).
At line 16 you see that the regular Prologix adapter is used. Line 40 shows
the complete plot.
At line 72 you see I switched adapter to the AR488, nicknamed Prologix
6.101.
Line 81 shows the plot as it is received, only a few characters.
Thank you for your attention.  If you need more info/data, please let me
know.
Kind regards,
Harke

On Sun, 9 Mar 2025 at 15:41, Twilight-Logic ***@***.***>
wrote:

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

Twilight-Logic, 2025-03-11:
There is no line 72 or 81 in the files you have attached. File [tst_HP8753C_AR488_V3962.docx (renamed to .rtf) seems to end at line 50. I did try saving to a .txt file but it made no difference.

Is file 63E_LO_ampl_AR488.docx the actual plot?

Unfortunately encapsulating in another format such as RTF or DOCX mangles the data. I suspect the top part of the file is missing as I see no output from the Prologix, but I see clearly that the output from the AR488 is only ';;;;DF;IM;' and that you have set ++auto 1. The other parameters I asked for above will presumably be set to defaults.

Ideally it needs to be saved as a raw .txt or .bin file exactly as it comes out of the GPIB adapter.

In the meantime, I am wondering whether some character or other is being mis-interpreted. I would suggest trying setting the line terminator for the incoming data to either NL (++eor 2) or the EOI signal (++eor 7) and see whether that makes a difference.

Yrrah53, 2025-03-11:
I am very sorry, I am afraid I attached the wrong file? Attached is the
correct file. Saved as txt file. Now I hope the line numbers make sense. I
open/save the file in Notepad++. The first part is a recording of the data
transfer via Prologix, the second part with an AR488, nicknamed Prologix
6.101.

Best regards,
Harke

On Tue, 11 Mar 2025 at 11:20, Twilight-Logic ***@***.***>
wrote:

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

{\rtf1\ansi\ansicpg1252\deff0\deflang1043{\fonttbl{\f0\fnil Tahoma;}{\f1\fnil\fcharset0 Tahoma;}}
{\colortbl ;\red255\green0\blue0;\red0\green0\blue255;\red0\green0\blue0;}
\viewkind4\uc1\pard\cf1\f0\fs20 ++auto 1
\par ++eos 0
\par ++mode 1
\par ++addr 16
\par ++eoi 1
\par OUTPIDEN;
\par \cf2 HEWLETT PACKARD,8753C,0,4.13
\par \cf3 ComPort A disconnected
\par Connecting...
\par Connected!
\par Connected to client 127.0.0.1 , port = 8488
\par \cf1 ++eot_enable 0
\par ++ver
\par \cf2 Prologix GPIB-USB Controller version 5.3
\par \cf1 ++auto
\par \cf2 1
\par \cf1 ++eos 0
\par ++mode 1
\par ++addr 16
\par ++eoi 1
\par OUTPERRO
\par \cf2     0 ,"NO ERRORS"
\par \cf1 ++auto 0
\par ++loc
\par \cf3 Client 127.0.0.1 disconnected
\par Connected to client 127.0.0.1 , port = 8488
\par \cf1 ++eot_enable 0
\par ++ver
\par \cf2 Prologix GPIB-USB Controller version 5.3
\par \cf1 ++auto
\par \cf2 0
\par \cf1 ++auto 1
\par ++eos 0
\par ++mode 1
\par ++addr 16
\par ++eoi 1
\par OUTPPLOT;
\par \cf2\'03;;;;DF;IM;IP250,279,10250,7479;SC0 ,4095 ,0 ,4212 ;;PU;VS;SP1;;PU;PA0,0;PA244 ,1110 ;PD;PA244 ,1110 ;PA244 ,1110 ;PA260 ,1126 ;PA276 ,1116 ;PA292 ,1114 ;PA308 ,1112 ;PA324 ,1112 ;PA340 ,1112 ;PA356 ,1112 ;PA372 ,1114 ;PA388 ,1116 ;PA404 ,1118 ;PA420 ,1120 ;PA436 ,1120 ;PA452 ,1122 ;PA468 ,1122 ;PA484 ,1122 ;PA500 ,1122 ;PA516 ,1122 ;PA532 ,1122 ;PA548 ,1120 ;PA564 ,1120 ;PA580 ,1120 ;PA596 ,1118 ;PA612 ,1118 ;PA628 ,1116 ;PA644 ,1116 ;PA660 ,1114 ;PA676 ,1114 ;PA692 ,1112 ;PA708 ,1110 ;PA724 ,1110 ;PA740 ,1108 ;PA756 ,1106 ;PA772 ,1102 ;PA788 ,1098 ;PA804 ,1096 ;PA820 ,1092 ;PA836 ,1090 ;PA852 ,1084 ;PA868 ,1082 ;PA884 ,1080 ;PA900 ,1076 ;PA916 ,1072 ;PA932 ,1068 ;PA948 ,1066 ;PA964 ,1064 ;PA980 ,1060 ;PA996 ,1056 ;PA1012 ,1054 ;PA1028 ,1054 ;PA1044 ,1050 ;PA1060 ,1050 ;PA1076 ,1048 ;PA1092 ,1050 ;PA1108 ,1050 ;PA1124 ,1048 ;PA1140 ,1048 ;PA1156 ,1048 ;PA1172 ,1048 ;PA1188 ,1046 ;PA1204 ,1044 ;PA1220 ,1044 ;PA1236 ,1044 ;PA1252 ,1042 ;PA1268 ,1044 ;PA1284 ,1044 ;PA1300 ,1044 ;PA1316 ,1046 ;PA1332 ,1048 ;PA1348 ,1048 ;PA1364 ,1050 ;PA1380 ,1050 ;PA1396 ,1054 ;PA1412 ,1056 ;PA1428 ,1056 ;PA1444 ,1060 ;PA1460 ,1062 ;PA1476 ,1068 ;PA1492 ,1074 ;PA1508 ,1080 ;PA1524 ,1084 ;PA1540 ,1092 ;PA1556 ,1096 ;PA1572 ,1100 ;PA1588 ,1106 ;PA1604 ,1106 ;PA1620 ,1110 ;PA1636 ,1114 ;PA1652 ,1116 ;PA1668 ,1118 ;PA1684 ,1118 ;PA1700 ,1122 ;PA1716 ,1124 ;PA1732 ,1124 ;PA1748 ,1126 ;PA1764 ,1126 ;PA1780 ,1128 ;PA1796 ,1126 ;PA1812 ,1126 ;PA1828 ,1124 ;PA1844 ,1122 ;PA1860 ,1118 ;PA1876 ,1116 ;PA1892 ,1114 ;PA1908 ,1114 ;PA1924 ,1112 ;PA1940 ,1110 ;PA1956 ,1112 ;PA1972 ,1112 ;PA1988 ,1112 ;PA2004 ,1110 ;PA2020 ,1110 ;PA2036 ,1108 ;PA2052 ,1106 ;PA2068 ,1106 ;PA2084 ,1102 ;PA2100 ,1100 ;PA2116 ,1098 ;PA2132 ,1098 ;PA2148 ,1098 ;PA2164 ,1100 ;PA2180 ,1098 ;PA2196 ,1100 ;PA2212 ,1098 ;PA2228 ,1100 ;PA2244 ,1098 ;PA2260 ,1098 ;PA2276 ,1096 ;PA2292 ,1096 ;PA2308 ,1096 ;PA2324 ,1096 ;PA2340 ,1096 ;PA2356 ,1102 ;PA2372 ,1106 ;PA2388 ,1108 ;PA2404 ,1114 ;PA2420 ,1118 ;PA2436 ,1124 ;PA2452 ,1130 ;PA2468 ,1136 ;PA2484 ,1142 ;PA2500 ,1148 ;PA2516 ,1152 ;PA2532 ,1160 ;PA2548 ,1164 ;PA2564 ,1174 ;PA2580 ,1182 ;PA2596 ,1192 ;PA2612 ,1200 ;PA2628 ,1208 ;PA2644 ,1214 ;PA2660 ,1222 ;PA2676 ,1228 ;PA2692 ,1232 ;PA2708 ,1236 ;PA2724 ,1240 ;PA2740 ,1242 ;PA2756 ,1242 ;PA2772 ,1242 ;PA2788 ,1242 ;PA2804 ,1244 ;PA2820 ,1244 ;PA2836 ,1244 ;PA2852 ,1244 ;PA2868 ,1242 ;PA2884 ,1242 ;PA2900 ,1240 ;PA2916 ,1238 ;PA2932 ,1234 ;PA2948 ,1228 ;PA2964 ,1224 ;PA2980 ,1218 ;PA2996 ,1212 ;PA3012 ,1208 ;PA3028 ,1206 ;PA3044 ,1204 ;PA3060 ,1204 ;PA3076 ,1198 ;PA3092 ,1196 ;PA3108 ,1194 ;PA3124 ,1190 ;PA3140 ,1188 ;PA3156 ,1182 ;PA3172 ,1176 ;PA3188 ,1174 ;PA3204 ,1170 ;PA3220 ,1172 ;PA3236 ,1174 ;PA3252 ,1176 ;PA3268 ,1178 ;PA3284 ,1182 ;PA3300 ,1182 ;PA3316 ,1188 ;PA3332 ,1190 ;PA3348 ,1194 ;PA3364 ,1200 ;PA3380 ,1204 ;PA3396 ,1208 ;PA3412 ,1212 ;PA3428 ,1220 ;PA3444 ,1228 ;PU;PA0,0LT;;PU;PA0,0SP3;;PU;PA0,0LT;;PA3444 ,152 ;PD;PA244 ,152 ;PU;PA244 ,532 ;PD;PA3444 ,532 ;PU;PA3444 ,912 ;PD;PA244 ,912 ;PU;PA244 ,1292 ;PD;PA3444 ,1292 ;PU;PA3444 ,1672 ;PD;PA244 ,1672 ;PU;PA244 ,2052 ;PD;PA3444 ,2052 ;PU;PA3444 ,2432 ;PD;PA244 ,2432 ;PU;PA244 ,2812 ;PD;PA3444 ,2812 ;PU;PA3444 ,3192 ;PD;PA244 ,3192 ;PU;PA244 ,3572 ;PD;PA3444 ,3572 ;PU;PA3444 ,3952 ;PD;PA244 ,3952 ;PA244 ,152 ;PU;PA564 ,152 ;PD;PA564 ,3952 ;PU;PA884 ,3952 ;PD;PA884 ,152 ;PU;PA1204 ,152 ;PD;PA1204 ,3952 ;PU;PA1524 ,3952 ;PD;PA1524 ,152 ;PU;PA1844 ,152 ;PD;PA1844 ,3952 ;PU;PA2164 ,3952 ;PD;PA2164 ,152 ;PU;PA2484 ,152 ;PD;PA2484 ,3952 ;PU;PA2804 ,3952 ;PD;PA2804 ,152 ;PU;PA3124 ,152 ;PD;PA3124 ,3952 ;PU;PA3444 ,3952 ;PD;PA3444 ,152 LT;;PU;PA3444 ,2052 ;PD;PA244 ,2052 ;PA204 ,2072 ;PA204 ,2032 ;PA244 ,2052 SP1;;PU;PA0,0;PA0 ,4018 SR .981 , 1.519 ;;LBCH1 \'03;LT;;LBS\'03;;PA300 ,3986 ;LB11\'03;;PA420 ,4018 ;LB \'03;LT;;PA600 ,4018 ;LBlog MAG\'03;;PA1320 ,4018 ;LB10 dB/\'03;;PA1800 ,4018 ;LBREF 0 dB\'03;;PA0 ,24 ;LB    START    .300 000 MHz\'03;;PA2124 ,24 ;LBSTOP 3 000.000 000 MHz\'03;;PA1264 ,24 ;PA1800 ,24 LT;;PU;PA0,0;PA0 ,3584 SR .981 , 1.519 ;;LB \'03;;PA0 ,3456 ;LB  \'03;;PA0 ,1408 ;LB  \'03;;PA0 ,128 ;LB \'03;;PU;PA0,0;PA270 ,3824 SR .981 , 1.519 ;;LB\'03;;PA288 ,3824 ;PA288 ,3824 ;PA299 ,3890 ;PD;PA288 ,3890 ;PA288 ,3824 ;PA316 ,3824 ;PU;PA299 ,3842 ;PD;PA311 ,3890 ;PU;PA305 ,3866 ;PD;PA322 ,3866 ;PA316 ,3842 ;PU;PA348 ,3824 ;PA330 ,3824 ;PA330 ,3824 ;PD;PA341 ,3866 ;PA353 ,3866 ;PA358 ,3860 ;PA353 ,3842 ;PA335 ,3842 ;PU;PA330 ,3890 ;PD;PA370 ,3890 ;PA370 ,3824 ;PA341 ,3824 ;PU;PA390 ,3824 ;PA0 ,2688 ;LB \'03;;PA0 ,3328 ;LB \'03;;PA0 ,3072 ;LB \'03;;PA0 ,2944 ;LB \'03;;PA0 ,2816 ;LB \'03;;PA0 ,3200 ;LB \'03;;PA0 ,2560 ;LB \'03;;PA0 ,2432 ;LB \'03;;PA60 ,2432 ;PA77 ,2432 ;PD;PA77 ,2492 ;PU;PA65 ,2474 ;PD;PA77 ,2492 ;PA88 ,2474 ;PU;PA120 ,2432 ;PA0 ,2304 ;LB \'03;;PU;PA0,0LT;;PA270 ,3444 SR .981 , 1.519 ;;LBCAUTION: ADDRESSED TO TALK WITH NOTHING TO SAY\'03;LT;;PA270 ,3242 SR 1.472 , 2.279 ;;LBHP8753C.04.13: Mar 26, 1993\'03;;PA390 ,3032 ;PA270 ,2862 SR .981 , 1.519 ;;LBSER. NO. 3029A01531 OPTIONS: 010,\'03;;PA0 ,2862 ;LB\'03;;PA0 ,2734 ;LB     Copyright \'03;SR 1.472 , 2.279 ;;LB\'03;;PA900 ,2734 ;PA990 ,2734 SR .981 , 1.519 ;;LB 1986,1991 by Hewlett-Packard Co.\'03;;PA0 ,2734 ;LB\'03;;PA0 ,2606 ;LB     All rights reserved.\'03;SP5;;PU;PA0,0;PA194 ,1110 LT;;PA3504 ,4018 ;PA3444 ,3824 ;PA3444 ,3622 LT;;PA3444 ,3444 ;PA3444 ,3242 ;PA3444 ,3064 ;PA3444 ,2862 ;PA3504 ,3476 ;PA3504 ,3386 ;PA3504 ,3296 ;PA3504 ,3206 ;PA3504 ,3112 ;PA3504 ,3024 ;PA3504 ,2934 ;PA3504 ,2844 ;PA3504 ,2754 ;PA3504 ,2664 ;PA3504 ,2574 ;PA3504 ,2484 ;PA3504 ,2394 ;PA3504 ,2304 ;PA3504 ,2214 ;PA3084 ,2304 SR 1.472 , 2.279 ;;LB \'03;LT;;PA3444 ,3032 ;PA3444 ,2560 SP1;;PU;PA0,0LT;SP0;PU
\par \cf1 ++auto 0
\par ++loc
\par \cf3 Client 127.0.0.1 disconnected
\par ComPort A disconnected
\par connect.ini restored to previous state.
\par ComPort COM4 has been removed.
\par ComPort COM6 has been connected.
\par Connecting...
\par Com interface A Exception: Unable to open com port
\par Error: ComPort A could not be opened!
\par Connecting...
\par Connected!
\par Connected to client 127.0.0.1 , port = 8488
\par \cf1 ++eot_enable 0
\par ++ver
\par \cf2 Prologix version 6.101
\par \cf1 ++auto
\par \cf2 0
\par \cf1 ++auto 1
\par ++eos 0
\par ++mode 1
\par ++addr 16
\par ++eoi 1
\par OUTPERRO
\par \cf2    31 ,"CAUTION: ADDRESSED TO TALK WITH NOTHING TO SAY"
\par \cf1 ++auto 0
\par ++loc
\par \cf3 Client 127.0.0.1 disconnected
\par Connected to client 127.0.0.1 , port = 8488
\par \cf1 ++eot_enable 0
\par ++ver
\par \cf2 Prologix version 6.101
\par \cf1 ++auto
\par \cf2 0
\par \cf1 ++auto 1
\par ++eos 0
\par ++mode 1
\par ++addr 16
\par ++eoi 1
\par OUTPPLOT;
\par \cf2\f1\'03;;;;DF;IM;\cf1 ++auto 0
\par \f0 ++loc
\par \cf3 Client 127.0.0.1 disconnected
\par
\par }

Twilight-Logic, 2025-03-15:
Thank you for the updated information. It does seems to be literally reading just the first 11 characters. This will need further investigation.

Yrrah53, 2025-03-16:
Yes, that is exactly what I mean. Hope you can find a solution. Best regards,Harke(Send from my iPad4)Op 15 mrt 2025 om 16:16 heeft Twilight-Logic ***@***.***> het volgende geschreven:
  Thank you for the updated information. It does seems to be literally reading just the first 11 characters. This will need further investigation.—Reply to this email directly, view it on GitHub, or unsubscribe.You are receiving this because you authored the thread.Message ID: ***@***.***>

Twilight-Logic left a comment (Twilight-Logic/AR488#50)
Thank you for the updated information. It does seems to be literally reading just the first 11 characters. This will need further investigation.

—Reply to this email directly, view it on GitHub, or unsubscribe.You are receiving this because you authored the thread.Message ID: ***@***.***>

Twilight-Logic, 2025-03-26:
Apologies for the delay im getting back to you.

I set up a test rig to allow me to send the HP data as shown above over GPIB between to an AR488 adapter and the file was transmited whole. I was entering commands by hand, but also tested using a script. Of course, I am not testing with a HP8753 so the result may not be meaningful other than to show that it is possible to transmit the complete file over GPIB and have it received by the AR488 intact.

Is it possible for you to try with the version attached to this post please:

https://www.eevblog.com/forum/projects/ar488-arduino-based-gpib-adapter/msg5858619/#msg5858619

I would be nterested to know whether the same happens.

Thanks.

Yrrah53, 2025-03-28:
I loaded this version successfully: 0.52.29 24/03/2025. It runs normal with
my HP437B power meter, that I use to test the interface. Then I connect the
AR488 to my HP8753C vna. I run GPIB configurator and then 7470 Plotter
emulator. I still only get 11 bytes....
Best 73 de Harke

On Wed, 26 Mar 2025 at 21:40, Twilight-Logic ***@***.***>
wrote:

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

Twilight-Logic, 2025-03-30:
Was this without the last two commands, i.e. `++auto` and `++loc` ?

Yrrah53, 2025-03-31:
Its getting interesting. When I invoke a plot via Redirector it works. When
I try to get a plot via GPIB Configurator and 7470 emulator I only get the
11 bytes. When I try to connect the device via Redirector with the plotter
emulator I only get the usual 11 bytes. However,I can not repeat the first
successful result.
 These tests are shown in the txt file attached, with the exception of the
Toolkit test, of course.
If you need more data, just let me know, please.
Best regards,
Harke

On Sun, 30 Mar 2025 at 19:02, Twilight-Logic ***@***.***>
wrote:

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

{\rtf1\ansi\ansicpg1252\deff0\deflang1043{\fonttbl{\f0\fnil Tahoma;}{\f1\fnil\fcharset0 Tahoma;}}
{\colortbl ;\red0\green0\blue0;\red255\green0\blue0;\red0\green0\blue255;}
\viewkind4\uc1\pard\cf1\f0\fs20 Connecting...
\par Connected!
\par \cf2 ++ver
\par \cf3 AR488 GPIB controller, ver. 0.52.29, 24/03/2025
\par \cf2 ++id verstr Prologix AR488 HRK version 6.101
\par \cf3 Prologix AR488 HRK version 6.101
\par \cf2 ++savecfg
\par ++ver
\par \cf3 Prologix AR488 HRK version 6.101
\par \cf2 ++ver real
\par \cf3 AR488 GPIB controller, ver. 0.52.29, 24/03/2025
\par \cf2 IDN?
\par ++ver real
\par \cf3 AR488 GPIB controller, ver. 0.52.29, 24/03/2025
\par \cf2 ++ver
\par \cf3 Prologix AR488 HRK version 6.101
\par \cf2 ++addr 21
\par ++mode 1
\par ++auto 1
\par ++addr 16
\par IDN?
\par \cf3 HEWLETT PACKARD,8753C,0,4.13
\par \cf2 OUTPPLOT
\par \cf3\'03;;;;DF;IM;IP250,279,10250,7479;SC0 ,4095 ,0 ,4212 ;;PU;VS;SP1;;PU;PA0,0\f1 ;PA244 ,1980 ;PD;PA244 ,1980 ;PA244 ,1980 ;PA260 ,1976 ;PA276 ,1968 ;PA292 ,1964 ;PA308 ,1960 ;PA324 ,1958 ;PA340 ,1956 ;PA356 ,1956 ;PA372 ,1960 ;PA388 ,1964 ;PA404 ,1968 ;PA420 ,1970 ;PA436 ,1972 ;PA452 ,1972 ;PA468 ,1972 ;PA484 ,1972 ;PA500 ,1970 ;PA516 ,1970 ;PA532 ,1970 ;PA548 ,1974 ;PA564 ,1978 ;PA580 ,1984 ;PA596 ,1988 ;PA612 ,1986 ;PA628 ,1982 ;PA644 ,1976 ;PA660 ,1970 ;PA676 ,1972 ;PA692 ,1972 ;PA708 ,1976 ;PA724 ,1980 ;PA740 ,1980 ;PA756 ,1982 ;PA772 ,1982 ;PA788 ,1980 ;PA804 ,1978 ;PA820 ,1976 ;PA836 ,1972 ;PA852 ,1972 ;PA868 ,1972 ;PA884 ,1974 ;PA900 ,1978 ;PA916 ,1980 ;PA932 ,1978 ;PA948 ,1976 ;PA964 ,1974 ;PA980 ,1974 ;PA996 ,1972 ;PA1012 ,1970 ;PA1028 ,1966 ;PA1044 ,1962 ;PA1060 ,1960 ;PA1076 ,1960 ;PA1092 ,1964 ;PA1108 ,1970 ;PA1124 ,1972 ;PA1140 ,1972 ;PA1156 ,1970 ;PA1172 ,1966 ;PA1188 ,1962 ;PA1204 ,1958 ;PA1220 ,1956 ;PA1236 ,1954 ;PA1252 ,1952 ;PA1268 ,1952 ;PA1284 ,1954 ;PA1300 ,1956 ;PA1316 ,1956 ;PA1332 ,1954 ;PA1348 ,1948 ;PA1364 ,1942 ;PA1380 ,1938 ;PA1396 ,1936 ;PA1412 ,1936 ;PA1428 ,1936 ;PA1444 ,1936 ;PA1460 ,1936 ;PA1476 ,1934 ;PA1492 ,1934 ;PA1508 ,1932 ;PA1524 ,1936 ;PA1540 ,1936 ;PA1556 ,1938 ;PA1572 ,1938 ;PA1588 ,1938 ;PA1604 ,1936 ;PA1620 ,1934 ;PA1636 ,1934 ;PA1652 ,1932 ;PA1668 ,1932 ;PA1684 ,1932 ;PA1700 ,1934 ;PA1716 ,1940 ;PA1732 ,1944 ;PA1748 ,1948 ;PA1764 ,1948 ;PA1780 ,1948 ;PA1796 ,1946 ;PA1812 ,1946 ;PA1828 ,1948 ;PA1844 ,1950 ;PA1860 ,1952 ;PA1876 ,1954 ;PA1892 ,1956 ;PA1908 ,1954 ;PA1924 ,1956 ;PA1940 ,1958 ;PA1956 ,1960 ;PA1972 ,1962 ;PA1988 ,1962 ;PA2004 ,1962 ;PA2020 ,1962 ;PA2036 ,1962 ;PA2052 ,1962 ;PA2068 ,1962 ;PA2084 ,1964 ;PA2100 ,1964 ;PA2116 ,1962 ;PA2132 ,1964 ;PA2148 ,1966 ;PA2164 ,1968 ;PA2180 ,1966 ;PA2196 ,1962 ;PA2212 ,1960 ;PA2228 ,1958 ;PA2244 ,1960 ;PA2260 ,1964 ;PA2276 ,1968 ;PA2292 ,1968 ;PA2308 ,1968 ;PA2324 ,1962 ;PA2340 ,1958 ;PA2356 ,1954 ;PA2372 ,1952 ;PA2388 ,1954 ;PA2404 ,1958 ;PA2420 ,1958 ;PA2436 ,1960 ;PA2452 ,1962 ;PA2468 ,1964 ;PA2484 ,1962 ;PA2500 ,1956 ;PA2516 ,1950 ;PA2532 ,1942 ;PA2548 ,1936 ;PA2564 ,1934 ;PA2580 ,1934 ;PA2596 ,1932 ;PA2612 ,1932 ;PA2628 ,1930 ;PA2644 ,1930 ;PA2660 ,1932 ;PA2676 ,1934 ;PA2692 ,1934 ;PA2708 ,1932 ;PA2724 ,1926 ;PA2740 ,1920 ;PA2756 ,1914 ;PA2772 ,1912 ;PA2788 ,1914 ;PA2804 ,1918 ;PA2820 ,1924 ;PA2836 ,1926 ;PA2852 ,1928 ;PA2868 ,1928 ;PA2884 ,1926 ;PA2900 ,1924 ;PA2916 ,1920 ;PA2932 ,1914 ;PA2948 ,1912 ;PA2964 ,1916 ;PA2980 ,1920 ;PA2996 ,1924 ;PA3012 ,1928 ;PA3028 ,1932 ;PA3044 ,1934 ;PA3060 ,1934 ;PA3076 ,1936 ;PA3092 ,1936 ;PA3108 ,1938 ;PA3124 ,1940 ;PA3140 ,1940 ;PA3156 ,1940 ;PA3172 ,1940 ;PA3188 ,1942 ;PA3204 ,1942 ;PA3220 ,1942 ;PA3236 ,1940 ;PA3252 ,1940 ;PA3268 ,1940 ;PA3284 ,1942 ;PA3300 ,1944 ;PA3316 ,1944 ;PA3332 ,1944 ;PA3348 ,1946 ;PA3364 ,1948 ;PA3380 ,1952 ;PA3396 ,1956 ;PA3412 ,1960 ;PA3428 ,1960 ;PA3444 ,1960 ;PU;PA0,0LT;;PU;PA0,0SP3;;PU;PA0,0LT;;PA3444 ,152 ;PD;PA244 ,152 ;PU;PA244 ,532 ;PD;PA3444 ,532 ;PU;PA3444 ,912 ;PD;PA244 ,912 ;PU;PA244 ,1292 ;PD;PA3444 ,1292 ;PU;PA3444 ,1672 ;PD;PA244 ,1672 ;PU;PA244 ,2052 ;PD;PA3444 ,2052 ;PU;PA3444 ,2432 ;PD;PA244 ,2432 ;PU;PA244 ,2812 ;PD;PA3444 ,2812 ;PU;PA3444 ,3192 ;PD;PA244 ,3192 ;PU;PA244 ,3572 ;PD;PA3444 ,3572 ;PU;PA3444 ,3952 ;PD;PA244 ,3952 ;PA244 ,152 ;PU;PA564 ,152 ;PD;PA564 ,3952 ;PU;PA884 ,3952 ;PD;PA884 ,152 ;PU;PA1204 ,152 ;PD;PA1204 ,3952 ;PU;PA1524 ,3952 ;PD;PA1524 ,152 ;PU;PA1844 ,152 ;PD;PA1844 ,3952 ;PU;PA2164 ,3952 ;PD;PA2164 ,152 ;PU;PA2484 ,152 ;PD;PA2484 ,3952 ;PU;PA2804 ,3952 ;PD;PA2804 ,152 ;PU;PA3124 ,152 ;PD;PA3124 ,3952 ;PU;PA3444 ,3952 ;PD;PA3444 ,152 LT;;PU;PA3444 ,2052 ;PD;PA244 ,2052 ;PA204 ,2072 ;PA204 ,2032 ;PA244 ,2052 SP1;;PU;PA0,0;PA0 ,4018 SR .981 , 1.519 ;;LBCH1 \'03;LT;;LBS\'03;;PA300 ,3986 ;LB11\'03;;PA420 ,4018 ;LB \'03;LT;;PA600 ,4018 ;LBlog MAG\'03;;PA1320 ,4018 ;LB10 dB/\'03;;PA1800 ,4018 ;LBREF 0 dB\'03;;PA0 ,24 ;LB    START    .300 000 MHz\'03;;PA2124 ,24 ;LBSTOP 3 000.000 000 MHz\'03;;PA1264 ,24 ;PA1800 ,24 LT;;PU;PA0,0;PA0 ,3584 SR .981 , 1.519 ;;LB \'03;;PA0 ,3456 ;LB  \'03;;PA0 ,1408 ;LB  \'03;;PA0 ,128 ;LB \'03;;PU;PA0,0;PA270 ,3824 SR .981 , 1.519 ;;LB\'03;;PA288 ,3824 ;PA288 ,3824 ;PA299 ,3890 ;PD;PA288 ,3890 ;PA288 ,3824 ;PA316 ,3824 ;PU;PA299 ,3842
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

Thread 51 (2025-04-08):

Connecting to NI MAX

YYYYYJS, 2025-04-08:
Hi, may I ask—if I use NI's GPIB-USB-HS to connect to the AR488, will NI MAX be able to recognize it successfully?

Twilight-Logic, 2025-04-08:
I don't have a definite answer for this as I have not been able to test it with a GPIB-USB-HS adapter. The AR488 doesn't yet recognise NI's high speed protocol released in the updated standard 488.1 but the NI adapter should be able to drop back to standard GPIB and be able to interoperate. I would be interested in knowing the answer to this myself.

YYYYYJS, 2025-04-09:
谢谢，我现在正在尝试。如果有结果我再告诉你

> 我对此没有明确的答案，因为我无法用 GPIB-USB-HS 适配器对其进行测试。AR488 尚不认可更新后的标准 488.1 中发布的 NI 高速协议，但 NI 适配器应该能够退回到标准 GPIB 并能够互作。我很想知道自己这个问题的答案。

YYYYYJS, 2025-04-09:
Thank you, I'm trying it now. I'll let you know if I get any results.

> I don't have a definite answer for this as I have not been able to test it with a GPIB-USB-HS adapter. The AR488 doesn't yet recognise NI's high speed protocol released in the updated standard 488.1 but the NI adapter should be able to drop back to standard GPIB and be able to interoperate. I would be interested in knowing the answer to this myself.

TekCastPork, 2025-09-26:
I'm trying the same thing, but also with HS+ adapters, and I've been finding that with a configuration which should set the ar488 as a device with PAD 1 AND NO_SAD (changing `cmode` to 1, ontop of `MACRO_0` executing a `++mode 0` just in case) NI-MAX reports finding too many devices on the bus when i scan for instruments, despite the only thing being connected is my ar488.

I can see my ar488 receiving data from the bus when it scans via the debug console. This is on an atmega328pb on a custom board, but it does use the pinout config of the standard UNO layout, utilizing SN7516x buffers.

YYYYYJS, 2025-09-27:
Thank you for your detailed email describing the issue you encountered. It was very helpful to read about your specific setup and troubleshooting steps.
I'm quite interested in the "device overload" problem you faced with NI-MAX during the instrument scan. I was wondering if you have had any success in resolving it since your last message? I would be very grateful to hear about any new findings or potential solutions you might have discovered.
Please let me know if there is any additional information from my end that could help in diagnosing the problem.
Best regards,
Jiasheng Yin
---- Replied Message ----
From ***@***.***> Date 09/26/2025 23:28 To ***@***.***> Cc ***@***.***>***@***.***> Subject Re: [Twilight-Logic/AR488] Connecting to NI MAX (Issue #51)
TekCastPork left a comment (Twilight-Logic/AR488#51)
I'm trying the same thing, but also with HS+ adapters, and I've been finding that with a configuration which should set the ar488 as a device with PAD 1 AND NO_SAD (changing cmode to 1, ontop of MACRO_0 executing a ++mode 0 just in case) NI-MAX reports finding too many devices on the bus when i scan for instruments, despite the only thing being connected is my ar488.
I can see my ar488 receiving data from the bus when it scans via the debug console. This is on an atmega328pb on a custom board, but it does use the pinout config of the standard UNO layout, utilizing SN7516x buffers.
—
Reply to this email directly, view it on GitHub, or unsubscribe.
You are receiving this because you authored the thread.Message ID: ***@***.***>

TekCastPork, 2025-09-27:
I havent yet, its also for a work thing I cant really go too deep into what i need it for and also wont be able to touch it again until after the weekend.

From what i can gather though it looks like it may be pulling NDAC low each time my hs+ pulls ATN low.

This makes sense for the 488.2 find listeners function behavior, but it seems to be doing it for every listener address test, which likely explains why it was found 31 times (which is too many, out of 32 possible primary addresses addr 0 is the controller and 31 is a special address invalid for instruments, so it can only use between addr 1 and addr 30).

Im going to sniff the data lines more in depth when I work on it again to hopefully confirm this theory.

YYYYYJS, 2025-09-27:
Thank you for the update and sharing your detailed analysis. Your reasoning about the NDAC/ATN interaction and address range makes a lot of sense and is very helpful.
I'll also be sure to share any findings from my end as I continue my own testing. Looking forward to your further findings next week. Enjoy your weekend.
---- Replied Message ----
From ***@***.***> Date 09/27/2025 11:19 To ***@***.***> Cc ***@***.***>***@***.***> Subject Re: [Twilight-Logic/AR488] Connecting to NI MAX (Issue #51)
TekCastPork left a comment (Twilight-Logic/AR488#51)
I havent yet, its also for a work thing I cant really go too deep into what i need it for and also wont be able to touch it again until after the weekend.
From what i can gather though it looks like it may be pulling NDAC low each time my hs+ pulls ATN low.
This makes sense for the 488.2 find listeners function behavior, but it seems to be doing it for every listener address test, which likely explains why it was found 31 times (which is too many, out of 32 possible primary addresses addr 0 is the controller and 31 is a special address invalid for instruments, so it can only use between addr 1 and addr 30).
Im going to sniff the data lines more in depth when I work on it again to hopefully confirm this theory.
—
Reply to this email directly, view it on GitHub, or unsubscribe.
You are receiving this because you authored the thread.Message ID: ***@***.***>

Thread 56 (2025-04-23):

GPIB Hangup Issues

kmuthugtk, 2025-04-23:
During a test run, I suddenly encountered a GPIB hang-up issue on the tester side, which resulted in missing data. Please refer to the attached screenshot for details. I would appreciate it if anyone could help provide a solution.

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

Twilight-Logic, 2025-04-25:
I will need some further information.

What hardware were you using?

What program is this screeenshot from?

Twilight-Logic, 2025-07-13:
Closing due the lack of further information. If the issue still persists in version 0.53.20, then please feel free to re-open the case and provide the requested information.

Thank you.

Closed 2025-07-13.

Thread 58 (2025-04-29):

First Character is missing on *IDN?

WilheJo, 2025-04-29:
On my SMY01, the first character is missing since 0.52.26.

See log below.

BTW: DEBUG_GPIBbus_RECEIVE fails to compile as well!

Log 0.52.26:

AR488 GPIB controller, ver. 0.52.26, 16/03/2025
Verbose: ON
>
> ++addr 28

PRI address set to: 28
SEC address set to: unset
>
> *IDN?
AR488_GPIBbus.cpp:861 (setControls) > Set GPIB lines for sending a command
AR488_GPIBbus.cpp:886 (setControls) > Set GPIB lines for writing data
AR488_GPIBbus.cpp:707 (sendData) > write data mode is set.
AR488_GPIBbus.cpp:708 (sendData) > Begin send loop ->
*IDN?AR488_GPIBbus.cpp:738 (sendData) > <- End of send loop.
AR488_GPIBbus.cpp:762 (sendData) > appended CRLF
AR488_GPIBbus.cpp:849 (setControls) > Set GPIB lines to idle state
AR488_GPIBbus.cpp:776 (sendData) > done.
AR488_GPIBbus.cpp:861 (setControls) > Set GPIB lines for sending a command
>
> ++read

AR488_GPIBbus.cpp:874 (setControls) > Set GPIB lines for reading data
ROHDE&SCHWARZ,SMY01,839.069/002,2.02
AR488_GPIBbus.cpp:861 (setControls) > Set GPIB lines for sending a command
AR488_GPIBbus.cpp:849 (setControls) > Set GPIB lines to idle state
>
>

updated to latest upstream (including 2ee1956d9bd6b1539d7557ddb550db8c9a797484)

AR488 GPIB controller, ver. 0.53.04 (JW), 13/04/2025
Verbose: ON
>
> ++addr 28

PRI address set to: 28
SEC address set to: unset
>
> *IDN?
AR488_GPIBbus.cpp:862 (setControls) > Set GPIB lines for sending a command
AR488_GPIBbus.cpp:887 (setControls) > Set GPIB lines for writing data
AR488_GPIBbus.cpp:707 (sendData) > write data mode is set.
AR488_GPIBbus.cpp:708 (sendData) > Begin send loop ->
*IDN?AR488_GPIBbus.cpp:739 (sendData) > <- End of send loop.
AR488_GPIBbus.cpp:763 (sendData) > appended CRLF
AR488_GPIBbus.cpp:850 (setControls) > Set GPIB lines to idle state
AR488_GPIBbus.cpp:777 (sendData) > done.
AR488_GPIBbus.cpp:862 (setControls) > Set GPIB lines for sending a command
>
> ++read

AR488_GPIBbus.cpp:875 (setControls) > Set GPIB lines for reading data
OHDE&SCHWARZ,SMY01,839.069/002,2.02
AR488_GPIBbus.cpp:850 (setControls) > Set GPIB lines to idle state
AR488_GPIBbus.cpp:862 (setControls) > Set GPIB lines for sending a command
>
>

Twilight-Logic, 2025-04-29:
Thanks for the report. I will compare the code bases to see whether I can spot anything. I take it that this is happening without debugs enabled?

I will also check why DEBUG_GPIBbus_RECEIVE fails to compile.

WilheJo, 2025-04-29:
Yes. Happens both, with and without debug options.

Twilight-Logic, 2025-04-29:
I have tidied up the debug compile problem and checked the other debug options for similar issues.

Of course the more important problem is the dropping of the character.. Could you tell me which board you are using and which instrument please?

WilheJo, 2025-04-29:
Upps... Missed this little piece of information...

It's running on a esp32s2 with 7516x buffers.

Code: https://github.com/WilheJo-Org1/AR488

Schematic: https://www.diyemc.com/Products/Esp32s2Ar488/Rev4-Schematic.pdf

The code in the repo includes besides the layout some changes to have cdc with tiny-usb instead of the cdc-on-boot serial to have a serial number based on the factory programmed MAC addresses.
I checked without these as well... Same behaviour.

Twilight-Logic, 2025-04-29:
I wasn't expecting an ESP32 so that is interesting. I see that you are using the `ESP32_Wilhelm_AR488_ESP32S2_R4` layout and I see that it uses the pin mapping array method used by the custom layout. I haven't actually tested any of the ESP layouts myself yet, which is why there are no pre-defined ESP specific functions yet. The layouts have been pulled from David Douards AR488-ESP32 repository, but its sounds like you have and have been successfully using this configuration up to this point. In any case, testing the ESP32 was on my todo list. I don't think I have an S2, but I do have a couple of Devkit v1 WROOM's which should hopefully suffice for test purposes.

It seems unlikely that cdc changes would have affected reading data from the GPIB bus, but thank you for testing and ruling that out conclusively.

Thinking about it, this would probably have to be related to the ATN read loop but I need to dig deeper and investigate when  have some time.

WilheJo, 2025-07-05:
Still, something's fishy.
I get the correct response, but with debug enabled, I get the following log:

++ver
*IDN?
++read

AR488 GPIB controller, ver. 0.53.17 (JW), 03/07/2025
AR488_GPIBbus.cpp:593 (receiveData) > Start listen ->
AR488_GPIBbus.cpp:594 (receiveData) > Before loop flags:
AR488_GPIBbus.cpp:595 (receiveData) > TRNb: 0
AR488_GPIBbus.cpp:596 (receiveData) > rEOI: 0
AR488_GPIBbus.cpp:1229 (readByte) > Handshake error!
52 AR488_GPIBbus.cpp:1229 (readByte) > Handshake error!
4F AR488_GPIBbus.cpp:1229 (readByte) > Handshake error!
48 AR488_GPIBbus.cpp:1229 (readByte) > Handshake error!
44 AR488_GPIBbus.cpp:1229 (readByte) > Handshake error!
45 AR488_GPIBbus.cpp:1229 (readByte) > Handshake error!
26 AR488_GPIBbus.cpp:1229 (readByte) > Handshake error!
53 AR488_GPIBbus.cpp:1229 (readByte) > Handshake error!
43 AR488_GPIBbus.cpp:1229 (readByte) > Handshake error!
48 AR488_GPIBbus.cpp:1229 (readByte) > Handshake error!
57 AR488_GPIBbus.cpp:1229 (readByte) > Handshake error!
41 AR488_GPIBbus.cpp:1229 (readByte) > Handshake error!
52 AR488_GPIBbus.cpp:1229 (readByte) > Handshake error!
5A AR488_GPIBbus.cpp:1229 (readByte) > Handshake error!
2C AR488_GPIBbus.cpp:1229 (readByte) > Handshake error!
53 AR488_GPIBbus.cpp:1229 (readByte) > Handshake error!
4D AR488_GPIBbus.cpp:1229 (readByte) > Handshake error!
59 AR488_GPIBbus.cpp:1229 (readByte) > Handshake error!
30 AR488_GPIBbus.cpp:1229 (readByte) > Handshake error!
31 AR488_GPIBbus.cpp:1229 (readByte) > Handshake error!
2C AR488_GPIBbus.cpp:1229 (readByte) > Handshake error!
38 AR488_GPIBbus.cpp:1229 (readByte) > Handshake error!
33 AR488_GPIBbus.cpp:1229 (readByte) > Handshake error!
39 AR488_GPIBbus.cpp:1229 (readByte) > Handshake error!
2E AR488_GPIBbus.cpp:1229 (readByte) > Handshake error!
30 AR488_GPIBbus.cpp:1229 (readByte) > Handshake error!
36 AR488_GPIBbus.cpp:1229 (readByte) > Handshake error!
39 AR488_GPIBbus.cpp:1229 (readByte) > Handshake error!
2F AR488_GPIBbus.cpp:1229 (readByte) > Handshake error!
30 AR488_GPIBbus.cpp:1229 (readByte) > Handshake error!
30 AR488_GPIBbus.cpp:1229 (readByte) > Handshake error!
32 AR488_GPIBbus.cpp:1229 (readByte) > Handshake error!
2C AR488_GPIBbus.cpp:1229 (readByte) > Handshake error!
32 AR488_GPIBbus.cpp:1229 (readByte) > Handshake error!
2E AR488_GPIBbus.cpp:1229 (readByte) > Handshake error!
30 AR488_GPIBbus.cpp:1229 (readByte) > Handshake error!
32 AR488_GPIBbus.cpp:1229 (readByte) > Handshake error!
0A AR488_GPIBbus.cpp:1229 (readByte) > Handshake error!

AR488_GPIBbus.cpp:687 (receiveData) > After loop flags:
AR488_GPIBbus.cpp:689 (receiveData) > TMO: 1200
AR488_GPIBbus.cpp:690 (receiveData) > Bytes read:  37
AR488_GPIBbus.cpp:691 (receiveData) > <- End listen.
AR488_GPIBbus.cpp:706 (receiveData) > Timeout waiting for sender!
AR488_GPIBbus.cpp:707 (receiveData) > Timeout waiting for transfer to complete!
AR488_GPIBbus.cpp:734 (receiveData) > done.

Twilight-Logic, 2025-07-13:
Both the ATN timing and the handshake error should be resolved in 0..53.20.

Thread 59 (2025-05-04):

Add maximum_size parameter to receiveData()

hb020, 2025-05-04:
In my integration of the AR488 GPIB interface behind a VXI-11.2 frontend, I had to adapt `receiveData()`:
* add a `maximum_size` parameter
* return the reason of the exit from the function (EOI, EndByte, Timeout, MaxSize,....).

Now this is not directly useful for Prologix, but it is a requirement for VXI-11. Are you willing to support that use case? If so, I am willing to provide a PR.

With the change, it works beautifully behind VXI-11.

Also, a separation of the Prologix part from the setup + loop part (now all mixed in AR488.ino) might be better, but that is not the point of this issue.

Twilight-Logic, 2025-05-05:
> In my integration of the AR488 GPIB interface behind a VXI-11.2 frontend, I had to adapt `receiveData()`:
>
>     * add a `maximum_size` parameter

Apart from quitting reaceiveData(), What happens when maximum is reached? Will incoming data need to e buffered?

>     * return the reason of the exit from the function (EOI, EndByte, Timeout, MaxSize,....).

No problem with this. Just requires changing the return type from bool to uint8_t and assigning some values and then updating each statement where it is already used. Was already planning to do this at some point anyway so I might as well get it into the next release.

> Now this is not directly useful for Prologix, but it is a requirement for VXI-11. Are you willing to support that use case? If so, I am willing to provide a PR.
>
> With the change, it works beautifully behind VXI-11.

I would like to see how this has been implemented if possible please.

> Also, a separation of the Prologix part from the setup + loop part (now all mixed in AR488.ino) might be better, but that is not the point of this issue.

I think I can see how this might help with switching between Prologix and VXI-11. One would just switch the appropriate module. I will give that some thought.

hb020, 2025-05-06:
> Apart from quitting reaceiveData(), What happens when maximum is reached? Will incoming data need to e buffered?

The idea is to stop reading, leave the device addressed, and read the rest later. Stop and Go approach.

> I would like to see how this has been implemented if possible please.

See https://github.com/Kofen/PoE_Ethernet_GPIB_Adapter/blob/7-allow-large-reply-when-using-vxi/SW/src/AR488_GPIBbus.cpp, line 530

It seems that some device are not happy with the way I leave the reads, so I might need to change it a bit more, still investigating. Maybe more like what I did for the writes, where the same max size problem happens, but reversed: https://github.com/Kofen/PoE_Ethernet_GPIB_Adapter/blob/7-allow-large-reply-when-using-vxi/SW/src/main.cpp line 89 (the SCPI_handler class is the interface between VXI and the GPIB bus, in other projects I use that class to connect to a SCPI parser)
But the HPAK material I tested is OK with how it works now.

> I think I can see how this might help with switching between Prologix and VXI-11. One would just switch the appropriate module. I will give that some thought.

See https://github.com/Kofen/PoE_Ethernet_GPIB_Adapter/blob/7-allow-large-reply-when-using-vxi/SW/README.md

Twilight-Logic, 2025-05-08:
I have just pushed a new release and modified receiveData() to provide the return reason as you suggested. It has been done pretty much as in the code you linked, except that instead of adding a parameter, the return type of the function has been changed from bool to an enum, which allows multiple states to be returned rather than just OK or ERR. Otherwise the states are pretty much as you had set out, but using somewhat more descriptive names. I used the suffix `_LIMIT` but happy to change that to `_MAXSIZE` (or just `_MAX`?) if you prefer.

I am happy for you to submit a PR for the MaxSize parameter when you are ready. I will also look at moving the Prologix functions into a separate module and separating them from the main .ino.

Twilight-Logic, 2025-07-18:
The proposed change for maxSize and isLastPacket has been added manually to the current version of the code so the pull request has been closed. However, then you for your submission. The requested changes and fix are now included in the latest version which has been uploaded to the repository.

I am working on a new re-factored version of the project and since the code and the approach to going idle has changed, these changes cannot be applied as they stand to this version. Going to idle is handled in a different way. The interface will go to idle only when an untalk or unlisten is sent. If one is not sent, then it stays active in the current mode. This alternative solution will need to be tested in a real world scenario where it matters such as yours. I am still considering whether it will be worthwhile to back-port it to the existing code. However, as applied to the existing code, this request is now complete.

Thread 65 (2025-06-01):

SDC must not cause a reboot

dl8dtl, 2025-06-01:
When trying to receive data from my R4136 spectrum analyzer as a plotter (i.e. GPIB device), this basically works in `++lon 1` mode.
However, being explicitly addressed (on listener address 5, hard-wired into the analyzer), it causes a reboot.

It turns out the analyzer sends to following command sequence before starting to plot:
```
UNL
TAD 30
LAD 5
SDC
```
About 150 ms later, it takes back the `ATN` signal, and another 100 ms later, it starts emitting plot data.

The `SDC`, however, causes the AR488 firmware to reboot. After that, it no longer responds (obviously, because it's in controller mode again).
To me, this looks completely wrong. SDC is meant for the device to clear any internal state, but it must not turn the AR488 into a controller again.
Ill side-effect on the ESP32-based hardware: as the communication channel is a CDC (communication device class), the reboot drops the device from the USB, causing anything on the host to disconnect. (This is also the case for `++rst`, but it would be more tolerable there.)

Twilight-Logic, 2025-06-01:
What is talk address 30? It sounds like the interface needs to be in device mode on address 5. What it needs is for the state to be saved (++savecfg) so that when it restarts it in device mode still. Is ++savecfg not saving the configuration parameters?

Not sure what can be done regarding CDC state on restart and that is exactly what ++rst does, but maybe SDC does not need to reboot the device, which I think SDC received in device mode does currently. Will need to think about that one.

dl8dtl, 2025-06-02:
> What is talk address 30?

The spectrum analyzer that's going to emit plot data.

> It sounds like the interface needs to be in device mode on address 5.

It is. Not in a saved configuration, but in the live one.

It would be good to have two different savable addresses for controller and device mode, but that's a different story (in controller mode, I wouldn't want to use address 5).

> Not sure what can be done regarding CDC state on restart and that is exactly what ++rst does, but maybe SDC does not need to reboot the device, which I think SDC received in device mode does currently.

Exactly my point. ;-)

Twilight-Logic, 2025-07-03:
SDC fix is now included in the latest release. It no longer calls rst_h().

Thread 66 (2025-06-20):

error: 'strlcpy' was not declared in this scope

hb9dug, 2025-06-20:
With an unused **Ardino UNO R4 Minima**, I wanted to try out this great AR488 project.
I installed Ardino IDE 2.3.6 and loaded AR488-0.5.11. Unfortunately the check ended with :
Compilation error: “strlcpy” was not declared in this scope._

After searching on the net, it seems that this function is not available on UNO R4...  Continuing my research, I found the code below which I integrated into AR488.ino.

#include <Arduino.h>
// Implementation of strlcpy for Arduino
size_t strlcpy(char *dst, const char *src, size_t dstsize) {
  size_t len = 0;
    // Check if destination size is greater than zero
  if (dstsize > 0) {
    while (src[len] != '\0' && len < dstsize - 1) {
      dst[len] = src[len]; // Copy character
      len++;
    }
    dst[len] = '\0'; // Null-terminate the destination string
  }
  // Calculate the length of the source string
  while (src[len] != '\0') {
    len++;
  }
  return len;
}

Unfortunately, compilation ended with the following error msg:
_...\Temp\ccEdzlwD.s: Assembler messages:
...\Temp\ccEdzlwD.s:36: Error: bad instruction `jmp 0'
...\Temp\ccEdzlwD.s:7388: Error: bad instruction `jmp 0'
exit status 1_

Any help in solving this issue will be welcome.

Best regards, Michel

Twilight-Logic, 2025-06-20:
Thank you for the report.

I installed the R4 library and got the same error regarding strlcpy. In this case, since we are copying a set number of bytes, the function can be replaced with strncpy with a little adjustment. Or, as you have done, you can use a loop to copy the characters. I will update this in the next release.

The `bad instruction jmp 0` error relates to the rst_h function. The function has conditional compilation implemented for the various types of boards, or more specifically for the MCU that it has board. If it doesn't find a match it defaults to the AVR version. However, the R4 has a Renesas RA4M1 ARM processor. I need to find and test the correct reset call for this.

I also found when I did a test compile, that there were errors relating to EEPROM that need to be fixed. I need to read up, but I suspect that although the R4 is classed as an AVR board, it does not have EEPROM in the traditional sense and its likely that saving settings needs to be handled in a file using the LittleFS filesystem like it does on an ESP32. I will update this issue when I have researched these problems and have a working solution.

Twilight-Logic, 2025-06-20:
I think if you add the following after line 1633, it should fix the `bad instruction jmp 0` error:

```
#elif defined(ARDUINO_UNOR4_MINIMA) || defined (ARDUINO_UNOR4_WIFI)
  NVIC_SystemReset();
```
Upon further investigation it seems that the R4 does have EEPROM and the standard Arduino EEPROM library should work. However, I had to add a guard in two places to get a compile. This is the modified default_h function:

```
void default_h(char *params) {
  #if defined(__AVR__) || defined (ESP32)
  if (params != NULL) {
    if (strncasecmp(params, "wipe", 4) == 0) {
      epErase();
      dataPort.println(F("EEPROM erased!"));
    }else{
      errorMsg(2);
    }
  }
  #endif
  gpibBus.setDefaultCfg();
}
```
Then also in AR488_EEPROM.h:

```
#ifndef AR488_EEPROM_H
#define AR488_EEPROM_H

#include "AR488_Config.h"
//#include <EEPROM.h>

/***** AR488_Eeprom.h, ver. 0.01.03, 28/04/2025 *****/

/*
 * EEPROM SIZES:
 *
 * ATmega2560/1284   4096   // Mega 2560, MightyCore 1284
 * ATmega644         2048   // MightyCore 644
 * ATmega328/32u4    1024   // Uno, Nano, Leonardo
 * ATmega168          512
 * ATmega4809         256   // Nano Every
 * ESP8266/ESP32     none   // Emulated. 512kb assigned?
 */

#if defined (__AVR__) || defined (ESP32)

.
.

#endif  // defined (__AVR__) || defined (ESP32)

#endif  // AR488_EEPROM_H
```
I don't have the board to test, but this does at least allow the code to compile.
I would be interested to know whether it works as expected!

Twilight-Logic, 2025-06-20:
BTW, I modified setvstr_h as follows:

```
void setvstr_h(char *params) {
  uint8_t plen = strlen(params);
  char idparams[64];
  const char *vstr = "verstr ";

  if (plen > 47) plen = 47;
  memset(idparams, '\0', 64);
  strncpy(idparams, vstr, 7);
  strncat(idparams, params, plen);

  id_h(idparams);
}
```
I have tested it on my UNO R3, but would appreciate it if you could confirm it works on the UNO R4.

hb9dug, 2025-06-21:
Thank you for your reply.

In sequence, I have :
- modified the setvstr_h function, no more ‘strlcpy’ error but compilation leaves me with the ‘jump 0’ error

- modified AR488.ino and AR488_EEPROM.h, no additional errors, but compilation gives me the ‘jump 0’ error

- in my AR488.ino, line 1633 doesn't make sense, so I inserted the 2 lines here:

void rst_h() {
#ifdef WDTO_1S
  // Where defined, reset controller using watchdog timeout
  unsigned long tout;
  tout = millis() + 2000;
  wdt_enable(WDTO_1S);
  while (millis() < tout) {};
  // Should never reach here....
  if (isVerb) {
    dataPort.println(F("Reset FAILED."));
  };
#elif defined (ESP32)
  ESP.restart();
#elif defined(ARDUINO_ARCH_RP2040)
  rp2040.reboot();
**#elif defined(ARDUINO_UNOR4_MINIMA) || defined (ARDUINO_UNOR4_WIFI)
  NVIC_SystemReset();**
#else
  // Otherwise restart program (soft reset)
  asm volatile ("  jmp 0");
#endif
}

but where **ARDINO_UNOR4_MINIMA** is defined ?

I still tried to compile but without success with 40-50 lines of error...

That's the status of things
Cordialement,
Michel

hb9dug, 2025-06-21:
SUPER as we say in French !  Compiled without a glitch !

All that remains now is to wire an HP-IB connector recovered from an HP instrument chassis.

I'll keep you posted on my work as I go along.

Merci beaucoup !

Cordialement,
Michel

Thread 68 (2025-06-26):

++savecfg not working for ESP32

g-user, 2025-06-26:
++savecfg doesn´t work correctly for 2 reasons:
1.  "E2END" is used as a flag for existing/nonexisting EEPROM, but this is not defined in the ESP32 (emulated) EERPOM library
2.  in the epWriteData/epReadData the variable is a pointer to the buffer (uint8_t cfgdata])  but then "EEPROM.put(addr,cfgdata);" is used for saving the data. So not the buffer is saved but the pointer to the buffer. This is not right. So better use

for (i=0; i<cfgsize; i++){
    EEPROM.write(i+EESTART,cfgdata[i]);

see PR " correct EEPROM read/write for ESP32 #67 "

Twilight-Logic, 2025-06-27:
Thank you for raising this issue. xFunnily enough I was looking at EEPROM last night in conjunction with a Mega 4809 and came across a statement that said that E2END might not be defined for some boards. This had worked in the past. Maybe this changed in Espressif Arduino core3? A lot of things did. In AR488-ESP32, David Douard used the file LittleFS filesystem  instead and wrote the settings to a file which might be a better approach on the ESP.

I am unsure in your second point why EEPROM.put() is saving a pointer instead of the object. The array of uint8_t values is passed by reference (uint8_t cfgdata[]) so EEPROM.put() should be treating this as an array object, which it does for AVR boards. The .put() function is supposed to take care of the iteration. Whatever the case, saving the pointer is indeed not right and needs to be fixed and I guess that manually iterating the array and using .write() to write the individual bytes is the obvious workaround.

g-user, 2025-06-27:
thanks for the fast merge!  I´m pretty sure there are exist more elegant methods for solving this, but it was  the easiest fix (for me).

Closed 2025-06-27.

Thread 71 (2025-07-05):

Communication not working with older devices after 0.52.26

mamut-tme, 2025-07-05:
As discussed in [EEVBlogForum](https://www.eevblog.com/forum/projects/ar488-arduino-based-gpib-adapter/1200/), reply #1216 older instruments seem not to work after version 0.52.26 (commit 82fb8ab). I traced the change to AR488_GPIBbus.cpp, function GPIBbus::setControls:

was:
```
    case CLAS:  // Controller - read data bus
      // Set state for receiving data
      setTransmitMode(TM_RECV);
      clearSignal(ATN_BIT);
#ifdef SN7516X
```

is now:
```
    case CLAS:  // Controller - read data bus
      // Set state for receiving data
      clearSignal(ATN_BIT);
      setTransmitMode(TM_RECV);
#ifdef SN7516X
```

I reversed the order in my copy and suddenly my old (1984, pre 488.2) instrument started communicating again. I don't have the knowledge or data at hand to check how it should be. Can anyone check it?

mamut-tme, 2025-07-13:
Working great, thanks!

Closed 2025-07-13.
