Twilight-Logic/AR488/src/AR488/AR488.ino

//#pragma GCC diagnostic push
//#pragma GCC diagnostic ignored "-Wtype-limits"
//#pragma GCC diagnostic ignored "-Wunused-variable"

#ifdef __AVR__
  #include <avr/wdt.h>
#endif

//#pragma GCC diagnostic pop

#include "AR488_Config.h"
#include "AR488_GPIBbus.h"
#include "AR488_ComPorts.h"
#include "AR488_Eeprom.h"


/***** FWVER "AR488 GPIB controller, ver. 0.53.04, 13/04/2025" *****/

/*
  Arduino IEEE-488 implementation by John Chajecki

  Inspired by the original work of Emanuele Girlando, licensed under a Creative
  Commons Attribution-NonCommercial-NoDerivatives 4.0 International License.
  Any code in common with the original work is reproduced here with the explicit
  permission of Emanuele Girlando, who has kindly reviewed and tested the
  initial version of this project code.

  Thanks also to Luke Mester for comparison testing against the Prologix interface.
  AR488 is Licenced under the GNU Public licence.

  Thanks to 'maxwell3e10' on the EEVblog forum for suggesting additional auto mode
  settings and the macro feature.

  Thanks to 'artag' on the EEVblog forum for providing code for the 32u4.
*/

/*
   Implements most of the CONTROLLER functions;
   Substantially compatible with 'standard' Prologix "++" commands
   (see +savecfg command in the manual for differences)

   Principle of operation:
   - Commands received from USB are buffered and whole terminated lines processed
   - Interface commands prefixed with "++" are passed to the command handler
   - Instrument commands and data not prefixed with '++' are sent directly to the GPIB bus.
   - To receive from the instrument, issue a ++read command or put the controller in auto mode (++auto 1|2)
   - Characters received over the GPIB bus are unbuffered and sent directly to USB
   NOTES:
   - GPIB line in a HIGH state is un-asserted
   - GPIB line in a LOW state is asserted
   - The ATMega processor control pins have a high impedance when set as inputs
   - When set to INPUT_PULLUP, a 10k pull-up (to VCC) resistor is applied to the input
*/


/*
   NOT YET IMPLEMENTED
   ++myaddr   - set the controller address
*/


/*
   For information regarding the GPIB firmware by Emanualle Girlando see:
   http://egirland.blogspot.com/2014/03/arduino-uno-as-usb-to-gpib-controller.html
*/


/*
   Pin mapping between the Arduino pins and the GPIB connector.
   NOTE:
   GPIB pins 10 and 18-24 are connected to GND
   GPIB pin 12 should be connected to the cable shield (might be n/c)
   Pin mapping follows the layout originally used by Emanuelle Girlando, but adds
   the SRQ line (GPIB 10) on pin 2 and the REN line (GPIB 17) on pin 13. The program
   should therefore be compatible with the original interface design but for full
   functionality will need the remaining two pins to be connected.
   For further information about the AR488 see the AR488 Manual. 
*/


/*************************************/
/***** MACRO STRUCTRURES SECTION *****/
/***** vvvvvvvvvvvvvvvvvvvvvvvvv *****/
#ifdef USE_MACROS

/*** DO NOT MODIFY ***/
/*** vvvvvvvvvvvvv ***/

/***** STARTUP MACRO *****/
const char startup_macro[] PROGMEM = {MACRO_0};

/***** Consts holding USER MACROS 1 - 9 *****/
const char macro_1 [] PROGMEM = {MACRO_1};
const char macro_2 [] PROGMEM = {MACRO_2};
const char macro_3 [] PROGMEM = {MACRO_3};
const char macro_4 [] PROGMEM = {MACRO_4};
const char macro_5 [] PROGMEM = {MACRO_5};
const char macro_6 [] PROGMEM = {MACRO_6};
const char macro_7 [] PROGMEM = {MACRO_7};
const char macro_8 [] PROGMEM = {MACRO_8};
const char macro_9 [] PROGMEM = {MACRO_9};


/* Macro pointer array */
const char * const macros[] PROGMEM = {
  startup_macro,
  macro_1,
  macro_2,
  macro_3,
  macro_4,
  macro_5,
  macro_6,
  macro_7,
  macro_8,
  macro_9
};

/*** ^^^^^^^^^^^^^ ***/
/*** DO NOT MODIFY ***/

#endif
/***** ^^^^^^^^^^^^^^^^^^^^ *****/
/***** MACRO CONFIG SECTION *****/
/********************************/



/*******************************/
/***** SERIAL PARSE BUFFER *****/
/***** vvvvvvvvvvvvvvvvvvv *****/
/*
 * Note: Ardiono serial input buffer is 64 
 */
// Serial input parsing buffer
static const uint8_t PBSIZE = 128;
char pBuf[PBSIZE];
uint8_t pbPtr = 0;

/***** ^^^^^^^^^^^^^^^^^^^ *****/
/***** SERIAL PARSE BUFFER *****/
/*******************************/


/**************************/
/***** HELP MESASAGES *****/
/****** vvvvvvvvvvvvv *****/

static const char cmdHelp[] PROGMEM = {
  "addr:P Display/set device address\n"
  "auto:P Automatically request talk and read response\n"
  "clr:P Send Selected Device Clear to current GPIB address\n"
  "eoi:P Enable/disable assertion of EOI signal\n"
  "eor:P Show or set end of receive character(s)\n"
  "eos:P Specify GPIB termination character\n"
  "eot_char:P Set character to append to USB output when EOT enabled\n"
  "eot_enable:P Enable/Disable appending user specified character to USB output on EOI detection\n"
  "help:P This message\n"
  "ifc:P Assert IFC signal for 150 miscoseconds - make AR488 controller in charge\n"
  "llo:P Local lockout - disable front panel operation on instrument\n"
  "loc:P Enable front panel operation on instrument\n"
  "lon:P Put controller in listen-only mode (listen to all traffic)\n"
  "mode:P Set the interface mode (1=controller/0=device)\n"
  "read:P Read data from instrument\n"
  "read_tmo_ms:P Read timeout specified between 1 - 3000 milliseconds\n"
  "rst:P Reset the controller\n"
  "savecfg:P Save configration\n"
  "spoll:P Serial poll the addressed host or all instruments\n"
  "srq:P Return status of srq signal (1-srq asserted/0-srq not asserted)\n"
  "status:P Set the status byte to be returned on being polled (bit 6 = RQS, i.e SRQ asserted)\n"
  "trg:P Send trigger to selected devices (up to 15 addresses)\n"
  "ver:P Display firmware version\n"
  "aspoll:C Serial poll all instruments (alias: ++spoll all)\n"
  "dcl:C Send unaddressed (all) device clear  [power on reset] (is the rst?)\n"
  "default:C Set configuration to controller default settings\n"
  "id:C Show interface ID information - see also: 'id name'; 'id serial'; 'id verstr'\n"
  "id name:C Show/Set the name of the interface\n"
  "id serial:C Show/Set the serial number of the interface\n"
  "id verstr:C Show/Set the version string sent in reply to ++ver e.g. \"GPIB-USB\"). Max 47 chars, excess truncated.\n"
  "idn:C Enable/Disable reply to *idn? (disabled by default)\n"
  "macro:C Run a macro (if macro support is compiled)\n"
  "fndl:C Find listners\n"
  "ppoll:C Conduct a parallel poll\n"
  "ren:C Assert or Unassert the REN signal\n"
  "repeat:C Repeat a given command and return result\n"
  "secread:C Read from a secondary address\n"
  "secsend:C Send data or command to a secondary address\n"
  "setvstr:C DEPRECATED - see id verstr\n"
  "srqauto:C Automatically conduct serial poll when SRQ is asserted\n"
  "tct:C Signal remote device to take control\n"
  "ton:C Put controller in talk-only mode (send data only)\n"
  "unl:C Unlisten the GPIB bus\n"
  "unt:C Untalk the GPIB bus"
  "verbose:C Verbose (human readable) mode\n"
  "xdiag:C Bus diagnostics (see the doc)\n"
};

/***** ^^^^^^^^^^^^^ *****/
/***** HELP MESSAGES *****/
/*************************/



/************************************/
/***** COMMON VARIABLES SECTION *****/
/***** vvvvvvvvvvvvvvvvvvvvvvvv *****/

/****** Process status values *****/
#define OK 0
#define ERR 1

/***** Control characters *****/
#define ESC  0x1B   // the USB escape char
#define CR   0xD    // Carriage return
#define LF   0xA    // Newline/linefeed
#define PLUS 0x2B   // '+' character

/****** Global variables with volatile values related to controller state *****/

// GPIB bus object
GPIBbus gpibBus;

// GPIB control state
//uint8_t cstate = 0;

// Verbose mode
bool isVerb = false;

// CR/LF terminated line ready to process
uint8_t lnRdy = 0;      

// GPIB data receive flags
bool autoRead = false;              // Auto reading (auto mode 3) GPIB data in progress
bool readWithEoi = false;           // Read eoi requested
bool readWithEndByte = false;       // Read with specified terminator character
bool isQuery = false;               // Direct instrument command is a query
// uint8_t tranBrk = 0;                // Transmission break on 1=++, 2=EOI, 3=ATN 4=UNL
uint8_t endByte = 0;                // Termination character
bool isProm = false;                // Promiscuous mode flag
bool isSpoll = false;               // Serial poll flag

// Escaped character flag
bool isEsc = false;           // Charcter escaped
bool isPlusEscaped = false;   // Plus escaped

// Read only mode flag
bool isRO = false;

// Talk only mode flag
uint8_t isTO = 0;

// Data send mode flags
bool dataBufferFull = false;    // Flag when parse buffer is full

// SRQ auto mode
bool isSrqa = false;

// Whether to run Macro 0 (macros must be enabled)
uint8_t runMacro = 0;

// Send response to *idn?
bool sendIdn = false;

/***** ^^^^^^^^^^^^^^^^^^^^^^^^ *****/
/***** COMMON VARIABLES SECTION *****/
/************************************/



/*******************************/
/***** COMMON CODE SECTION *****/
/***** vvvvvvvvvvvvvvvvvvv *****/


/******  Arduino standard SETUP procedure *****/
void setup() {

  // Disable the watchdog (needed to prevent WDT reset loop)
#ifdef __AVR__
  wdt_disable();
#endif

  // Turn off internal LED (set OUPTUT/LOW) - Arduinos have a separate power LED
#ifdef LED_BUILTIN
  pinMode(LED_BUILTIN, OUTPUT);
  digitalWrite(LED_BUILTIN, LOW);
#endif

// For RPI we turn on the built-in LED as a power indicator
#ifdef ARDUINO_ARCH_RP2040
  pinMode(LED_BUILTIN, OUTPUT);
  digitalWrite(LED_BUILTIN, HIGH);
#endif

#ifdef REMOTE_SIGNAL_PIN
  pinMode(REMOTE_SIGNAL_PIN, OUTPUT);
  digitalWrite(REMOTE_SIGNAL_PIN, LOW);
#endif


  // Initialise parse buffer
  flushPbuf();

  // Initialise serial at the configured baud rate
  AR_SERIAL_PORT.begin(AR_SERIAL_SPEED);

#ifdef DEBUG_ENABLE
  // Initialise debug port
  DB_SERIAL_PORT.begin(DB_SERIAL_SPEED);
#endif

#ifdef AR_SERIAL_BT_ENABLE
  // If enabled, initialise Bluetooth
  /* If its the same interface as AR_SERIAL_PORT then there will be
   * some disruption while the function auto-detects the HC05 baud
   * rate and configures the HC05. Once this is done, AR_SERIAL_PORT
   * will be set back to the configured baud rate.
   */
  btInit();
#endif

  // Using MCP23S17 (SPI) expander chip
#ifdef AR488_MCP23S17
  // Ensure the Arduino MCP select pin is set as an OUPTPUT and is HIGH
  pinMode(MCP_SELECTPIN, OUTPUT);
  digitalWrite(MCP_SELECTPIN, HIGH);
  // Enable SPI and initialise the MCP chip
//Serial.println(F("Starting SPI..."));
  mcpInit();
  // Attach interrupt handler to Arduino board pin to receive MCP23S17 interrupt
  attachInterrupt(digitalPinToInterrupt(MCP_INTERRUPT), mcpIntHandler, FALLING);
//Serial.println(F("SPI started."));
#endif


// Un-comment for diagnostic purposes
/* 
  #if defined(__AVR_ATmega32U4__)
    while(!AR_SERIAL_PORT)
    ;
//    dataport.print(F("Starting "));
    for(int i = 0; i < 20; ++i) {  // this gives you 10 seconds to start programming before it crashes
      dataport.print(".");
      delay(500);
    }
    dataport.println("@>");
  #endif // __AVR_ATmega32U4__
*/
// while(!AR_SERIAL_PORT);
// Un-comment for diagnostic purposes

  // Read config from EEPROM
#ifdef E2END
//  DB_RAW_PRINTLN(F("EEPROM detected!"));
  // Read data from non-volatile memory
  //(will only read if previous config has already been saved)
  if (!isEepromClear()) {
//DB_RAW_PRINTLN(F("EEPROM has data."));
    if (!epReadData(gpibBus.cfg.db, GPIB_CFG_SIZE)) {
      // CRC check failed - config data does not match EEPROM
//DB_RAW_PRINTLN(F("CRC check failed. Erasing EEPROM...."));
      epErase();
      gpibBus.setDefaultCfg();
      epWriteData(gpibBus.cfg.db, GPIB_CFG_SIZE);
//DB_RAW_PRINTLN(F("EEPROM data set to default."));
    }
  }
#endif

  // SN7516x IC support
#ifdef SN7516X
  pinMode(SN7516X_TE, OUTPUT);
  #ifdef SN7516X_DC
    pinMode(SN7516X_DC, OUTPUT);
  #endif
  if (gpibBus.cfg.cmode==2) {
    // Set controller mode on SN75161/2
    digitalWrite(SN7516X_TE, LOW);
    #ifdef SN7516X_DC 
      digitalWrite(SN7516X_DC, LOW);
    #endif
    #ifdef SN7516X_SC
      digitalWrite(SN7516X_SC, HIGH);
    #endif
  }else{
    // Set listen mode on SN75161/2 (default)
    digitalWrite(SN7516X_TE, HIGH);
    #ifdef SN7516X_DC
      digitalWrite(SN7516X_DC, HIGH);
    #endif
    #ifdef SN7516X_SC
      digitalWrite(SN7516X_SC, LOW);
  bool eoiDetected = false;
    #endif
  }
#endif

  // Start the interface in the configured mode
  gpibBus.begin();
  if (gpibBus.cfg.hflags == 0xFF) gpibBus.cfg.hflags = 0;

#if defined(USE_MACROS) && defined(RUN_STARTUP)
  // Run startup macro
  execMacro(0);
#endif

#ifdef SAY_HELLO
  dataPort.print(F("AR488 ready "));
  if (gpibBus.isController()){
    dataPort.println(F("(controller)."));
  }else{
    dataPort.println(F("(device)."));
  }
#endif

  if (gpibBus.cfg.hflags & 0x01) dataPort.print(F("AR488~RDY"));

  dataPort.flush();

}
/****** End of Arduino standard SETUP procedure *****/


/***** ARDUINO MAIN LOOP *****/
void loop() {

  bool errFlg = false; 

/*** Macros ***/
/*
 * Run the startup macro if enabled
 */
#ifdef USE_MACROS
  // Run user macro if flagged
  if (runMacro > 0) {
    execMacro(runMacro);
    runMacro = 0;
  }
#endif


/*** Process the buffer ***/
/* Each received char is passed through parser until an un-escaped 
 * CR is encountered. If we have a command then parse and execute.
 * If the line is data (inclding direct instrument commands) then
 * send it to the instrument.
 * NOTE: parseInput() sets lnRdy in serialEvent, readBreak or in the
 * above loop
 * lnRdy=1: process command;
 * lnRdy=2: send data to Gpib
 */

/*
if (lnRdy>0){
  dataPort.print(F("lnRdy1: "));
  dataPort.println(lnRdy);
}
*/

  // lnRdy=1: received a command so execute it...
  if (lnRdy == 1) {
    if (autoRead) {
      // Issuing any command stops autoread mode
      autoRead = false;
      gpibBus.unAddressDevice();
    }
    execCmd(pBuf, pbPtr);
  }

  // Controller mode:
  if (gpibBus.isController()) {
    // lnRdy=2: received data - send it to the instrument...
    if (lnRdy == 2) {

      sendToInstrument(pBuf, pbPtr);

      // Auto-read data from GPIB bus following any command
      if (gpibBus.cfg.amode == 1) {
        gpibBus.addressDevice(gpibBus.cfg.paddr, gpibBus.cfg.saddr, TOTALK);
        errFlg = gpibBus.receiveData(dataPort, gpibBus.cfg.eoi, false, 0);
        gpibBus.unAddressDevice();
      }

      // Auto-receive data from GPIB bus following a query command
      if (gpibBus.cfg.amode == 2 && isQuery) {
        gpibBus.addressDevice(gpibBus.cfg.paddr, gpibBus.cfg.saddr, TOTALK);
        errFlg = gpibBus.receiveData(dataPort, gpibBus.cfg.eoi, false, 0);
        isQuery = false;
        gpibBus.unAddressDevice();
      }

    }

    // Continuous auto-receive data from GPIB bus
    if ((gpibBus.cfg.amode==3) && autoRead) {
      // Nothing is waiting on the serial input so read data from GPIB
      if (lnRdy==0) {
        if (gpibBus.haveAddressedDevice() == TONONE) gpibBus.addressDevice(gpibBus.cfg.paddr, gpibBus.cfg.saddr, TOTALK);
        errFlg = gpibBus.receiveData(dataPort, readWithEoi, readWithEndByte, endByte);
      }
    }

    // Automatic serial poll (check status of SRQ and SPOLL if asserted)?
    if (isSrqa) {
      if (gpibBus.isAsserted(SRQ_PIN)) spoll_h(NULL);
    }

    // Did we get an error during read?
    if (errFlg && isVerb) {
      dataPort.println(F("Error while receiving data."));
      errFlg = false;
    }
  }

  // Device mode:
  if (gpibBus.isController()==false) {
    if (isTO>0) {
//      if (lnRdy == 2) sendToInstrument(pBuf, pbPtr);
      tonMode();
    }else if (isRO) {
      lonMode();
    }else if (gpibBus.isAsserted(ATN_PIN)) {
      attnRequired();
    }

    // Can't send in LON mode so just clear the buffer
    if (isProm) {
      if (lnRdy == 2) flushPbuf();
    }
  }

  // Reset line ready flag
//  lnRdy = 0;

  // IDN query ?
  if (sendIdn) {
    if (gpibBus.cfg.idn==1) dataPort.println(gpibBus.cfg.sname);
    if (gpibBus.cfg.idn==2) {dataPort.print(gpibBus.cfg.sname);dataPort.print("-");dataPort.println(gpibBus.cfg.serial);}
    sendIdn = false;
  }

/*
if (lnRdy>0){
  dataPort.print(F("lnRdy2: "));
  dataPort.println(lnRdy);
}
*/

  // If charaters waiting in the serial input buffer then call handler
  if (dataPort.available()) lnRdy = serialIn_h();

  delayMicroseconds(5);
}
/***** END MAIN LOOP *****/



/***** Initialise device mode *****/
void initDevice() {
  gpibBus.stop();
  gpibBus.startDeviceMode();
}


/***** Initialise controller mode *****/
void initController() {
  gpibBus.stop();
  gpibBus.startControllerMode();
}


/***** Serial event handler *****/
/*
 * Note: the Arduino serial buffer is 64 characters long. Characters are stored in
 * this buffer until serialEvent_h() is called. parsedInput() takes a character at 
 * a time and places it into the 256 character parse buffer whereupon it is parsed
 * to determine whether a command or data are present.
 * lnRdy=0: terminator not detected yetloop
 * lnRdy=1: terminator detected, sequence in parse buffer is a ++ command
 * lnRdy=2: terminator detected, sequence in parse buffer is data or direct instrument command
 */ 
uint8_t serialIn_h() {
  uint8_t bufferStatus = 0;
  // Parse serial input until we have detected a line terminator
  while (dataPort.available() && bufferStatus==0) {   // Parse while characters available and line is not complete
    bufferStatus = parseInput(dataPort.read());
  }

#ifdef DEBUG_SERIAL_INPUT
  if (bufferStatus) {
    DB_PRINT(F("bufferStatus: "), bufferStatus);
  }
#endif

  return bufferStatus;
}


/*************************************/
/***** Device operation routines *****/
/*************************************/


/***** Unrecognized command *****/
/***** Command errors *****/
void errorMsg(uint8_t err) {
  switch (err) {
    case 1:
      dataPort.println(F("Missing parameter"));
      break;
    case 2:
      dataPort.println(F("Invalid parameter"));
      break;
    case 3:
      dataPort.println(F("Transmit failed!"));
      break;
    default:
      dataPort.println(F("Unrecognized command"));
  }
}


/***** Add character to the buffer and parse *****/
uint8_t parseInput(char c) {

  uint8_t r = 0;

  // Read until buffer full
  if (pbPtr < PBSIZE) {
    if (isVerb && c!=LF) dataPort.print(c);  // Humans like to see what they are typing...
    // Actions on specific characters
    switch (c) {
      // Carriage return or newline? Then process the line
      case CR:
      case LF:
        // If escaped add char 0x10 or 0x13 to buffer and clear Escape flag
        if (isEsc) {
          addPbuf(c);
          isEsc = false;
        } else {
          // Carriage return on blank line?
          // Note: for data CR and LF will always be escaped
          if (pbPtr == 0) {
            flushPbuf();
            if (isVerb) {
              dataPort.println();
              showPrompt();
            }
            return 0;
          } else {
#ifdef DEBUG_SERIAL_INPUT
            DB_PRINT(F("parseInput: Received "), pBuf);
#endif
            // Buffer starts with ++ and contains at least 3 characters - command?
            if (pbPtr>2 && isCmd(pBuf) && !isPlusEscaped) {
              // Exclamation mark (break read loop command)
              if (pBuf[2]==0x21) {
                r = 3;
                flushPbuf();
              // Otherwise flag command received and ready to process 
              }else{
                r = 1;
              }
            // Buffer contains *idn? query and interface to respond
            }else if (pbPtr>3 && gpibBus.cfg.idn>0 && isIdnQuery(pBuf)){
              sendIdn = true;
              flushPbuf();
            // Buffer has at least 1 character = instrument data to send to gpib bus
            }else if (pbPtr > 0) {
              r = 2;
            }
            isPlusEscaped = false;
#ifdef DEBUG_SERIAL_INPUT
            DB_PRINT(F("R: "), r);
#endif
//            return r;
          }
        }
        break;
      case ESC:
        // Handle the escape character
        if (isEsc) {
          // Add character 0x27 to buffer and clear Escape flag
          addPbuf(c);
          isEsc = false;
        } else {
          // Flag that we have seen an Escape character
          isEsc  = true;
        }
        break;
      case PLUS:
        if (isEsc) {
          isEsc = false;
          if (pbPtr < 2) isPlusEscaped = true;
        }
        addPbuf(c);
//        if (isVerb) dataPort.print(c);
        break;
      // Something else?
      default: // any char other than defined above
        addPbuf(c);
        isEsc = false;
    }
  }
  if (pbPtr >= PBSIZE) {
    if (isCmd(pBuf) && !r) {  // Command without terminator and buffer full
      if (isVerb) {
        dataPort.println(F("ERROR - Command buffer overflow!"));
      }
      flushPbuf();
    }else{  // Buffer contains data and is full, so process the buffer (send data via GPIB)
      dataBufferFull = true;
      // Signal to GPIB object that more data will follow (suppress GPIB addressing)
      r = 2;
    }
  }
  return r;
}


/***** Is this a command? *****/
bool isCmd(char *buffr) {
  if (buffr[0] == PLUS && buffr[1] == PLUS) {
#ifdef DEBUG_SERIAL_INPUT
    DB_PRINT(F("Command detected."), "");
#endif
    return true;
  }
  return false;
}


/***** Is this an *idn? query? *****/
bool isIdnQuery(char *buffr) {
  // Check for upper or lower case *idn?
  if (strncasecmp(buffr, "*idn?", 5)==0) {
#ifdef DEBUG_SERIAL_INPUT
    DB_PRINT(F("isIdnQuery: Detected IDN query."),"");
#endif
    return true;
  }
  return false;
}


/***** ++read command detected? *****/
bool isRead(char *buffr) {
  char cmd[4];
  // Copy 2nd to 5th character
  for (int i = 2; i < 6; i++) {
    cmd[i - 2] = buffr[i];
  }
  // Compare with 'read'
  if (strncmp(cmd, "read", 4) == 0) return true;
  return false;
}


/***** Is the parameter a number *****/
bool isNumber(char *numstr){
  uint8_t numlen = strlen(numstr);
  for (uint8_t i=0; i<numlen; i++){
    if (numstr[i]<48 || numstr[i]>57) return false;
  }
  return true;
}


/***** Add character to the buffer *****/
void addPbuf(char c) {
  pBuf[pbPtr] = c;
  pbPtr++;
}


/***** Clear the parse buffer *****/
void flushPbuf() {
  memset(pBuf, '\0', PBSIZE);
  pbPtr = 0;
}


/***** Comand function record *****/
struct cmdRec { 
  const char* token; 
  int opmode;
  void (*handler)(char *);
};


/***** Array containing index of accepted ++ commands *****/
/*
 * Commands without parameters require casting to a pointer
 * requiring a char* parameter. The functon is called with
 * NULL by the command processor.
 * 
 * Format: token, mode, function_ptr
 * Mode: 1=device; 2=controller; 3=both; 
 */
static cmdRec cmdHidx [] = { 
 
  { "addr",        3, addr_h      }, 
  { "allspoll",    2, (void(*)(char*)) aspoll_h  },
  { "auto",        2, amode_h     },
  { "clr",         2, (void(*)(char*)) clr_h     },
  { "dcl",         2, (void(*)(char*)) dcl_h     },
  { "default",     3, (void(*)(char*)) default_h },
  { "eoi",         3, eoi_h       },
  { "eor",         3, eor_h       },
  { "eos",         3, eos_h       },
  { "eot_char",    3, eot_char_h  },
  { "eot_enable",  3, eot_en_h    },
  { "flags",       2, hflags_h    },
  { "fndl",        2, fndl_h      },
  { "help",        3, help_h      },
  { "ifc",         2, (void(*)(char*)) ifc_h     },
  { "id",          3, id_h        },
  { "idn",         3, idn_h       },
  { "llo",         2, llo_h       },
  { "loc",         2, loc_h       },
  { "lon",         1, lon_h       },
  { "macro",       2, macro_h     },
  { "mode" ,       3, cmode_h     },
  { "ppoll",       2, (void(*)(char*)) ppoll_h   },
  { "prom",        1, prom_h      },
  { "read",        2, read_h      },
  { "read_tmo_ms", 2, rtmo_h      },
  { "ren",         2, ren_h       },
  { "repeat",      2, repeat_h    },
  { "rst",         3, (void(*)(char*)) rst_h     },
  { "trg",         2, trg_h       },
  { "savecfg",     3, (void(*)(char*)) save_h    },
//  { "secread",     2, secread_h   },
  { "send",        2, send_h      },
  { "setvstr",     3, setvstr_h   },
  { "spoll",       2, spoll_h     },
  { "srq",         2, (void(*)(char*)) srq_h     },
  { "srqauto",     2, srqa_h      },
  { "status",      1, stat_h      },
  { "tct",         2, tct_h       },
  { "ton",         1, ton_h       },
  { "unl",         2, (void(*)(char*)) unlisten_h  },
  { "unt",         2, (void(*)(char*)) untalk_h    },
  { "ver",         3, ver_h       },
  { "verbose",     3, (void(*)(char*)) verb_h    },
  { "xdiag",       3, xdiag_h     }
};


/***** Show a prompt *****/
void showPrompt() {
  // Print a prompt
  dataPort.print("> ");
}


/****** Send data to instrument *****/
/* Processes the parse buffer when full or CR/LF detected
 * and sends data to the instrument
 */
void sendToInstrument(char *buffr, uint8_t dsize) {

#ifdef DEBUG_SEND_TO_INSTR
  if (buffr[dsize] != LF) DB_RAW_PRINTLN();
  DB_HEXB_PRINT(F("Received for sending: "), buffr, dsize);
#endif

  // Is this an instrument query command (string ending with ?)
  if (buffr[dsize-1] == '?') isQuery = true;

  if (gpibBus.isController()) {
    // Has controller already addressed the device? - if not then address it
    if (gpibBus.haveAddressedDevice() != TOLISTEN) gpibBus.addressDevice(gpibBus.cfg.paddr, gpibBus.cfg.saddr, TOLISTEN);
  }

  // Send string to instrument
  gpibBus.sendData(buffr, dsize);

  // If controller then unaddress devicesendTo
  if (gpibBus.isController() &&  dataBufferFull == false) {
    gpibBus.unAddressDevice();
  }

  // Clear buffer full flag
  if (dataBufferFull) dataBufferFull = false;

#ifdef DEBUG_SEND_TO_INSTR
  DB_PRINT(F("done."),"");
#endif

  // Show handshake flag
  if (gpibBus.cfg.hflags & 0x04) dataPort.println("Send^OK");

  // Show a prompt on completion?
  if (isVerb) showPrompt();

  // Flush the parse buffer
  flushPbuf();
  lnRdy = 0;
}


/***** Execute a command *****/
void execCmd(char *buffr, uint8_t dsize) {

#ifdef DEBUG_CMD_PARSER
  DB_HEXB_PRINT(F("command received: "), buffr, dsize);
#endif

  // Its a ++command so shift everything two bytes left (ignore ++) and parse
  for (int i = 0; i < dsize-2; i++) {
    buffr[i] = buffr[i + 2];
  }
  
  // Replace last two bytes with a null (\0) character
  buffr[dsize - 2] = '\0';
  buffr[dsize - 1] = '\0';

#ifdef DEBUG_CMD_PARSER
  DB_HEXB_PRINT(F("sent to command processor: "), buffr, dsize-2);
#endif

  // Execute the command
  if (isVerb) dataPort.println();
  getCmd(buffr);

  // Flush the parse buffer and clear ready flag
  flushPbuf();
  lnRdy = 0;

  // Show a prompt on completion?
  if (isVerb) showPrompt();
}


/***** Extract command and pass to handler *****/
void getCmd(char *buffr) {

  char *token;  // Pointer to command token
  char *params; // Pointer to parameters (remaining buffer characters)
  
  int casize = sizeof(cmdHidx) / sizeof(cmdHidx[0]);
  int i = 0;

#ifdef DEBUG_CMD_PARSER
  DB_PRINT(F("command buffer: "), buffr);
  DB_PRINT(F("buffer length: "), strlen(buffr));
#endif

  // If terminator on blank line then return immediately without processing anything 
  if (buffr[0] == 0x00) return;
  if (buffr[0] == CR) return;
  if (buffr[0] == LF) return;

  // Get the first token
  token = strtok(buffr, " \t");

#ifdef DEBUG_CMD_PARSER
  DB_PRINT(F("process token: "), token);
#endif

  // Check whether it is a valid command token
  i = 0;
  do {
    if (strcasecmp(cmdHidx[i].token, token) == 0) break;
    i++;
  } while (i < casize);

  if (i < casize) {
    // We have found a valid command and handler
#ifdef DEBUG_CMD_PARSER
    DB_PRINT(F("found handler for: "), cmdHidx[i].token);
#endif
    // If command is relevant to mode then execute it
    if (cmdHidx[i].opmode & gpibBus.cfg.cmode) {
      // If its a command with parameters
      // Copy command parameters to params and call handler with parameters
      params = token + strlen(token) + 1;
  
      // If command parameters were specified
      if (strlen(params) > 0) {
#ifdef DEBUG_CMD_PARSER
        DB_PRINT(F("calling handler with parameters: "), params);
#endif
        // Call handler with parameters specified
        cmdHidx[i].handler(params);
      }else{
#ifdef DEBUG_CMD_PARSER
        DB_PRINT(F("calling handler without parameters..."),"");
#endif
        // Call handler without parameters
        cmdHidx[i].handler(NULL);
      }
#ifdef DEBUG_CMD_PARSER
      DB_PRINT(F("handler done."),"");
#endif
    }else{
      errorMsg(0);
      if (isVerb) dataPort.println(F("getCmd: command not available in this mode."));
    }
  } else {
    // No valid command found
    errorMsg(0);
  }
 
}


/***** Prints charaters as heatoix bytes *****/
/*
void printHex(char *buffr, int dsize) {
#ifdef DEBUG_ENABLE
  for (int i = 0; i < dsize; i++) {
    debugStream.print(buffr[i], HEX); debugStream.print(" ");
  }
  debugStream.println();
#endif
}
*/

/***** Check whether a parameter is in range *****/
/* Convert string to integer and check whether value is within
 * lowl to higl inclusive. Also returns converted text in param
 * to a uint16_t integer in rval. Returns true if successful, 
 * false if not
*/
/*
bool notInRange(char *param, uint16_t lowl, uint16_t higl, uint16_t &rval) {

  // Null string passed?
  if (strlen(param) == 0) return true;

  // Convert to integer
  rval = 0;

  // Param contains digits only ?
  if (isNumber(param)) {
    rval = atoi(param);
  }else{
    return false;
  }

  // Check range
  if (rval < lowl || rval > higl) {
    errorMsg(2);
    if (isVerb) {
      dataPort.print(F("Valid range is between "));
      dataPort.print(lowl);
      dataPort.print(F(" and "));
      dataPort.println(higl);
    }
    return true;
  }
  return false;
}
*/


bool notInRange(char *param, uint16_t lowl, uint16_t higl, uint16_t &rval) {

  unsigned long val = 0;

  // Null string passed?
  if (strlen(param) == 0) return true;

  // Is it numeric ?
  if (!isNumber(param)) return true;

  // Convert
  val = strtoul(param, NULL, 10);

  // Check range
  if (val < lowl || val > higl) {
    errorMsg(2);
    if (isVerb) {
      dataPort.print(F("Valid range is between "));
      dataPort.print(lowl);
      dataPort.print(F(" and "));
      dataPort.println(higl);
    }
    return true;
  }
  rval = (uint16_t)val;
  return false;
}


/***** If enabled, executes a macro *****/
#ifdef USE_MACROS
void execMacro(uint8_t idx) {
  char c;
  const char * macro = pgm_read_word(macros + idx);
  int ssize = strlen_P(macro);

  // Read characters from macro character array
  for (int i = 0; i < ssize; i++) {
    c = pgm_read_byte_near(macro + i);
    if (c == CR || c == LF || i == (ssize - 1)) {
      // Reached terminator or end of marcro. Add to buffer before processing
      if (i == ssize-1) {
        // Check buffer and add character
        if (pbPtr < (PBSIZE - 1)){
          if ((c != CR) && (c != LF)) addPbuf(c);
        }else{
          // Buffer full - clear and exit
          flushPbuf();
          return;
        }
      }
      if (isCmd(pBuf)){
        execCmd(pBuf, strlen(pBuf));
      }else{
        sendToInstrument(pBuf, strlen(pBuf));
      }
      // Done - clear the buffer
      flushPbuf();
    } else {
      // Check buffer and add character
      if (pbPtr < (PBSIZE - 1)) {
        addPbuf(c);
      } else {
        // Exceeds buffer size - clear buffer and exit
        i = ssize;
        return;
      }
    }
  }

  // Clear the buffer ready for serial input
  flushPbuf();
}
#endif


/*************************************/
/***** STANDARD COMMAND HANDLERS *****/
/*************************************/


/***** Show or change device address *****/
void addr_h(char *params) {
  char *param;
  uint16_t val;
  uint8_t saddr;
  if (params != NULL) {

    // Primary address
    param = strtok(params, ", \t");
    if (!isNumber(param)){
      errorMsg(2);
      return;
    }
    if (notInRange(param, 0, 30, val)) return;
    if (val == gpibBus.cfg.caddr) {
      errorMsg(2);
      if (isVerb) dataPort.println(F("Cannot address the controller!"));
      return;
    }
    gpibBus.cfg.paddr = val;

    // Secondary address
    gpibBus.cfg.saddr = 0xFF; // Default
    param = strtok(NULL, ", \t");
//    Serial.println(param);
    if (param != NULL) {
      if (isNumber(param)){
        saddr = atoi(param);
      }else{
        errorMsg(2);
        return;
      }
      if (saddr<31) saddr += 0x60;
      if (saddr<96 && saddr>126) {
        errorMsg(2);
        return;
      }
      gpibBus.cfg.saddr = saddr;
    }

    if (isVerb) {
      dataPort.print(F("PRI address set to: "));
      dataPort.println(gpibBus.cfg.paddr);
      dataPort.print(F("SEC address set to: "));
      if (gpibBus.cfg.saddr == 0xFF) {
        dataPort.println(F("unset"));
      }else{
        dataPort.println(gpibBus.cfg.saddr);
      }
    }

  } else {
    dataPort.print(gpibBus.cfg.paddr);
    if (gpibBus.cfg.saddr != 0xFF) {
      dataPort.print(',');
      dataPort.print(gpibBus.cfg.saddr);
    }
    dataPort.println();
  }
}


/***** Show or set read timout *****/
void rtmo_h(char *params) {
  uint16_t val;
  if (params != NULL) {
    if (notInRange(params, 1, 32000, val)) return;
    gpibBus.cfg.rtmo = val;
    if (isVerb) {
      dataPort.print(F("Set [read_tmo_ms] to: "));
      dataPort.print(val);
      dataPort.println(F(" milliseconds"));
    }
  } else {
    dataPort.println(gpibBus.cfg.rtmo);
  }
}


/***** Show or set end of send character *****/
void eos_h(char *params) {
  uint16_t val;
  if (params != NULL) {
    if (notInRange(params, 0, 3, val)) return;
    gpibBus.cfg.eos = (uint8_t)val;
    if (isVerb) {
      dataPort.print(F("Set EOS to: "));
      dataPort.println(val);
    };
  } else {
    dataPort.println(gpibBus.cfg.eos);
  }
}


/***** Show or set EOI assertion on/off *****/
void eoi_h(char *params) {
  uint16_t val;
  if (params != NULL) {
    if (notInRange(params, 0, 1, val)) return;
    gpibBus.cfg.eoi = val ? true : false;
    if (isVerb) {
      dataPort.print(F("Set EOI assertion: "));
      dataPort.println(val ? "ON" : "OFF");
    };
  } else {
    dataPort.println(gpibBus.cfg.eoi);
  }
}


/***** Show or set interface to controller/device mode *****/
void cmode_h(char *params) {
  uint16_t val;
  if (params != NULL) {
    if (notInRange(params, 0, 1, val)) return;
    switch (val) {
      case 0:
        gpibBus.startDeviceMode();
        break;
      case 1:
        gpibBus.startControllerMode();
        break;
    }
    if (isVerb) {
      dataPort.print(F("Interface mode set to: "));
      dataPort.println(val ? "CONTROLLER" : "DEVICE");
    }
  } else {
    dataPort.println(gpibBus.isController());
  }
}


/***** Show or enable/disable sending of end of transmission character *****/
void eot_en_h(char *params) {
  uint16_t val;
  if (params != NULL) {
    if (notInRange(params, 0, 1, val)) return;
    gpibBus.cfg.eot_en = val ? true : false;
    if (isVerb) {
      dataPort.print(F("Appending of EOT character: "));
      dataPort.println(val ? "ON" : "OFF");
    }
  } else {
    dataPort.println(gpibBus.cfg.eot_en);
  }
}


/***** Show or set end of transmission character *****/
void eot_char_h(char *params) {
  uint16_t val;
  if (params != NULL) {
    if (notInRange(params, 0, 255, val)) return;
    gpibBus.cfg.eot_ch = (uint8_t)val;
    if (isVerb) {
      dataPort.print(F("EOT set to ASCII character: "));
      dataPort.println(val);
    };
  } else {
    dataPort.println(gpibBus.cfg.eot_ch, DEC);
  }
}


/***** Show or enable/disable auto mode *****/
void amode_h(char *params) {
  uint16_t val;
  if (params != NULL) {
    if (notInRange(params, 0, 3, val)) return;
    if (val > 0 && isVerb) {
      dataPort.println(F("WARNING: automode ON can cause some devices to generate"));
      dataPort.println(F("         'addressed to talk but nothing to say' errors"));
    }
    gpibBus.cfg.amode = (uint8_t)val;
    if (gpibBus.cfg.amode < 3) autoRead = false;
    if (isVerb) {
      dataPort.print(F("Auto mode: "));      // 3rd parameter
      dataPort.println(gpibBus.cfg.amode);
    }
  } else {
    dataPort.println(gpibBus.cfg.amode);
  }
}


/***** Display the controller version string *****/
void ver_h(char *params) {
  // If "real" requested
  if (params != NULL && strncasecmp(params, "real", 3) == 0) {
    dataPort.println(F(FWVER));
    // Otherwise depends on whether we have a custom string set
  } else {
    if (strlen(gpibBus.cfg.vstr) > 0) {
      dataPort.println(gpibBus.cfg.vstr);
    } else {
      dataPort.println(F(FWVER));
    }
  }
}


/***** Address device to talk and read the sent data *****/
void read_h(char *params) {
  uint8_t maxparam = 3;
  uint8_t pcnt = 0;
  uint8_t pri = gpibBus.cfg.paddr;
  uint8_t sec = gpibBus.cfg.saddr;
  uint16_t val = 0xFF;
  char * param;
  // Clear read flagshaveAddressed
  readWithEoi = false;
  readWithEndByte = false;
  endByte = 0;

  // Read any parameters
  if (params != NULL) {

    // 1st parameter ( eoi, terminator character or address value ? )
    param = strtok(params, " ,\t");
    if (isNumber(param)) {
      // Primary address in range ?
      val = strtoul(param, NULL, 10);
      if (val>30) {
        errorMsg(2);
        return;
      }
      pri = (uint8_t)val;

      // 2nd parameter ( * or address value )
      param = strtok(NULL, " ,\t");
      if (isNumber(param)) {
        val = strtoul(param, NULL, 10);
        if (val<31) val = val + 0x60;
        if (val<0x60 || val>0x7E) {
          errorMsg(2);
          return;
        }
        sec = (uint8_t)val;

        // 3rd parameter
        param = strtok(NULL, " ,\t");

      }else{
        sec = 0xFF;
      }

    }
    
    // Check for eoi or terminator character
    if (strlen(param) > 3) {
      errorMsg(2);
      return;
    } else if (strncasecmp(params, "eoi", 3) == 0) { // Read with eoi detection
      readWithEoi = true;
    } else { // Assume ASCII character given and convert to an 8 bit byte
      readWithEndByte = true;
      endByte = atoi(param);
    }
  }

//DB_PRINT(F("readWithEoi:     "), readWithEoi);
//DB_PRINT(F("readWithEndByte: "), readWithEndByte);

  // Address device to talk
  if (gpibBus.haveAddressedDevice() != TOTALK) gpibBus.addressDevice(pri, sec, TOTALK);

  // Read data
  if (gpibBus.cfg.amode == 3) {
    // In auto continuous mode we set this flag to indicate we are ready for continuous read
    autoRead = true;
  } else {
    // If auto mode is disabled we do a single read
    gpibBus.receiveData(dataPort, readWithEoi, readWithEndByte, endByte);
    gpibBus.unAddressDevice();
    if ( !autoRead && (gpibBus.cfg.hflags & 0x02) ) dataPort.println(F("Read^OK"));
  }
}


/***** Send device clear (usually resets the device to power on state) *****/
void clr_h() {
  if (gpibBus.sendSDC())  {
    if (isVerb) dataPort.println(F("Failed to send SDC"));
    return;
  }
  // Set GPIB controls back to idle state
  gpibBus.setControls(CIDS);
}


/***** Send local lockout command *****/
void llo_h(char *params) {
  // NOTE: REN *MUST* be asserted (LOW)
  if (digitalRead(REN_PIN)==LOW) {
    // For 'all' send LLO to the bus without addressing any device
    // Devices will show REM as soon as they are addressed and need to be released with LOC
    if (params != NULL) {
      if (0 == strncmp(params, "all", 3)) {
        if (gpibBus.sendCmd(GC_LLO)) {
          if (isVerb) dataPort.println(F("Failed to send universal LLO."));
        }
      }
    } else {
      // Send LLO to currently addressed device
      if (gpibBus.sendLLO()){
        if (isVerb) dataPort.println(F("Failed to send LLO!"));
      }
    }
  }
  // Set GPIB controls back to idle state
  gpibBus.setControls(CIDS);
}


/***** Send Go To Local (GTL) command *****/
void loc_h(char *params) {
  // REN *MUST* be asserted (LOW)
  if (digitalRead(REN_PIN)==LOW) {
    if (params != NULL) {
      if (strncmp(params, "all", 3) == 0) {
        // Send request to clear all devices to local
        gpibBus.sendAllClear();
      }
    } else {
      // Send GTL to addressed device
      if (gpibBus.sendGTL()) {
        if (isVerb) dataPort.println(F("Failed to send LOC!"));
      }
      // Set GPIB controls back to idle state
      gpibBus.setControls(CIDS);
    }
  }
}


/***** Assert IFC for 150 microseconds *****/
/* This indicates that the AR488 the Controller-in-Charge on
 * the bus and causes all interfaces to return to their idle 
 * state
 */
void ifc_h() {
  if (gpibBus.cfg.cmode==2) {
    // Assert IFC
    gpibBus.assertSignal(IFC_BIT);
    delayMicroseconds(150);
    // De-assert IFC
    gpibBus.clearSignal(IFC_BIT);
    if (isVerb) dataPort.println(F("IFC signal asserted for 150 microseconds"));
  }
}


/***** Send a trigger command *****/
void trg_h(char *params) {
  const uint8_t maxparam = 15;
  char *param;
  uint8_t addrs[maxparam] = {0};
  uint16_t val = 0;
  uint8_t cnt = 0;

  addrs[0] = addrs[0]; // Meaningless as both are zero but defaults compiler warning!

  // Read parameters
  if (params == NULL) {
    // No parameters - trigger addressed device only
    addrs[0] = gpibBus.cfg.paddr;
    cnt++;
  } else {
    // Read address parameters into array
    while (cnt < maxparam) {
      if (cnt == 0) {
        param = strtok(params, " \t");
      } else {
        param = strtok(NULL, " \t");
      }
      if (param == NULL) {
        break;  // Stop when there are no more parameters
      }else{    
        if (notInRange(param, 1, 30, val)) return;
        addrs[cnt] = (uint8_t)val;
        cnt++;
      }
    }
  }

  // If we have some addresses to trigger....
  if (cnt > 0) {
    for (int i = 0; i < cnt; i++) {
      // Sent GET to the requested device
      if (gpibBus.sendGET(addrs[i]))  {
        if (isVerb) dataPort.println(F("Failed to trigger device!"));
        return;
      }
    }

    // Set GPIB controls back to idle state
    gpibBus.setControls(CIDS);

    if (isVerb) dataPort.println(F("Group trigger completed."));
  }
}


/***** Reset the controller *****/
/*
 * Arduinos can use the watchdog timer to reset the MCU
 * For other devices, we restart the program instead by
 * jumping to address 0x0000. This is not a hardware reset
 * and will not reset a crashed MCU, but it will re-start
 * the interface program and re-initialise all parameters. 
 */
void rst_h() {
#ifdef WDTO_1S
  // Where defined, reset controller using watchdog timeout
  unsigned long tout;
  tout = millis() + 2000;
  wdt_enable(WDTO_1S);
  while (millis() < tout) {};
  // Should never reach here....
  if (isVerb) {
    dataPort.println(F("Reset FAILED."));
  };
#elif defined (ESP32)
  ESP.restart();
#elif defined(ARDUINO_ARCH_RP2040)
  rp2040.reboot();
#else
  // Otherwise restart program (soft reset)
  asm volatile ("  jmp 0");
#endif
}


/***** Serial Poll Handler *****/
void spoll_h(char *params) {
  char *param;
  uint8_t addrs[15];
  uint8_t sb = 0;
  enum gpibHandshakeStates state;
  uint8_t j = 0;
  uint16_t addrval = 0;
  bool all = false;
  bool eoiDetected = false;

  // Initialise address array
  for (int i = 0; i < 15; i++) {
    addrs[i] = 0;
  }

  // Read parameters
  if (params == NULL) {
    // No parameters - trigger addressed device only
    addrs[0] = gpibBus.cfg.paddr;
    j = 1;
  }

  // ALL parameter given?
  if (strncasecmp(params, "all", 3) == 0) {
    all = true;
    j = 30;
    if (isVerb) dataPort.println(F("Serial poll of all devices requested..."));
  }

  if (j == 0) {

    // Read address parameters into array
    while (j < 15) {

      if (j == 0) {
        param = strtok(params, " \t");
      } else {
        param = strtok(NULL, " \t");
      }

      // No further parameters so exit 
      if (!param) break;
      
      // Contains only digits
      if (!isNumber(param)) {
        errorMsg(2);
        return;
      }

      // Valid GPIB address parameter length?
      if (strlen(param) > 2) {
        errorMsg(2);
        return;
      }

      // Valid GPIB address parameter ?
      if (notInRange(param, 1, 30, addrval)) return;

      // All good
      addrs[j] = (uint8_t)addrval;
      j++;

    }

  }

  // Send Unlisten [UNL] to all devices
  if ( gpibBus.sendCmd(GC_UNL) )  {
#ifdef DEBUG_SPOLL
    DB_PRINT(F("failed to send UNL"),"");
#endif
    return;
  }

  // Controller addresses itself as listner
  if ( gpibBus.sendCmd(GC_LAD + gpibBus.cfg.caddr) )  {
#ifdef DEBUG_SPOLL
    DB_PRINT(F("failed to send LAD"),"");
#endif
    return;
  }

  // Send Serial Poll Enable [SPE] to all devices
  if ( gpibBus.sendCmd(GC_SPE) )  {
#ifdef DEBUG_SPOLL
    DB_PRINT(F("failed to send SPE"),"");
#endif
    return;
  }

  // Poll GPIB address or addresses as set by i and j
  for (int i = 0; i < j; i++) {

    // Set GPIB address in val
    if (all) {
      addrval = i;
    } else {
      addrval = addrs[i];
    }

    // Don't need to poll own address
    if (addrval != gpibBus.cfg.caddr) {

      // Address a device to talk
      if ( gpibBus.sendCmd(GC_TAD + addrval) )  {

#ifdef DEBUG_SPOLL
        DB_PRINT(F("failed to send TAD"),"");
#endif
        return;
      }

      // Set GPIB control to controller active listner state (ATN unasserted), clear databus and set to input
      gpibBus.setControls(CLAS);
      gpibBus.clearDataBus();

      // Read the response byte (usually device status) using handshake - suppress EOI detection
      state = gpibBus.readByte(&sb, false, &eoiDetected);

      // If we successfully read a byte
      if (state == HANDSHAKE_COMPLETE) {

        // Set GPIB control back to controller active talk state (ATN asserted) 
        gpibBus.setControls(CTAS);

        // Process response
        if (j == 30) {
          // If all, return specially formatted response: SRQ:addr,status
          // but only when RQS bit set
          if (sb & 0x40) {
            dataPort.print(F("SRQ:")); dataPort.print(i); dataPort.print(F(",")); dataPort.println(sb, DEC);
            // Exit on first device to respond
            i = j;
          }
        } else {
          // Return decimal number representing status byte
          dataPort.println(sb, DEC);
          if (isVerb) {
            dataPort.print(F("Received status byte ["));
            dataPort.print(sb);
            dataPort.print(F("] from device at address: "));
            dataPort.println(addrval);
          }
          // Exit on first device to respond
          i = j;
        }
      } else {
        if (isVerb) {
          dataPort.print(F("Failed to retrieve status byte from "));
          dataPort.println(addrval);
        }
      }
    }
  }
  if (all) dataPort.println();

  // Send Serial Poll Disable [SPD] to all devices
  if ( gpibBus.sendCmd(GC_SPD) )  {
#ifdef DEBUG_SPOLL
    DB_PRINT(F("failed to send SPD"),"");
#endif
    return;
  }

  // Send Untalk [UNT] to all devices
  if ( gpibBus.sendCmd(GC_UNT) )  {
#ifdef DEBUG_SPOLL
    DB_PRINT(F("failed to send UNT"),"");
#endif
    return;
  }

  // Unadress listners [UNL] to all devices
  if ( gpibBus.sendCmd(GC_UNL) )  {
#ifdef DEBUG_SPOLL
    DB_PRINT(F("failed to send UNL"),"");
#endif
    return;
  }

  // Set GPIB control to controller idle state
  gpibBus.setControls(CIDS);

  if (isVerb) dataPort.println(F("Serial poll completed."));

}


/***** Return status of SRQ line *****/
void srq_h() {
  //NOTE: LOW=asserted=true=1, HIGH=unasserted=false=0
  dataPort.println(gpibBus.isAsserted(SRQ_PIN));
}


/***** Set the status byte (device mode) *****/
void stat_h(char *params) {
  uint16_t statusByte = 0;
  // A parameter given?
  if (params != NULL) {
    // Byte value given?
    if (notInRange(params, 0, 255, statusByte)) return;
    gpibBus.setStatus((uint8_t)statusByte);
  } else {
    // Return the currently set status byte
    dataPort.println(gpibBus.cfg.stat);
  }
}


/***** Save controller configuration *****/
void save_h() {
#ifdef E2END
  epWriteData(gpibBus.cfg.db, GPIB_CFG_SIZE);
  if (isVerb) dataPort.println(F("Settings saved."));
#else
  dataPort.println(F("EEPROM not supported."));
#endif
}


/***** Show state or enable/disable listen only mode *****/
void lon_h(char *params) {
  uint16_t lval;
  if (params != NULL) {
    if (notInRange(params, 0, 1, lval)) return;
    isRO = lval ? true : false;
    if (isRO) {
      isTO = 0;       // Talk-only mode must be disabled!
      isProm = false; // Promiscuous mode must be disabled!
    }
    if (isVerb) {
      dataPort.print(F("LON: "));
      dataPort.println(lval ? "ON" : "OFF") ;
    }
  } else {
    dataPort.println(isRO);
  }
}


/***** Show help message *****/
void help_h(char *params) {
  char c, t;
  char token[20];
  uint8_t i;

  i = 0;
  for (size_t k = 0; k < strlen_P(cmdHelp); k++) {
    c = pgm_read_byte_near(cmdHelp + k);


    if (i < 20) {
      if(c == ':') {
        token[i] = 0;
        if((params == NULL) || (strcmp(token, params) == 0)) {
          dataPort.print(F("++"));
          dataPort.print(token);
          dataPort.print(c);
          k++;
          t = pgm_read_byte_near(cmdHelp + k);
          dataPort.print(F(" ["));
          dataPort.print(t);
          dataPort.print(F("]"));
          i = 255; // means we need to print until \n
        }
        
      } else {
        token[i] = c;
        i++;
      }
    } else if (i == 255) {
      dataPort.print(c);
    }
    if (c == '\n') {
      i = 0;
    }
  }
}





/***********************************/
/***** CUSTOM COMMAND HANDLERS *****/
/***********************************/

/***** All serial poll *****/
/*
 * Polls all devices, not just the currently addressed instrument
 * This is an alias wrapper for ++spoll all
 */
void aspoll_h() {
  //  char all[4];
  //  strcpy(all, "all\0");
  spoll_h((char*)"all");
}


/***** Send Universal Device Clear *****/
/*
 * The universal Device Clear (DCL) is unaddressed and affects all devices on the Gpib bus.
 */
void dcl_h() {
  if ( gpibBus.sendCmd(GC_DCL) )  {
    if (isVerb) dataPort.println(F("Sending DCL failed"));
    return;
  }
  // Set GPIB controls back to idle state
  gpibBus.setControls(CIDS);
}


/***** Re-load default configuration *****/
void default_h() {
  gpibBus.setDefaultCfg();
}


/***** Show or set end of receive character(s) *****/
void eor_h(char *params) {
  uint16_t val;
  if (params != NULL) {
    if (notInRange(params, 0, 15, val)) return;
    gpibBus.cfg.eor = (uint8_t)val;
    if (isVerb) {
      dataPort.print(F("Set EOR to: "));
      dataPort.println(val);
    };
  } else {
    if (gpibBus.cfg.eor>7) gpibBus.cfg.eor = 0;  // Needed to reset FF read from EEPROM after FW upgrade
    dataPort.println(gpibBus.cfg.eor);
  }
}


/***** Parallel Poll Handler *****/
void ppoll_h() {
  uint8_t sb = 0;

  // Poll devices
  // Start in controller idle state
  gpibBus.setControls(CIDS);
  delayMicroseconds(20);

  // Assert ATN and EOI
  gpibBus.setTransmitMode(TM_SEND);
  gpibBus.assertSignal( ATN_BIT | EOI_BIT );
  gpibBus.setTransmitMode(TM_RECV);
  delayMicroseconds(20);

  // Read data byte from GPIB bus without handshake
  sb = readGpibDbus();

  // Return to controller idle state (ATN and EOI unasserted)
  gpibBus.setControls(CIDS);

  // Output the response byte
  dataPort.println(sb, DEC);

  if (isVerb) dataPort.println(F("Parallel poll completed."));
}


/***** Assert or de-assert REN 0=de-assert; 1=assert *****/
void ren_h(char *params) {
#if defined (SN7516X) && not defined (SN7516X_DC)
  params = params;
  dataPort.println(F("Unavailable")) ;
#else
  // char *stat;
  uint16_t val;
  if (params != NULL) {
    if (notInRange(params, 0, 1, val)) return;
//    val ? gpibBus.assertSignal(REN_PIN) | gpibBus.clearSignal(REN_PIN);
    digitalWrite(REN_PIN, (val ? LOW : HIGH));
    if (isVerb) {
      dataPort.print(F("REN: "));
      dataPort.println(val ? "REN asserted" : "REN un-asserted") ;
    };
  } else {
    dataPort.println(digitalRead(REN_PIN) ? 0 : 1);
  }
#endif
}


/***** Enable verbose mode 0=OFF; 1=ON *****/
void verb_h() {
  isVerb = !isVerb;
  dataPort.print("Verbose: ");
  dataPort.println(isVerb ? "ON" : "OFF");
}


/***** Set version string *****/
/* Replace the standard AR488 version string with something else
 *  NOTE: some instrument software requires a sepcific version string to ID the interface
 */
void setvstr_h(char *params) {
  uint8_t plen;
  char idparams[64];
  const char *vstr = "verstr ";
  plen = strlen(params);
  memset(idparams, '\0', 64);
  strlcpy(idparams, vstr, sizeof(vstr));
  if (plen>47) plen = 47; // Ignore anything over 47 characters
  strncat(idparams, params, plen);

  id_h(idparams);
  
/*  
  if (params != NULL) {
    len = strlen(params);NON
    if (len>47) len=47; 
    memset(AR488.vstr, '\0', 48);
    strncpy(AR488.vstr, params, len);
    if (isVerb) {
      dataPort.print(F("Changed version string to: "));
      dataPort.println(params);
    };
  }
*/  
}


/***** Show state or enable/disable promiscuous mode *****/
void prom_h(char *params) {
  uint16_t pval;
  if (params != NULL) {
    if (notInRange(params, 0, 1, pval)) return;
    isProm = pval ? true : false;
    if (isProm) {
      isTO = 0;     // Talk-only mode must be disabled!
      isRO = false; // Listen-only mode must be disabled!
    }
    if (isVerb) {
      dataPort.print(F("PROM: "));
      dataPort.println(pval ? "ON" : "OFF") ;
    }
  } else {
    dataPort.println(isProm);
  }
}



/***** Talk only mode *****/
void ton_h(char *params) {
  uint16_t toval;
  if (params != NULL) {
    if (notInRange(params, 0, 2, toval)) return;
    isTO = (uint8_t)toval;
    if (isTO>0) {
      isRO = false;   // Read-only mode must be disabled in TO mode!
      isProm = false; // Promiscuous mode must be disabled in TO mode!
    }
  }else{
    if (isVerb) {
      dataPort.print(F("TON: "));
      switch (isTO) {
        case 1:
          dataPort.println(F("ON unbuffered"));
          break;
        case 2:
          dataPort.println(F("ON buffered"));
          break;
        default:
          dataPort.println(F("OFF"));
      }
    }
    dataPort.println(isTO);
  }
}


/***** SRQ auto - show or enable/disable automatic spoll on SRQ *****/
/*
 * When SRQ auto is set to 1 and a decivce triggers thw SRQ
 * signal, a serial poll is conducted automatically and
 * the status byte for the instrument requiring service gets
 * returned automatically. When srqauto is set to 0 (default)
 * an ++spoll command needs to be given manually to return
 * the status byte.
 */
void srqa_h(char *params) {
  uint16_t val;
  if (params != NULL) {
    if (notInRange(params, 0, 1, val)) return;
    switch (val) {
      case 0:
        isSrqa = false;
        break;
      case 1:
        isSrqa = true;
        break;
    }
    if (isVerb) dataPort.println(isSrqa ? "SRQ auto ON" : "SRQ auto OFF") ;
  } else {
    dataPort.println(isSrqa);
  }
}


/***** Repeat a given command and return result *****/
void repeat_h(char *params) {

  uint16_t count;
  uint16_t tmdly;
  char *param;

  if (params != NULL) {
    // Count (number of repetitions)
    param = strtok(params, " \t");
    if (strlen(param) > 0) {
      if (notInRange(param, 2, 255, count)) return;
    }
    // Time delay (milliseconds)
    param = strtok(NULL, " \t");
    if (strlen(param) > 0) {
      if (notInRange(param, 0, 30000, tmdly)) return;
    }

    // Pointer to remainder of parameters string
    param = strtok(NULL, "\n\r");
    if (strlen(param) > 0) {
      for (uint16_t i = 0; i < count; i++) {
        // Send string to instrument
        gpibBus.sendData(param, strlen(param));
        delay(tmdly);
        gpibBus.receiveData(dataPort, gpibBus.cfg.eoi, false, 0);
      }
    } else {
      errorMsg(2);
      if (isVerb) dataPort.println(F("Missing parameter"));
      return;
    }
  } else {
    errorMsg(1);
    if (isVerb) dataPort.println(F("Missing parameters"));
  }

}


/***** Take Control command *****/
void tct_h(char *params){
  uint16_t val;
  bool tctfail = false;
  if (params != NULL) {
    if (notInRange(params, 0, 30, val)) return;
    if (val == gpibBus.cfg.caddr) {
      errorMsg(2);
      if (isVerb) dataPort.println(F("That is my address! Please provide the address of a remote device."));
      return;
    }

    tctfail = gpibBus.sendTCT(val);

    if (isVerb) {
      dataPort.print(F("Sending TCT to device at address "));
      dataPort.print(val);
    }
    
    if (tctfail) {
      if (isVerb) dataPort.println(F(" failed!"));
      return;
    }else{
      if (isVerb) dataPort.println(F(" succeeded."));
      gpibBus.startDeviceMode();
      if (isVerb) dataPort.println(F("Switched to device mode."));
    }
  }
}


/***** Run a macro *****/
void macro_h(char *params) {
#ifdef USE_MACROS
  uint16_t val;
  const char * macro;

  if (params != NULL) {
    if (notInRange(params, 0, 9, val)) return;
    //    execMacro((uint8_t)val);
    runMacro = (uint8_t)val;
  } else {
    for (int i = 0; i < 10; i++) {
      macro = (pgm_read_word(macros + i));
      //      dataPort.print(i);dataPort.print(F(": "));
      if (strlen_P(macro) > 0) {
        dataPort.print(i);
        dataPort.print(" ");
      }
    }
    dataPort.println();
  }
#else
  memset(params, '\0', 5);
  dataPort.println(F("Disabled"));
#endif
}


/***** Bus diagnostics *****/
/*
 * Usage: xdiag mode byte
 * mode: pins=sho state of all pins; 0=data bus; 1=control bus
 * byte: byte to write on the bus
 * Note: values to switch individual bits = 1,2,4,8,10,20,40,80
 * States revert to controller or device mode after 10 seconds
 * Databus reverts to 0 (all HIGH) after 10 seconds
 */
void xdiag_h(char *params){
  char *param;
  uint8_t mode = 0;
  uint8_t byteval = 0;
  
  // Get first parameter (mode = 0 or 1)
  param = strtok(params, " ,\t");

  if ( strncasecmp(param, "pins", 4) ==0) {
    printDbPinout();
    printCtrlPinout();
    return;
  }

  if (param != NULL) {
    if (strlen(param)<4){
      mode = atoi(param);
      if (mode>2) {
        dataPort.println(F("Invalid: 0=data bus; 1=control bus"));
        return;
      }
    }
  }

  // Get second parameter (8 bit byte)
  param = strtok(NULL, " \t");
  if (param != NULL) {
    if (strlen(param)<4){
      byteval = atoi(param);
    }

    switch (mode) {
      case 0:
          // Set to required value
          gpibBus.setDataVal(byteval);
          delay(20);
          printDbPinout();
          // Reset after 10 seconds
          delay(10000);
          gpibBus.setDataVal(0);
          break;
      case 1:
          gpibBus.setControlVal(~byteval);
          delay(20);
          printCtrlPinout();
          // Reset after 10 seconds
          delay(10000);
          if (gpibBus.cfg.cmode==2) {
            gpibBus.setControls(CINI);
          }else{
            gpibBus.setControls(DINI);
          }
          break;
    }

  }

}


/***** Print the pinout and pin states for the data bus *****/
void printDbPinout(){
  printPin(F("DIO1"), DIO1_PIN);
  printPin(F("DIO2"), DIO2_PIN);
  printPin(F("DIO3"), DIO3_PIN);
  printPin(F("DIO4"), DIO4_PIN);
  printPin(F("DIO5"), DIO5_PIN);
  printPin(F("DIO6"), DIO6_PIN);
  printPin(F("DIO7"), DIO7_PIN);
  printPin(F("DIO8"), DIO8_PIN);
}


/***** Print the pinout and pin states of the control bus *****/
void printCtrlPinout(){
  printPin(F("IFC"), IFC_PIN);
  printPin(F("NDAC"), NDAC_PIN);
  printPin(F("NRFD"), NRFD_PIN);
  printPin(F("DAV"), DAV_PIN);
  printPin(F("EOI"), EOI_PIN);
  printPin(F("SRQ"), SRQ_PIN);
  printPin(F("REN"), REN_PIN);
  printPin(F("ATN"), ATN_PIN);
}


void printPin(const __FlashStringHelper* pinid, uint8_t pin){
  char line[50];
  char pname[7];
  strcpy_P(pname, (const char PROGMEM *)pinid);
  sprintf( line, "%s: \t[%d] \t%d", pname, pin, digitalRead(pin) );
  dataPort.println(line);
}



/***** Set device ID *****/
/*
 * Sets the device ID parameters including:
 * ++id verstr - version string (same as ++setvstr)
 * ++id name   - short name of device (e.g. HP3478A) up to 15 characters
 * ++id serial - serial number up to 9 digits long
 */
void id_h(char *params) {
  uint8_t dlen = 0;
  char * keyword; // Pointer to keyword following ++id
  char * datastr; // Pointer to supplied data (remaining characters in buffer)
  char serialStr[10];

#ifdef DEBUG_IDFUNC
  DB_PRINT(F("Params: "), params);
#endif

  if (params != NULL) {
    keyword = strtok(params, " \t");
    datastr = keyword + strlen(keyword) + 1;
    dlen = strlen(datastr);
    if (dlen) {
      if (strncasecmp(keyword, "verstr", 6)==0) {
#ifdef DEBUG_IDFUNC
        DB_PRINT(F("Keyword: "), keyword);
        DB_PRINT(F("DataStr: "), datastr);
#endif
        if (dlen>0 && dlen<48) {
#ifdef DEBUG_IDFUNC
        DB_PRINT(F("Length OK"),"");
#endif
          memset(gpibBus.cfg.vstr, '\0', 48);
          strncpy(gpibBus.cfg.vstr, datastr, dlen);
          if (isVerb) dataPort.print(F("VerStr: "));dataPort.println(gpibBus.cfg.vstr);
        }else{
          if (isVerb) dataPort.println(F("Length of version string must not exceed 48 characters!"));
          errorMsg(2);
        }
        return;
      }
      if (strncasecmp(keyword, "name", 4)==0) {
        if (dlen>0 && dlen<16) {
          memset(gpibBus.cfg.sname, '\0', 16);
          strncpy(gpibBus.cfg.sname, datastr, dlen);
        }else{
          if (isVerb) dataPort.println(F("Length of name must not exceed 15 characters!"));
          errorMsg(2);
        }
        return;
      }
      if (strncasecmp(keyword, "serial", 6)==0) {
        if (dlen < 10) {
          gpibBus.cfg.serial = atol(datastr);
        }else{
          if (isVerb) dataPort.println(F("Serial number must not exceed 9 characters!"));
          errorMsg(2);
        }
        return;
      }
    }else{
      if (strncasecmp(keyword, "verstr", 6)==0) {
        dataPort.println(gpibBus.cfg.vstr);
        return;
      }
      if (strncasecmp(keyword, "fwver", 6)==0) {
        dataPort.println(F(FWVER));
        return;
      }
      if (strncasecmp(keyword, "name", 4)==0) {
        dataPort.println(gpibBus.cfg.sname);
        return;      
      } void addr_h(char *params);
      if (strncasecmp(keyword, "serial", 6)==0) {
        unsigned long int serialnum = gpibBus.cfg.serial;
        memset(serialStr, '\0', 10);
        snprintf(serialStr, 10, "%09lu", serialnum);  // Max str length = 10-1 i.e 9 digits + null terminator 
        dataPort.println(serialStr);
        return;    
      }
    }
  }
  errorMsg(0);
#ifdef DEBUG_IDFUNC
    DB_PRINT(F("done."),"");
#endif
}


void idn_h(char * params){
  uint16_t val;
  if (params != NULL) {
    if (notInRange(params, 0, 2, val)) return;
    gpibBus.cfg.idn = (uint8_t)val;
    if (isVerb) {
      dataPort.print(F("Sending IDN: "));
      dataPort.print(val ? "Enabled" : "Disabled"); 
      if (val==2) dataPort.print(F(" with serial number"));
      dataPort.println();
    };
  } else {
    dataPort.println(gpibBus.cfg.idn, DEC);
  }  
}


/***** Handshaking indicator flags *****/
/*
 * flags & 0x01 = AR488~RDY
 * flass & 0x02 = Read^OK
 * flags & 0x04 = Send^OK
 */
void hflags_h(char * params) {
  uint16_t val;
  if (params != NULL) {
    if (notInRange(params, 0, 7, val)) return;
    gpibBus.cfg.hflags = (uint8_t)val;
  }else{
    dataPort.println(gpibBus.cfg.hflags);
  }
}


/***** Fine all listeners *****/

bool isRange(char * rangestr, size_t rsize, unsigned long values[2] ) {
  char * fp = NULL;

  for (uint8_t i=0; i<rsize; i++) {
    if (rangestr[i] == '-') {
      if (!i) return false;
      fp = &rangestr[i+1];
      values[0] = strtoul(rangestr, NULL, 10);
      values[1] = strtoul(fp, NULL, 10);
      if (values[1] > values[0]) return true;
    }
  }

  return false;
}


void fndl_h(char *params) {
  char *param;
  uint16_t addrval = 0;
  uint8_t addrList[15] = {0};
  uint16_t tmo = gpibBus.cfg.rtmo;
  uint8_t acnt = 0;
//  uint8_t xmit = true;
  uint8_t i = 0;
  uint8_t j = 0;
  uint8_t pri = 0xFF;
  unsigned long range[2] = {0,0};
  bool list = false;
  bool secfound = false;

  // Initialise arrays
  for (int i = 0; i < 15; i++) {
    addrList[i] = 0;
  }

  // Set minimal timeout
  gpibBus.cfg.rtmo = 35;

  // Read parameters
  if (params == NULL) {
    // No parameters given - no action to be taken
    errorMsg(1);
    return;
  }

  // Is it a range?
  if ( isRange(params, strlen(params), range) ) {
    if (range[0]<30 && range[1]<31) {
      i = (uint8_t)range[0];
      j = (uint8_t)range[1] + 1;
    }else{
      errorMsg(2);
      return;
    }
  }

  // Requested 'all'?
  if ( strncasecmp(params, "all", 4) == 0) {
    j = 31;
  }

  if (j==0) {
    // Read address parameters into array
    while (j < 15) {
      if (j == 0) {
        param = strtok(params, " ,\t");
      } else {
        param = strtok(NULL, " ,\t");
      }

      // No further parameters so exit 
      if (!param) break;

      // Valid GPIB address parameter ?
      if (strlen(param) > 2) {
        errorMsg(2);
        return;
      }

      // Contains only digits
      if (!isNumber(param)) {
        errorMsg(2);
        return;
      }

      // Valid range
      if (notInRange(param, 0, 30, addrval)) return;
      addrList[j] = (uint8_t)addrval;
      j++;

    }

    list = true;

  }

  // Poll the range of GPIB adresses
  while (i<j) {

    // Get from list or use actual value of iterator?
    if (list) {
      pri = addrList[i];
    }else{
      pri = i;
    }

    // Ignore the controller address
    if (pri == gpibBus.cfg.caddr) {
      i++;
      continue;
    }

//Serial.print("PRI: ");
//Serial.println(pri);

    // Send UNL + UNT + LAD (addressDevice function adds 0x20 to pri)
    if (gpibBus.addressDevice(pri, 0xFF, TOLISTEN) == ERR) {
      errorMsg(3);
      break;
    }

    gpibBus.clearSignal(ATN_BIT);
    delayMicroseconds(1600);

    if (gpibBus.isAsserted(NDAC_PIN)) {
 
      if (acnt>0) Serial.print(',');
      dataPort.print(pri);
      acnt++;

    }else{

      // Send all secondary addresses
      gpibBus.assertSignal(ATN_BIT);
      for (uint8_t sec=0x60; sec<0x7F; sec++){
        gpibBus.writeByte(sec, false);
      }
      
      gpibBus.clearSignal(ATN_BIT);
      delayMicroseconds(1600);

      if (gpibBus.isAsserted(NDAC_PIN)) {
        gpibBus.assertSignal(ATN_BIT);
        gpibBus.writeByte(GC_UNL, false);
        gpibBus.writeByte( (pri+0x20), false ); // LAD

        for (uint8_t sec=0x60; sec<0x7F; sec++){
          gpibBus.writeByte(sec, false);
          gpibBus.clearSignal(ATN_BIT);
          delayMicroseconds(1600);
          if (gpibBus.isAsserted(NDAC_PIN)) {
            if (acnt>0) dataPort.print(',');
            acnt++;
            dataPort.print(pri);
            dataPort.print(':');
            dataPort.print(sec);

            gpibBus.assertSignal(ATN_BIT);
            gpibBus.writeByte(GC_UNL, false);
            gpibBus.writeByte((pri+0x20), false); // LAD
          }else{
            gpibBus.assertSignal(ATN_BIT);
            gpibBus.writeByte(GC_UNT, false);
          }
//          delayMicroseconds(50);
        }

        gpibBus.clearSignal(ATN_BIT);
        delayMicroseconds(1600);

      }

    } // End if NDAC aserted (else)

    gpibBus.setControls(CIDS);
//    delay(50);
    i++;

  } // END while

  dataPort.println();
  gpibBus.cfg.rtmo = tmo;
//  if (xmit) gpibBus.sendCmd(GC_UNL);
  gpibBus.setControls(CIDS);

}


/***** Send to secondary address *****/
/*
  Parameters: pri,sec,data
  pri, sec = GPIB addresses between 0 and 30
  data is optional
*/
//void secsend_h(char *params) {
void send_h(char *params) {
  char * param;
  char * data;
  uint8_t pri = 0xFF;
  uint8_t sec = 0xFF;
  uint16_t val;

  if (params != NULL) {
    // 1st parameter (must be an address value)
    param = strtok(params, " ,\t");

    // Are addresses numerical
    if (!isNumber(param)) {
      errorMsg(2);
      return;
    }

    // Primary address in range ?
    val = strtoul(param, NULL, 10);
    if (val>30) {
      errorMsg(2);
      return;
    }

    // Not using controller address ?
    if (val == gpibBus.cfg.caddr) {
      errorMsg(2);
      return;
    }

    pri = (uint8_t)val;

    // 2nd parameter (secondary address value or data)
    param = strtok(NULL, " ,\t");

    if (isNumber(param)) {
      // Secondary address in range ?
      val = strtoul(param, NULL, 10);
      if (val<31) val = val + 0x60;
      if (val<0x60 || val>0x7E) {
        errorMsg(2);
        return;
      }
      sec = (uint8_t)val;

      // 3rd parameter
      param = strtok(NULL, "\0");

    }

    gpibBus.unAddressDevice();
    gpibBus.addressDevice(pri, sec, TOLISTEN);
    gpibBus.sendData(param, strlen(param));

    if (gpibBus.cfg.amode == 1) {
      gpibBus.addressDevice(pri, sec, TOTALK);
      gpibBus.receiveData(dataPort, gpibBus.cfg.eoi, false, 0);
//      gpibBus.unAddressDevice();
    }

    gpibBus.unAddressDevice();

  }else{
    errorMsg(1);
  }

}


/***** Read from secondary address *****/
/*
  Parameters: pri,sec
  pri, sec = GPIB addresses between 0 and 30
*/
/*
void secread_h(char *params) {
  char * pristr;
  char * secstr;
  uint8_t pri;
  uint8_t sec;
  unsigned long val;

  if (params != NULL) {
    pristr = strtok(params, " ,\t");
    secstr = strtok(NULL, " ,\t");

    // Are addresses numerical
    if ( (!isNumber(pristr)) || (!isNumber(secstr)) ) {
      errorMsg(2);
      return;
    }

    // Primary address in range ?
    val = strtoul(pristr, NULL, 10);
    if (val>30) {
      errorMsg(2);
      return;
    }
    pri = (uint8_t)val;

    // Secondary address in range ?
    val = strtoul(secstr, NULL, 10);
    if (val<31) val = val + 0x60;
    if (val<0x60 || val>0x7E) {
      errorMsg(2);
      return;
    }
    sec = (uint8_t)val;

    // Not using controller address ?
    if (pri == gpibBus.cfg.caddr) {
      errorMsg(2);
      return;
    }

    gpibBus.unAddressDevice();
    gpibBus.setControls(CIDS);
    delay(50);
    gpibBus.addressDevice(pri, sec, TOTALK);
    gpibBus.receiveData(dataPort, true, false, 0);
    gpibBus.unAddressDevice();

  }else{
    errorMsg(1);
  }

}
*/

/***** Send device clear (usually resets the device to power on state) *****/
void unlisten_h() {
  if (gpibBus.sendUNL())  {
    if (isVerb) dataPort.println(F("Failed to send UNL"));
    return;
  }
  // Set GPIB controls back to idle state
  gpibBus.setControls(CIDS);
}


/***** Send device clear (usually resets the device to power on state) *****/
void untalk_h() {
  if (gpibBus.sendUNT())  {
    if (isVerb) dataPort.println(F("Failed to send UNT"));
    return;
  }
  // Set GPIB controls back to idle state
  gpibBus.setControls(CIDS);
}



/******************************************************/
/***** Device mode GPIB command handling routines *****/
/******************************************************/

/***** Attention handling routine *****/
/*
 * In device mode is invoked whenever ATN is asserted
 */
void attnRequired() {

  const uint8_t cmdbuflen = 35;
  uint8_t cmdbytes[cmdbuflen] = {0};
  uint8_t db = 0;
  bool eoiDetected = false;
  uint8_t gpibcmd = 0;
  uint8_t bytecnt = 0;
  uint8_t atnstat = 0;
  uint8_t ustat = 0;
  bool addressed = false;

#ifdef EN_STORAGE
  uint8_t saddrcmd = 0;
#endif

#ifdef DEBUG_DEVICE_ATN
  uint8_t cmdbyteslist[cmdbuflen] = {0};
  uint8_t listbytecnt = 0;
#endif

  // Set device listner active state (assert NDAC+NRFD (low), DAV=INPUT_PULLUP)
  gpibBus.setControls(DLAS);

  /***** ATN read loop *****/
  // Read bytes received while ATN is asserted
  while ( (gpibBus.isAsserted(ATN_PIN)) && (bytecnt<cmdbuflen) ) {

    // Read the next byte from the bus, no EOI detection. Exit loop on error·
    if (gpibBus.readByte(&db, false, &eoiDetected) != HANDSHAKE_COMPLETE ) break;

    // Untalk or unlisten
    cmdbytes[bytecnt] = db;
    bytecnt++;

#ifdef DEBUG_DEVICE_ATN
    cmdbyteslist[listbytecnt] = db;
    listbytecnt++;
#endif
  }

  // ATN read loop completed
  atnstat |= 0x01;

  /***** Promiscuous mode *****/
  // Don't process anything, just listen and repeat to USB
  if (isProm) {
    device_listen_h();
    gpibBus.setControls(DINI);
    return;
  }

  
  /***** Command process loop *****/
  // Process received addresses and command tokens
  if (bytecnt>0) {

    // Process received command tokens
    for (uint8_t i=0; i<bytecnt; i++) { 

//      if (!cmdbytes[i]) break;  // End loop on zero

      db = cmdbytes[i];

      // Unlisten
      if (db == 0x3F) {
        if (!device_unl_h()) ustat &= ~0x01; // Clears bit if UNL was not required
        continue;
      }

      // Untalk
      if (db == 0x5F) {
        if (!device_unt_h()) ustat &= ~0x02; // Clears bit if UNT was not required
        continue;
      }

      // Device is addressed to listen
      if (gpibBus.cfg.paddr == (db ^ 0x20)) { // MLA = db^0x20
        atnstat |= 0x02;
        addressed = true;
        gpibBus.setControls(DLAS);

      // Device is addressed to talk
      }else if (gpibBus.cfg.paddr == (db ^ 0x40)) { // MLA = db^0x40
        // Call talk handler to send data
        atnstat |= 0x04;
        addressed = true;
        gpibBus.setControls(DTAS);

#ifdef EN_STORAGE
      }else if (db>0x5F && db<0x80) {
        // Secondary addressing command received
        saddrcmd = db;
        atnstat |= 0x10;
#endif

      }else if (db<0x20){
        // Primary command received
        gpibcmd = db;
        if (gpibcmd == 0x18) isSpoll = true;
        if (gpibcmd == 0x19) isSpoll = false;
        atnstat |= 0x08;
      }

    }   // End for

  } // ATN bytes processed

  
  /***** If we have not been adressed then back to idle and exit loop *****/
  if (!addressed) {
    gpibBus.setControls(DINI);
#ifdef DEBUG_DEVICE_ATN
    showATNStatus(atnstat, ustat, cmdbyteslist, listbytecnt);
#endif
    return;
  }

  /***** If addressed, then perform the appropriate actions *****/
  if (addressed) {

    // Serial poll requested progress?
    if (!gpibcmd && isSpoll) {
      gpibcmd = 0x18;
      isSpoll = false;
    }

    // If we have a primary GPIB command then execute it
    if (gpibcmd) {
      // Respond to GPIB command
      execGpibCmd(gpibcmd);
      // Clear flags
      gpibcmd = 0;
      atnstat |= 0x20;
#ifdef DEBUG_DEVICE_ATN
      showATNStatus(atnstat, ustat, cmdbyteslist, listbytecnt);
#endif
      return;      
    }

#ifdef EN_STORAGE
    // If we have a secondary address then perform secondary GPIB command actions *****/
    if (addressed && saddrcmd) {
      // Execute the GPIB secondary addressing command
      storage.storeExecCmd(saddrcmd);
      // Clear secondary address command
      saddrcmd = 0;
      atnstat |= 0x40;
  #ifdef DEBUG_DEVICE_ATN
      showATNStatus(atnstat, ustat, cmdbyteslist, listbytecnt, rstat);
  #endif
      return;
    }
#endif

    // If no GPIB commands but addressed to listen then just listen
    if (gpibBus.isDeviceAddressedToListen()) {
      device_listen_h();
      atnstat |= 0x80;
      gpibBus.setControls(DIDS);
#ifdef DEBUG_DEVICE_ATN
      DB_PRINT(F("Listen done."),"");
      showATNStatus(atnstat, ustat, cmdbyteslist, listbytecnt);
#endif
      return;
    }
  
    // If no GPIB commands but addressed to talk then send data
    if (gpibBus.isDeviceAddressedToTalk()) {
      device_talk_h();
      atnstat |= 0x80;
      gpibBus.setControls(DIDS);
#ifdef DEBUG_DEVICE_ATN
      DB_PRINT(F("Talk done."),"");
      showATNStatus(atnstat, ustat, cmdbyteslist, listbytecnt);
#endif
      return;
    }

  }

#ifdef DEBUG_DEVICE_ATN
  DB_PRINT(F("ATN: Nothing to process!"),"");
  showATNStatus(atnstat, ustat, cmdbyteslist, listbytecnt);
#endif

}


#ifdef DEBUG_DEVICE_ATN
void showATNStatus(uint8_t atnstat, uint8_t ustat, uint8_t atnbytes[], size_t bcnt) {

  if (ustat & 0x01) DB_PRINT(F("unlistened."),"");
  if (ustat & 0x02) DB_PRINT(F("untalked."),"");

  if (atnstat & 0x01) DB_PRINT(F("ATN read loop completed."),"");
  if (atnstat & 0x02) DB_PRINT(F("addressed to LISTEN."),"");
  if (atnstat & 0x04) DB_PRINT(F("addressed to TALK."),"");
  if (atnstat & 0x08) DB_PRINT(F("primary command received."),"");
  if (atnstat & 0x10) DB_PRINT(F("secondary command received."),"");
  if (atnstat & 0x20) DB_PRINT(F("primary command done."),"");
  if (atnstat & 0x40) DB_PRINT(F("secondary command done."),"");
  if (atnstat & 0x80) DB_PRINT(F("data transfer done."),"");

  DB_HEXA_PRINT(F("ATN bytes received: "), atnbytes, bcnt);
  DB_PRINT(bcnt,F(" ATN bytes read."));
//  DB_PRINT(F("Error status: "),rstat);

  DB_PRINT(F("END attnReceived.\n\n"),"");

}
#endif


/***** Execute GPIB command while in device mode *****/
void execGpibCmd(uint8_t gpibcmd){

  // Respond to GPIB command
  switch (gpibcmd) {
    case GC_SPE:
      // Serial Poll enable request
#ifdef DEBUG_DEVICE_ATN
        DB_PRINT(F("Received serial poll enable."),"");
#endif
        device_spe_h();
        break;
      case GC_SPD:
        // Serial poll disable request
#ifdef DEBUG_DEVICE_ATN
        DB_PRINT(F("Received serial poll disable."),"");
#endif
        device_spd_h();
        break;       
    case GC_UNL:
        // Unlisten
        device_unl_h();
        break;
    case GC_UNT:
        // Untalk
        device_unt_h();
        break;
    case GC_SDC:
        // Device clear (reset)
        device_sdc_h();
        break;
    case GC_TCT:
        // Take control
        device_tct_h();
        break;
#ifdef REMOTE_SIGNAL_PIN
    case GC_LLO:
        // Remote lockout mode
        device_llo_h();
        break;
    case GC_GTL:
        // Local mode
        device_gtl_h();
        break;
#endif
  } // End switch

}


/***** Device is addressed to listen - so listen *****/
void device_listen_h(){
  // Receivedata params: stream, detectEOI, detectEndByte, endByte
  gpibBus.receiveData(dataPort, false, false, 0x0);
}


/***** Device is addressed to talk - so send data *****/
void device_talk_h(){
  DB_PRINT("LnRdy: ", lnRdy);
  DB_PRINT("Buffer: ", pBuf);
  if (lnRdy == 2) gpibBus.sendData(pBuf, pbPtr);
  // Flush the parse buffer and clear line ready flag
  flushPbuf();
  lnRdy = 0;
}


/***** Selected Device Clear *****/
void device_sdc_h() {
  // If being addressed then reset
  if (isVerb) dataPort.println(F("Resetting..."));
#ifdef DEBUG_DEVICE_ATN
  DB_PRINT(F("Reset adressed to me: "),"");
#endif
  rst_h();
  if (isVerb) dataPort.println(F("Reset failed."));
}


/***** Serial Poll Disable Request *****/
void device_spd_h() {
#ifdef DEBUG_DEVICE_ATN
  DB_PRINT(F("<- serial poll request ended."),"");
#endif
  gpibBus.setControls(DIDS);
}


/***** Serial Poll Enable Request *****/
void device_spe_h() {
#ifdef DEBUG_DEVICE_ATN
  uint8_t stat = gpibBus.cfg.stat;
  DB_PRINT(F("Serial poll request received from controller ->"),"");
#endif
  // Send the status byte
  gpibBus.sendStatus();
#ifdef DEBUG_DEVICE_ATN
  DB_PRINT(F("Status sent: "), (stat & ~0x40));
#endif
}


/***** Take control *****/
void device_tct_h(){
#ifdef DEBUG_DEVICE_ATN
  DB_PRINT(F("Take control (TCT) request received from controller."),"");
#endif
  gpibBus.startControllerMode();
#ifdef DEBUG_DEVICE_ATN
  DB_PRINT(F("Switched to controller mode."), "");
#endif
}


/***** Unlisten *****/
bool device_unl_h() {
  // Stop receiving and go to idle
  readWithEoi = false;
  // Immediate break - shouldn't ATN do this anyway?
//  tranBrk = 3;  // Stop receving transmission
  // Clear addressed state flag and set controls to idle
  if (gpibBus.isDeviceAddressedToListen()) {
    gpibBus.setControls(DIDS);
    return true;
  }
  return false;
}


/***** Untalk *****/
bool device_unt_h(){
  // Stop sending data and go to idle
  // Clear addressed state flag and set controls to listen
  if (gpibBus.isDeviceAddressedToTalk()) {
    gpibBus.setControls(DIDS);
    gpibBus.clearDataBus();
    return true;
  }
  return false;
}


#ifdef REMOTE_SIGNAL_PIN
/***** Enabled remote mode *****/
void device_llo_h(){
  digitalWrite(REMOTE_SIGNAL_PIN, HIGH);
}


/***** Disable remote mode *****/
void device_gtl_h(){
  digitalWrite(REMOTE_SIGNAL_PIN, LOW);
}
#endif


void lonMode(){

  uint8_t db = 0;
  enum gpibHandshakeStates state;
  bool eoiDetected = false;

  // Set bus for device listner active mode
  gpibBus.setControls(DLAS);

  while (isRO) {

    state = gpibBus.readByte(&db, false, &eoiDetected);
    if (state == HANDSHAKE_COMPLETE) dataPort.write(db);

    // Check whether there are charaters waiting in the serial input buffer and call handler
    if (dataPort.available()) {

      lnRdy = serialIn_h();

      // We have a command so return to main loop and execute it
      if (lnRdy==1) break;

      // Clear the buffer to prevent it getting blocked
      if (lnRdy==2) flushPbuf();

    }

  }

  // Set bus to idle
  gpibBus.setControls(DIDS);

}


/***** Talk only mpode *****/
void tonMode(){

  // Set bus for device taker active mode
  gpibBus.setControls(DTAS);

  while (isTO>0) {

    // Check whether there are charaters waiting in the serial input buffer and call handler
    if (dataPort.available()) {

      if (isTO == 1) {
        // Unbuffered version
        gpibBus.writeByte(dataPort.read(), false);
      }

      if (isTO == 2) {
        
        // Buffered version
        lnRdy = serialIn_h();

        // We have a command return to main loop and execute it
        if (lnRdy==1) break;

        // Otherwise send the buffered data
        if (lnRdy==2) {
          for (uint8_t i=0; i<pbPtr; i++){
            gpibBus.writeByte(pBuf[i], false);  // False = No EOI
          }
          flushPbuf();
        }
        
      }

    }

  }

  // Set bus to idle
  gpibBus.setControls(DIDS);

}
