Twilight-Logic/AR488/src-refactored/AR488/EEPROM_Handler.h

#ifndef EEPROM_HANDLER_H
#define EEPROM_HANDLER_H

#include <Arduino.h>
#include <EEPROM.h>
#include "AR488_Config.h"
#include "AR488_ComPorts.h"
#include "GPIBbus_Handler.h"
#include "Utility_Helper.h"



/*=============================================================*\
||                                                             ||
||       AR488 GPIB Interface,  ver. 0.55.22, 05/07/2026       ||
||   Twilight Logic, https://github.com/Twilight-Logic/AR488   ||
||                                                             ||
||                        EEPROM HANDLER                       ||
||                                                             ||
\*=============================================================*/


/*
 * EEPROM SIZES:
 * 
 * ATmega2560/1284   4096   // Mega 2560, MightyCore 1284 
 * ATmega644         2048   // MightyCore 644
 * ATmega328/32u4    1024   // Uno, Nano, Leonardo
 * ATmega168          512
 * ATmega4809         256   // Nano Every
 * ESP8266/ESP32     none   // Emulated. 512kb assigned?
 * RASPBERRY PICO       ?
 * TEENSY 4/4.1         ?
 */

#ifdef EEPROM_ENABLED


#define EESIZE 256
#define EESTART 2    // EEPROM start of data - min 4 for CRC32, min 2 for CRC16
#define UPCASE true

#define EEPM_FUNC_TYPE_VOID  0x40
#define EEPM_FUNC_TYPE_PARAM 0x80


const uint16_t eesize = EESIZE;
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
