Twilight-Logic/AR488/(commit log)

2019-09-19 Tested pro_micro SRQ interrupt handling and changed interrupt setup as a result
2021-12-18 Fix "btSerial" multiple definition problem
    Declaring the global variable in header file can have issues. Validated this issue and fix under Arduino 1.8.18 and Arduino 2.00-rc2 released on 2021-12-13.
    [AR488_Config.h]
2023-12-15 Revert "wrap setGpibState calls in something easier to read"
    [AR488.ino, AR488_GPIBbus.cpp, AR488_GPIBbus.h, AR488_Layouts.cpp, AR488_Layouts.h]
2024-02-14 Added ESP32 layout
2024-02-16 Added layouts for ESP32 boards
2024-03-18 HPO3478A cal data fix
    [AR488.ino, AR488_Config.h, AR488_GPIBbus.cpp, AR488_GPIBbus.h]
2024-03-18 HP3478A cal data fix
    [AR488.ino, AR488_Config.h, AR488_GPIBbus.cpp, AR488_GPIBbus.h]
2025-04-17 EESIZE was set too big for some processors
    [AR488_Eeprom.h]
